Orange-OpenSource/BaahBox-Arduino/README.md

# Présentation
Cliquez sur l'image ci-dessous pour accéder à la présentation du projet Baah Box.

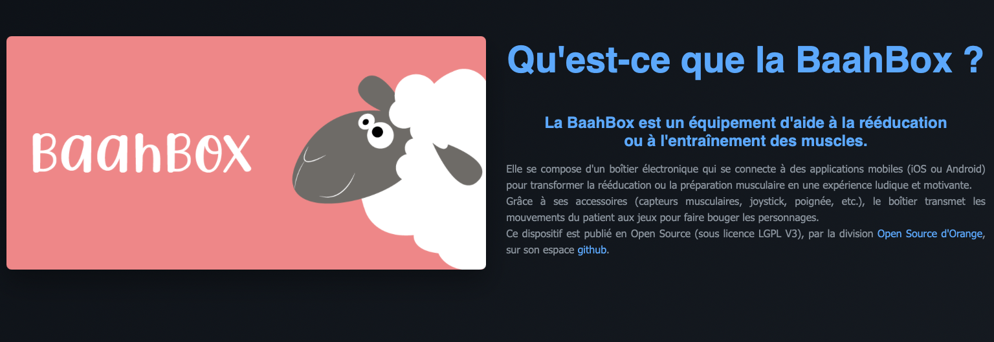
[picture p1: docs/assets/images/snapShopBBoxDoc.png]
BaahBoxPix (https://orange-opensource.github.io/BaahBox-Arduino/)
