Orange-OpenSource/BaahBox-Arduino/documentation/fr/BaahBoxBoM.md

# Liste du matériel / BOM 

Bom

* 1 feather M0 Bluefruit  (Adafruit Feather M0 Bluefruit LE)
 https://www.adafruit.com/product/2995 
   avec broches empilables courtes / with Header Kit for Feather
 https://www.adafruit.com/product/2886  

* 1 Feather Wing lecteur de carte SD / Adalogger FeatherWing - RTC + SD
https://www.adafruit.com/product/2922 
avec broches empilables longues / Stacking Headers for Feather
https://www.adafruit.com/product/2830 
 
* 1 Feather Wing écran OLED 128x32 (assemblée) / assembled Adafruit FeatherWing OLED 
 https://www.adafruit.com/product/3045 
  
* 1 carte mini SD (4 Go) / mini SD Card

* 1 batterie LiPo (max 1200 mA pour que cela rentre dans le boîtier)
   Lithium Ion Polymer Battery - 3.7v 1000 or 1200mAh 
   https://www.adafruit.com/product/258

* 1 interrupteur de type switch / Breadboard-friendly SPDT Slide Switch
 https://www.adafruit.com/product/805 
  
* 1  câble de connection JST-PH / 1 JST-PH Battery Extension Cable - 500mm 
 https://www.adafruit.com/product/1131
 
* 2 x 3.5mm connecteur jacks stéréo femelle / 2x 3.5 female Jack connectors
 
* 1 connecteur femelle  (Sub-D) DB9 / 1 Sub-D DB9 female connector
 
* 4 vis M2.5 x 25 ou 22 + écrous pour visser la feather sur le boîtier / 4 x M2.5 Machine Screws and Nuts

* 2 vis 3x8 + écrou pour visser le connecteur DB9 / 2 x M3x8 Screw ans Nuts

* fil de connection / connection cable

* manchons thermo-rétractables / heat-shrinkable tubes

* 1 boîtier à imprimer en 3D / 3D printed box (cf [stl](../3D/STLBaahBoxDB9.zip/))
