Orange-OpenSource/BaahBox-Arduino/documentation/fr/README.md

# Qu'est-ce que la Baah Box ?
La Baah Box est un équipement d’aide à la rééducation de muscles suite à un accident ou à un traumatisme, et qui comprend :

* Un boîtier (en jaune sur la photo ci-dessous)
* Divers capteurs musculaires (par ex. un joystick ou des détecteurs de contractions de muscles) 

Le boîtier est connecté via Bluetooth au téléphone mobile.
Des jeux sur le téléphone mobile permettent aux patients de faire bouger des personnages grâce aux contractions musculaires détectées par les capteurs.

BaahBoxPix

# A quoi sert la Baah Box ?

* Pour les accidentés:  **ré-apprendre** à utiliser des muscles en séance d’ergothérapie ou de kinésithérapie - mais aussi à la maison.
* Pour les personnes qui vont être équipées d'une prothèse myo-électrique:  **s’entraîner** au maniement de la prothèse.

# Pourquoi Baah ?

Parce que le mouton est un personnage récurrent de nos jeux … 
et que Baah, *c’est le cri du mouton !* (en anglais)

BaahBoxPix

## Quelques images de l'application iOS

<table>
	<tr>
		<td>
			The main menu of the iOS app
		</td>
		<td>
			The space game in the iOS app
		</td>
	</tr>
</table>

## Quelques images de l'application Android

<table>
	<tr>
		<td>
			The main menu of the Android app
		</td>
		<td>
			The balloon game in the Android app
		</td>
	</tr>
</table>

## Liens

* Les sources Arduino sont dans le répertoire *project* du repo [BaahBox-Arduino](https://github.com/Orange-OpenSource/BaahBox-Arduino)
* Les sources de l'application iOS: [BaahBox-iOS](https://github.com/Orange-OpenSource/BaahBox-iOS)
* Les sources de l'application Android: [BaahBox-Flutter-android](https://github.com/Orange-OpenSource/BaahBox-Flutter-android)
* Les ressources graphiques: [BaahBox-assets](https://github.com/Orange-OpenSource/BaahBox-assets)

# Vous avez une BaahBox et vous voulez jouer avec ?
Jetez un coup d'oeil sur le [Manuel d'utilisation](BaahBoxManual_fr.md)!

L'application BaahBox est sur les deux stores.
* BaahBox [android](https://play.google.com/store/apps/details?id=com.orange.labs.baahbox&pcampaignid=web_share)
* BaahBox [iOS](https://apps.apple.com/fr/app/baahbox/id1474621985)

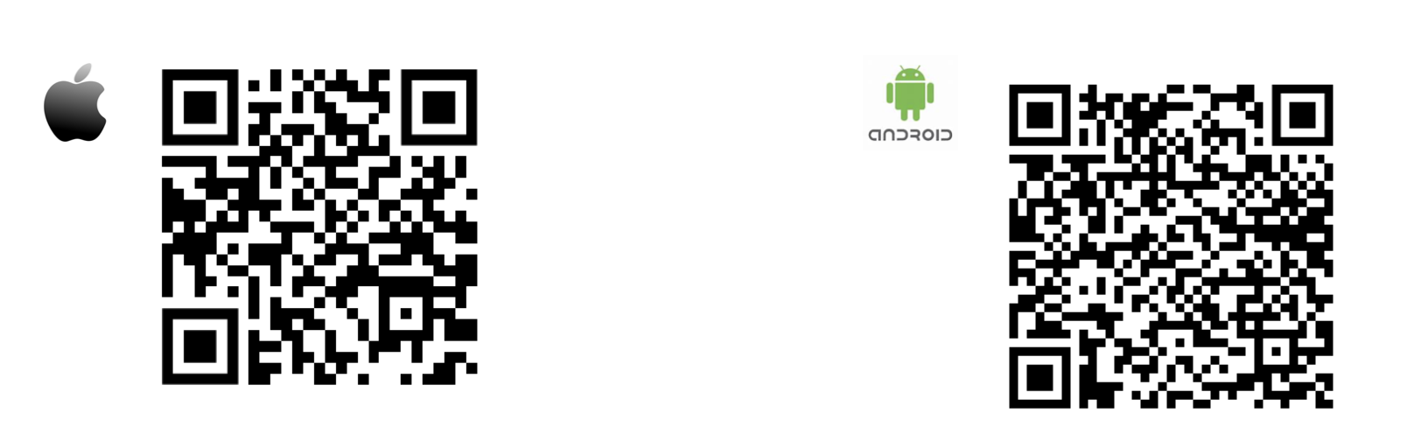
[picture p25: documentation/img/BBQRcodes.png]
BBQRcodes
 

Mais si vous voulez tester les version alpha:  
* Pour android c'est par [ici](https://github.com/Orange-OpenSource/BaahBox-Flutter-android/releases/), 

*  Pour iOS, contactez nous (frederique.pinson@orange.com) pour récupérer la version testflight de l'application iOS.

# Vous voulez une BaahBox ?

* **Option clef en main :** contactez le Fablab de Lannion (contact@fablab-lannion.org),
 qui pourra vous en fabriquer une à prix coûtant.

* **Option maker :**  fabriquez-la vous même !

## Fabriquez votre Baah Box

 Il vous faudra un peu de matériel éléctronique (notamment une carte arduino compatible Bluetooth 4.0 (BTLE), quelques connecteurs) et l'accès à une imprimante 3D pour fabriquer le boîtier. 
 [Suivez le guide !](BuildingBaahBox_fr.md)

## Téléchargez le code à mettre sur la Baah Box

Le coeur de la Baah Box est une petite carte Arduino...Il faut la programmer ! 

Vous trouverez le code arduino (et la documentation pour l'installer) dans le [répertoire projet du repo Arduino](../../project/)
 
## Fabriquez vos capteurs

Vous avez deux possibilités pour connecter des capteurs à la baah Box: 

* **Par les prises jack:**
 Tout capteur à une sortie analogique, compatible arduino et alimentable en 3.3V.
 Par exemple les capteurs myo-électriques présentés plus bas, ou des potentiomètres.
 
* **Via le connecteur DB9:**

 Ce connecteur permet de brancher sur la Baah Box des capteurs à sorties multiples comme un joystick de console de jeux (exemple présenté plus bas).
 Les sorties de celui que nous avons utilisé sont binaires, mais on peut avoir des sorties analogiques. Il faudra par contre modifier le code de la carte arduino pour prendre en compte un nouveau capteur.

### Exemples de capteurs 

Fabriquez un [joystick interactif ou des capteurs myo-électriques](./BaahBoxSensors_fr.md) pour votre Baah Box.
