Orange-OpenSource/BaahBox-Arduino/docs/assets/images/Baahbox_Hero_1024.webp

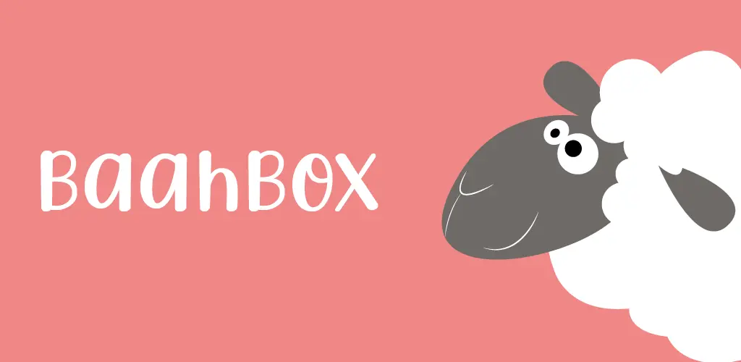
docs/assets/images/Baahbox_Hero_1024.webp
