Orange-OpenSource/BaahBox-Arduino/docs/assets/images/BaahBox_NMC25.webp

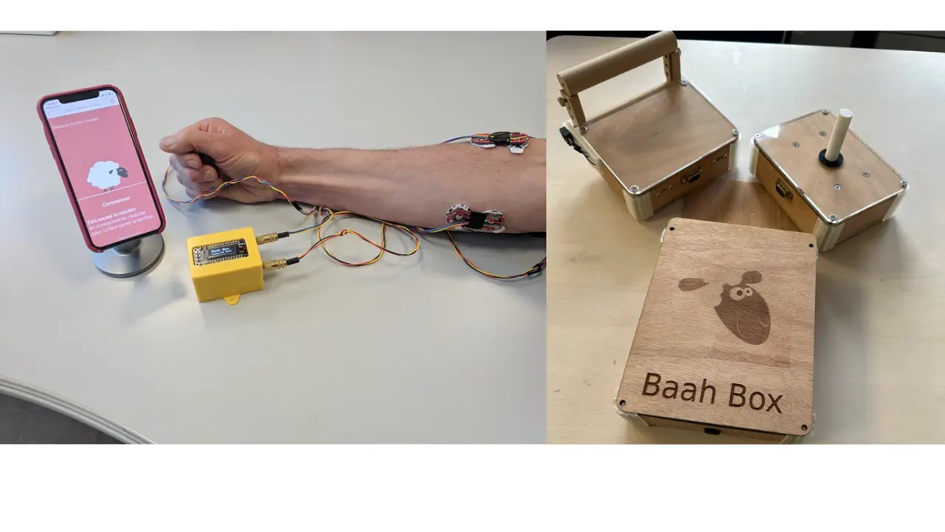
docs/assets/images/BaahBox_NMC25.webp
