Orange-OpenSource/BaahBox-Arduino/docs/assets/images/BaahStick.webp

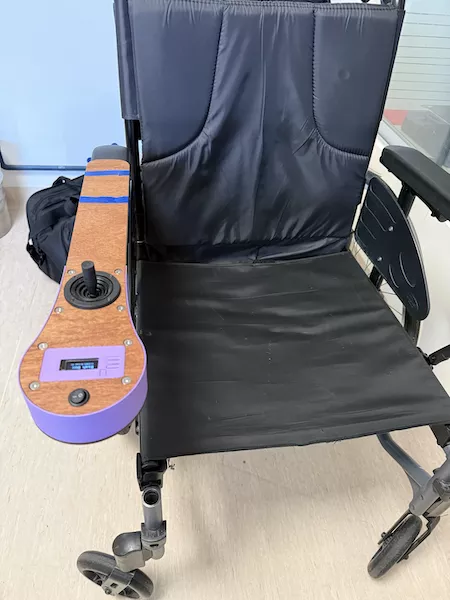
docs/assets/images/BaahStick.webp
