Orange-OpenSource/BaahBox-Arduino/docs/assets/images/BaahStickFromTop.webp

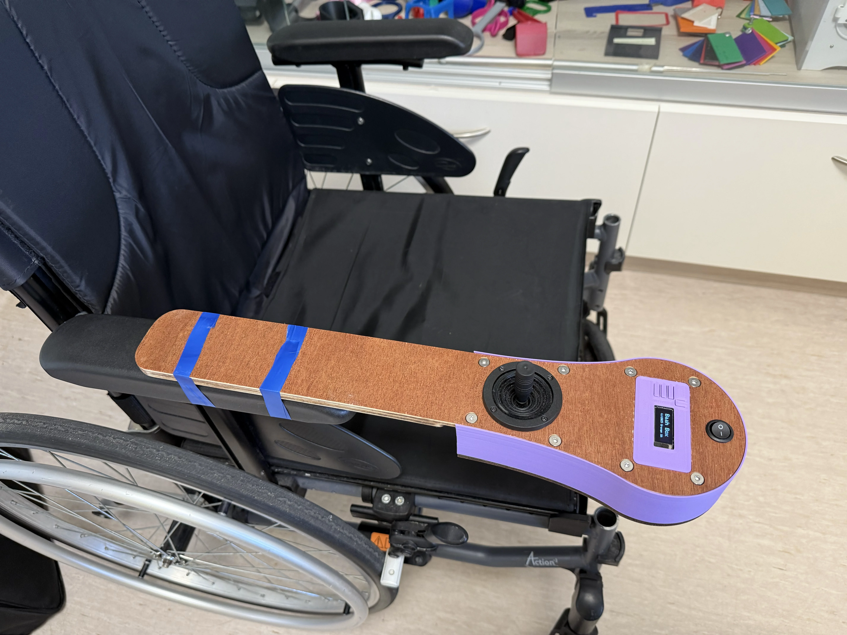
docs/assets/images/BaahStickFromTop.webp
