Orange-OpenSource/BaahBox-Arduino/docs/assets/images/BBoxJoystickLong.webp

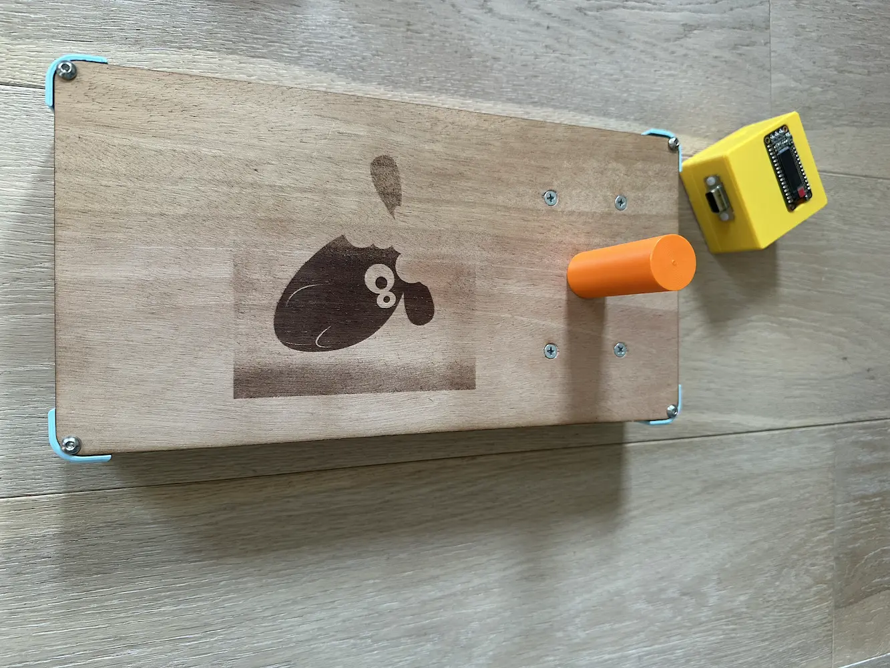
docs/assets/images/BBoxJoystickLong.webp
