Orange-OpenSource/BaahBox-Arduino/docs/assets/images/BBoxV4_Modules.webp

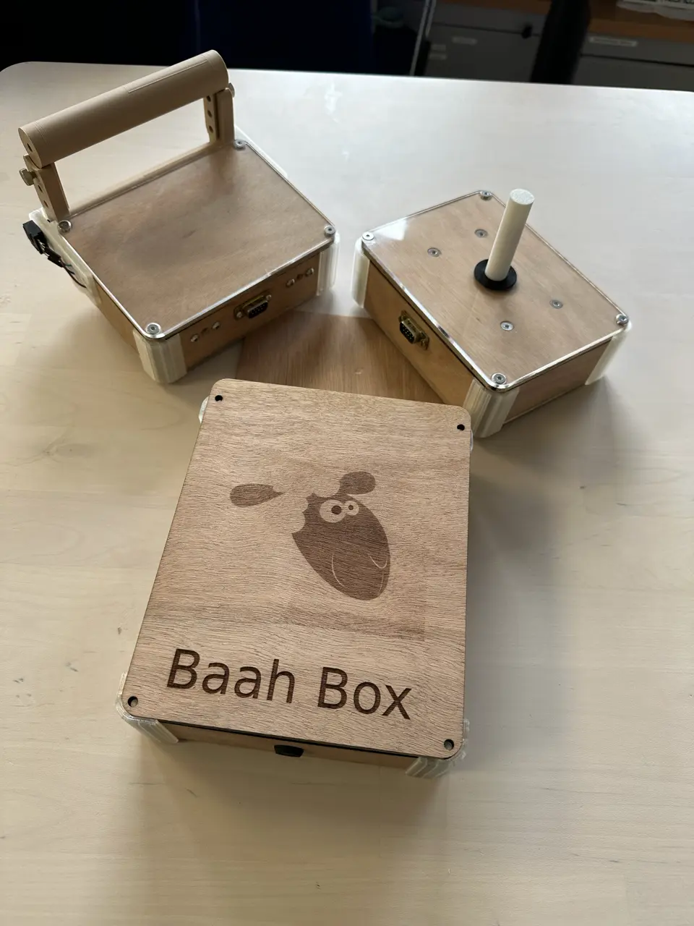
docs/assets/images/BBoxV4_Modules.webp
