Orange-OpenSource/BaahBox-Arduino/docs/assets/images/doc/Application/games/ballon.webp

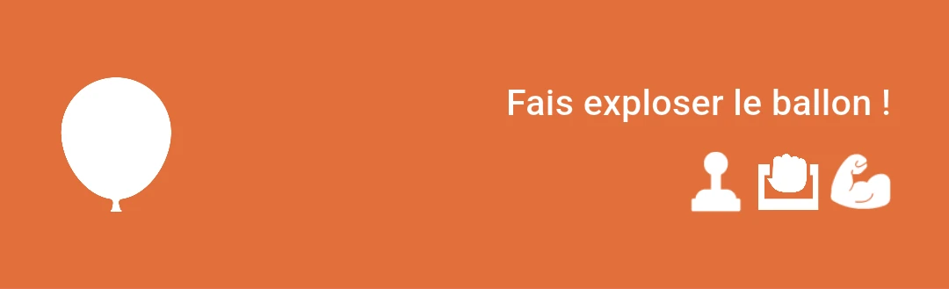
docs/assets/images/doc/Application/games/ballon.webp
