Orange-OpenSource/BaahBox-Arduino/docs/assets/images/doc/Application/games/ciel.webp

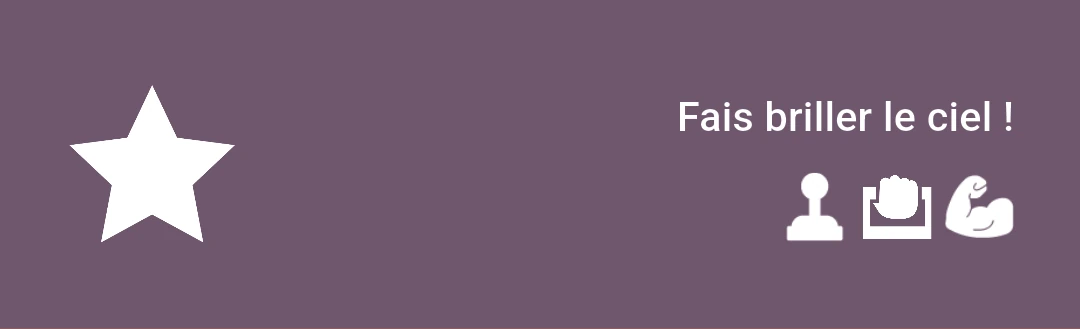
docs/assets/images/doc/Application/games/ciel.webp
