Orange-OpenSource/BaahBox-Arduino/docs/assets/images/doc/Application/games/explanation.webp

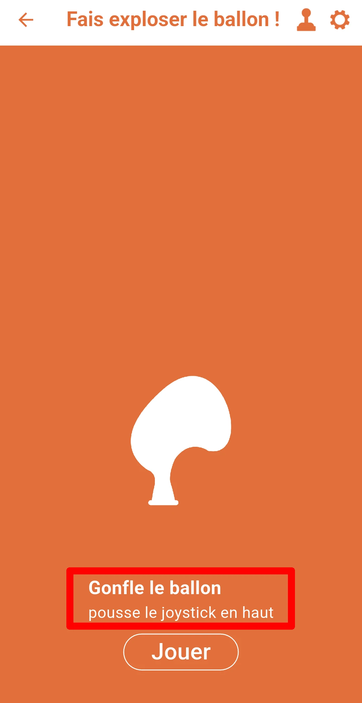
docs/assets/images/doc/Application/games/explanation.webp
