Orange-OpenSource/BaahBox-Arduino/docs/assets/images/doc/Application/games/labyrinthe3d.webp

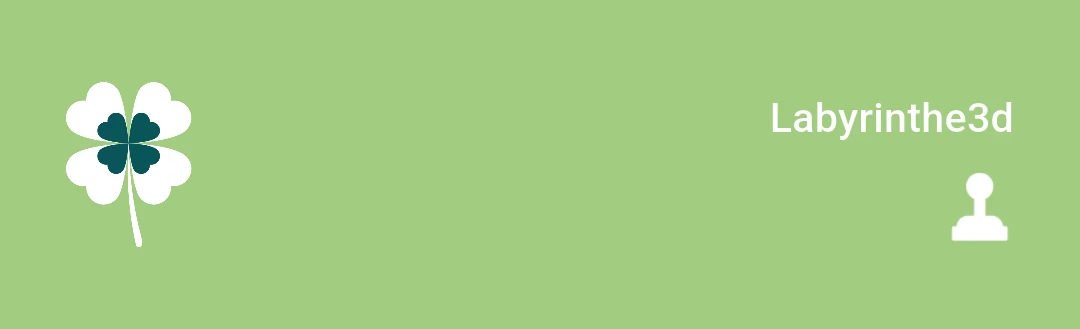
docs/assets/images/doc/Application/games/labyrinthe3d.webp
