Orange-OpenSource/BaahBox-Arduino/docs/assets/images/doc/Application/games/slurp.webp

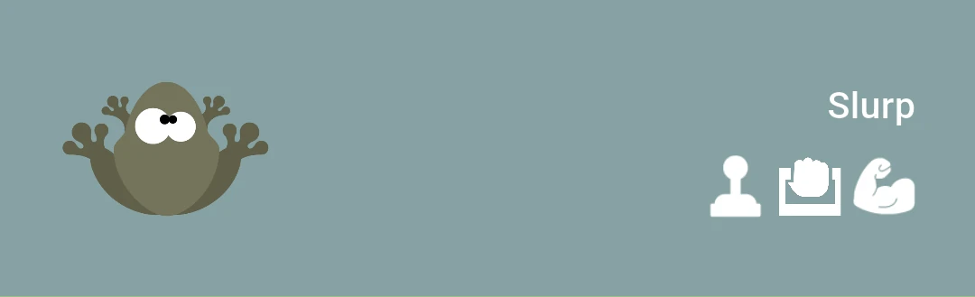
docs/assets/images/doc/Application/games/slurp.webp
