Orange-OpenSource/BaahBox-Arduino/docs/assets/images/doc/BaahBox/baah-box-start/baah-box.webp

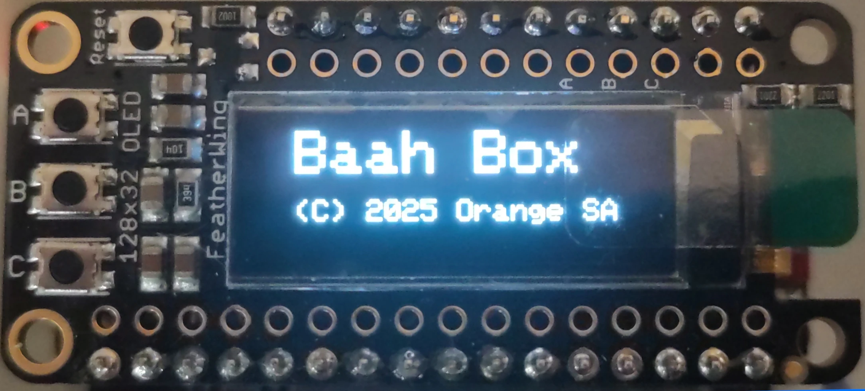
docs/assets/images/doc/BaahBox/baah-box-start/baah-box.webp
