Orange-OpenSource/BaahBox-Arduino/docs/assets/images/doc/BaahBox/Boitier.webp

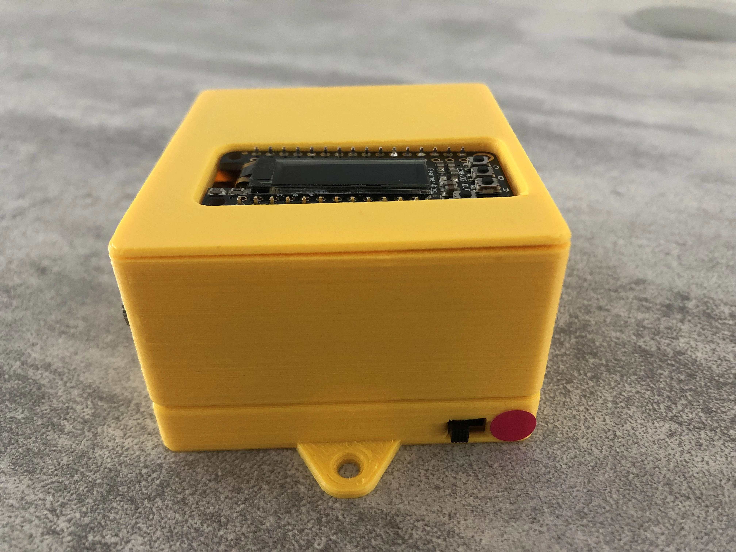
docs/assets/images/doc/BaahBox/Boitier.webp
