Orange-OpenSource/BaahBox-Arduino/docs/assets/images/doc/BaahStick/2capteurs.png

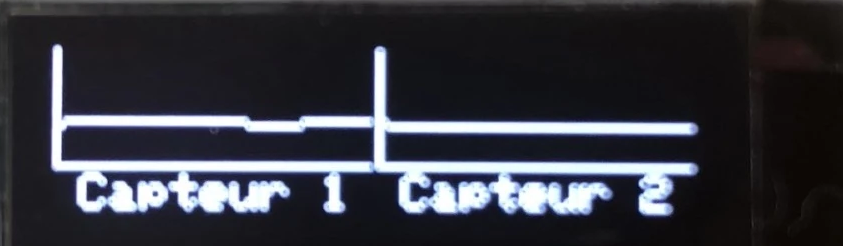
docs/assets/images/doc/BaahStick/2capteurs.png
