Orange-OpenSource/BaahBox-Arduino/docs/assets/images/doc/BaahStick/overview/joyBrasVueCoteOri.webp

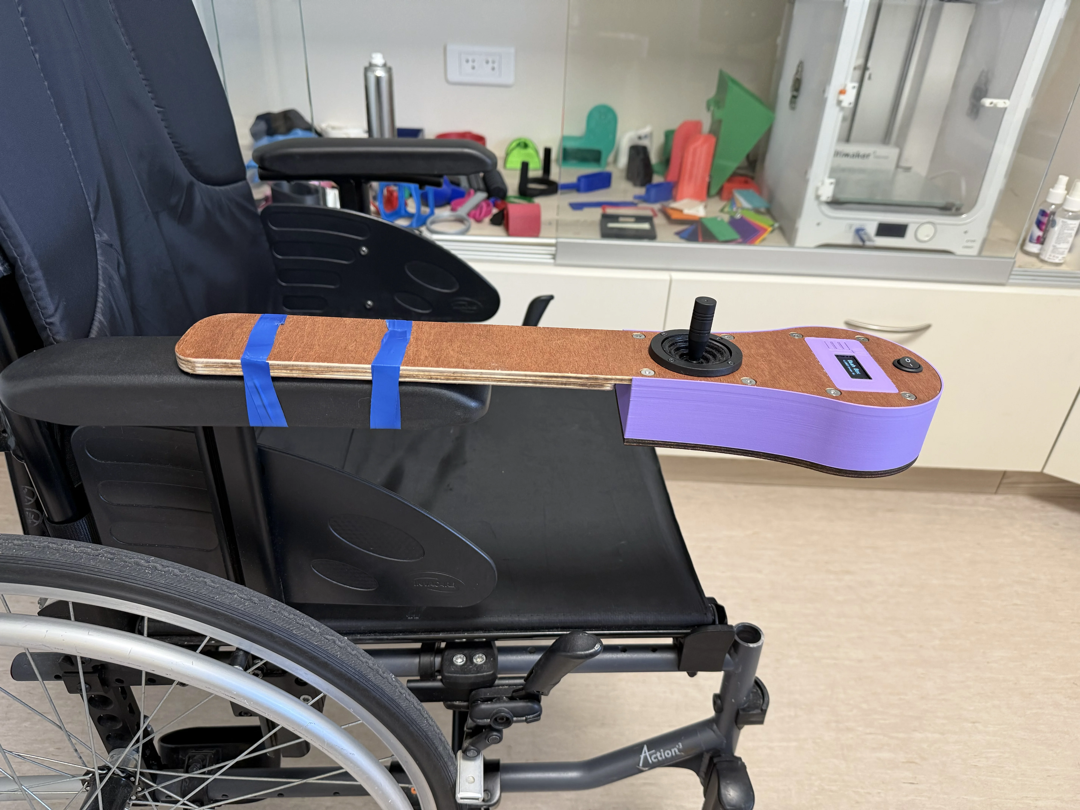
docs/assets/images/doc/BaahStick/overview/joyBrasVueCoteOri.webp
