Orange-OpenSource/BaahBox-Arduino/docs/assets/images/doc/BaahStick/overview/joyBrasVueDessus.webp

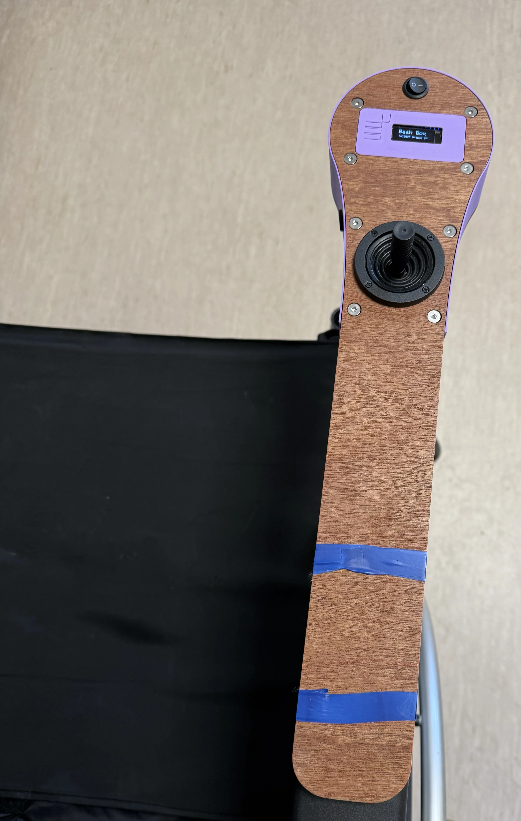
docs/assets/images/doc/BaahStick/overview/joyBrasVueDessus.webp
