Orange-OpenSource/BaahBox-Arduino/docs/assets/images/doc/BaahStick/overview/joyVueCoteCarre.webp

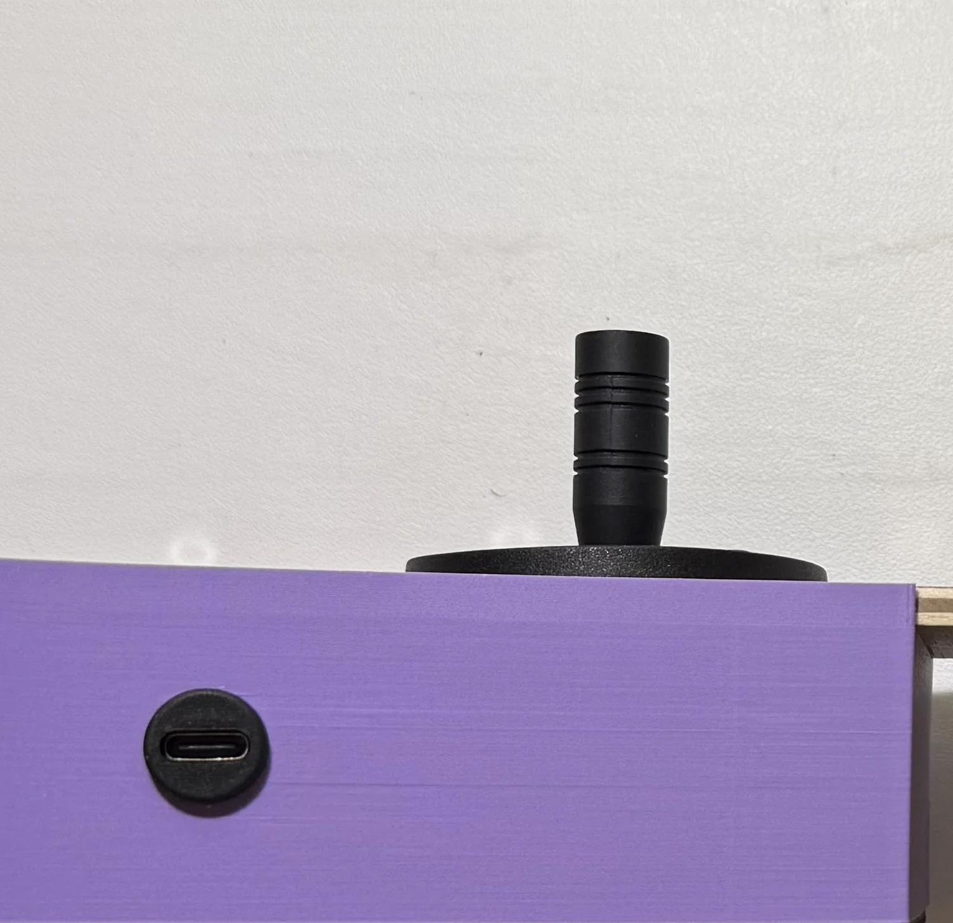
docs/assets/images/doc/BaahStick/overview/joyVueCoteCarre.webp
