Orange-OpenSource/BaahBox-Arduino/docs/assets/images/doc/games/menu_balloon.png

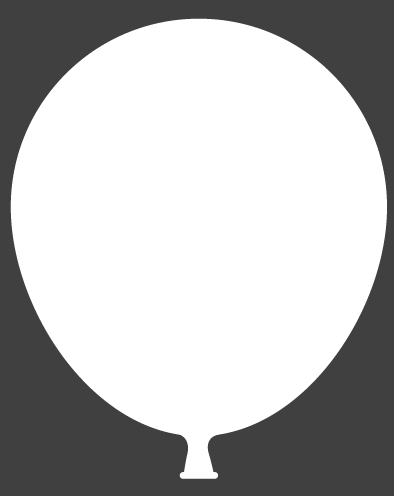
docs/assets/images/doc/games/menu_balloon.png
