Orange-OpenSource/BaahBox-Arduino/docs/assets/images/doc/games/menu_maze.png

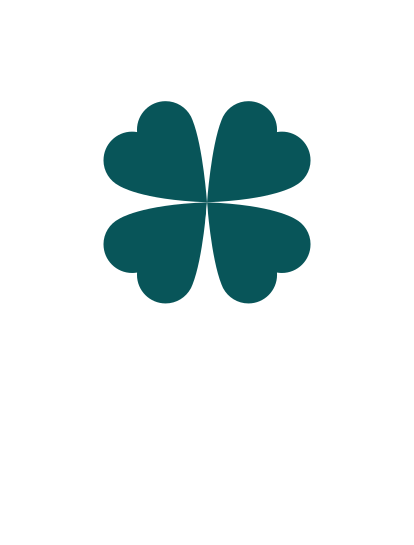
docs/assets/images/doc/games/menu_maze.png
