Orange-OpenSource/BaahBox-Arduino/docs/assets/images/doc/games/menu_sheep.png

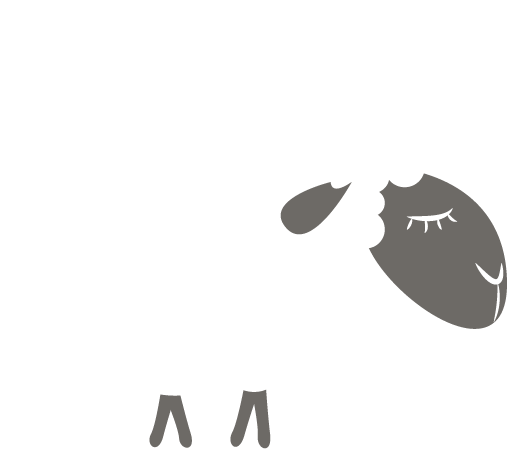
docs/assets/images/doc/games/menu_sheep.png
