Orange-OpenSource/BaahBox-Arduino/docs/assets/images/doc/games/menu_spaceShip.png

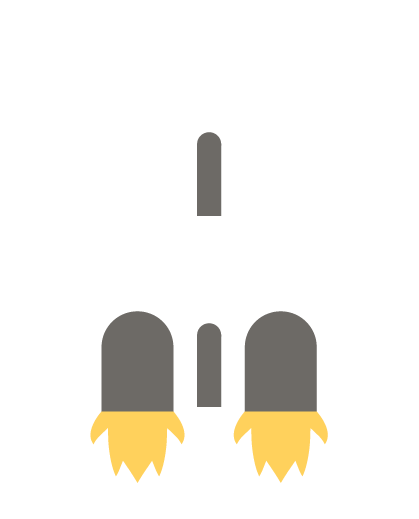
docs/assets/images/doc/games/menu_spaceShip.png
