Orange-OpenSource/BaahBox-Arduino/docs/assets/images/doc/games/menu_star.png

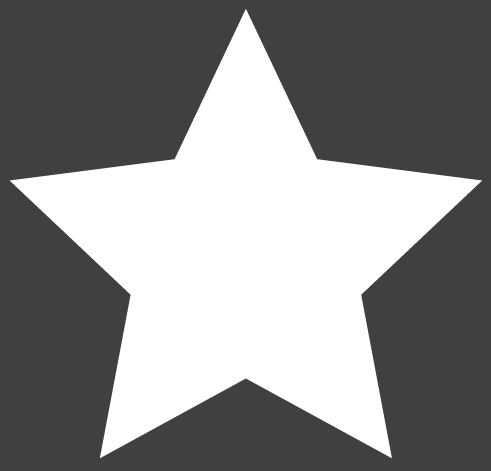
docs/assets/images/doc/games/menu_star.png
