Orange-OpenSource/BaahBox-Arduino/docs/assets/images/doc/games/menu_toad.png

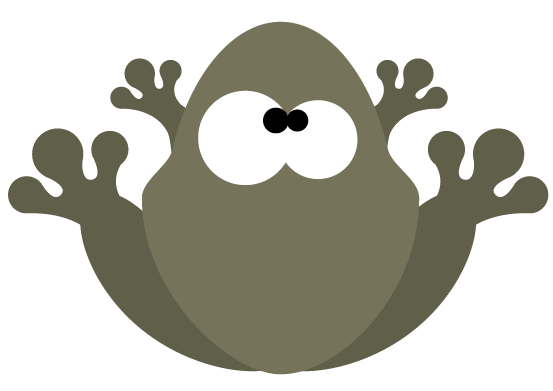
docs/assets/images/doc/games/menu_toad.png
