Orange-OpenSource/BaahBox-Arduino/docs/assets/images/doc/sensors/Joystick.webp

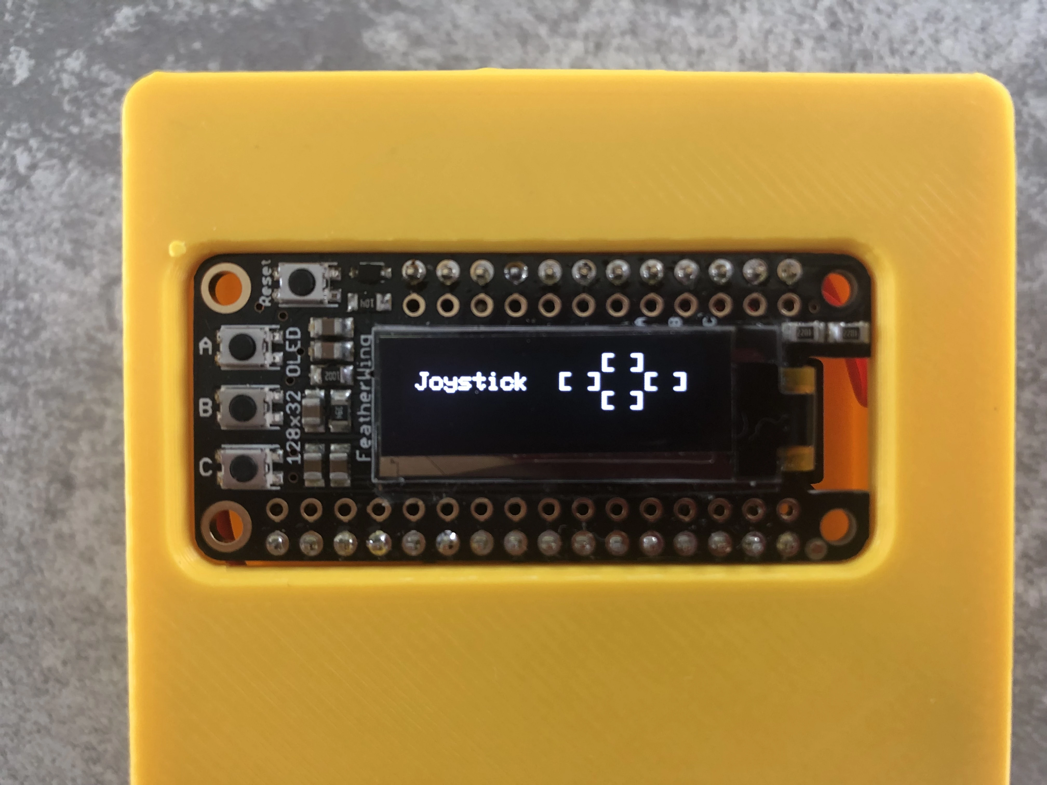
docs/assets/images/doc/sensors/Joystick.webp
