Orange-OpenSource/BaahBox-Arduino/docs/assets/images/JoystickYohann.png

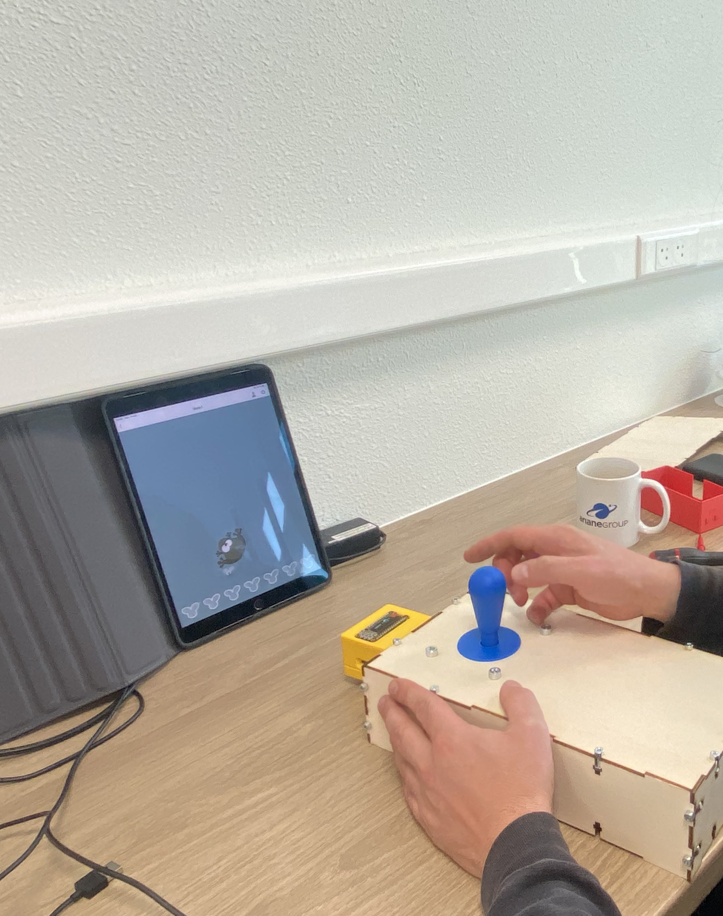
docs/assets/images/JoystickYohann.png
