Orange-OpenSource/BaahBox-Arduino/documentation/fr/DB9-outofBox.jpeg

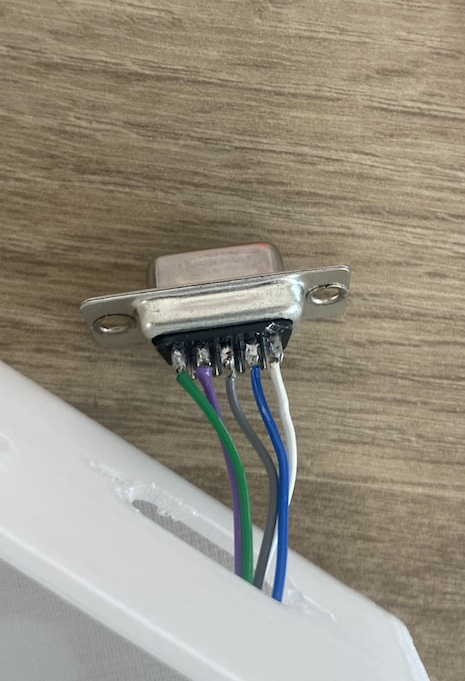
documentation/fr/DB9-outofBox.jpeg
