Orange-OpenSource/BaahBox-Arduino/documentation/img/BaahBox_joystick.jpg

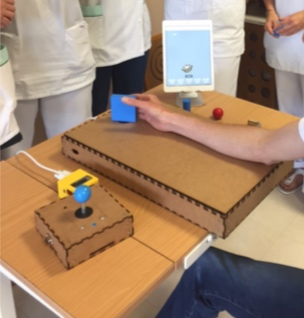
documentation/img/BaahBox_joystick.jpg
