Orange-OpenSource/BaahBox-Arduino/documentation/img/Battery.jpg

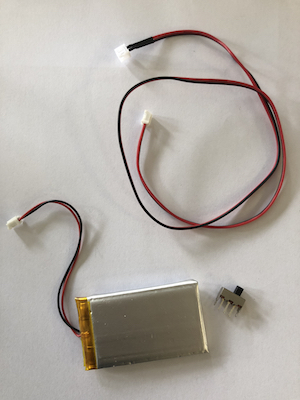
documentation/img/Battery.jpg
