Orange-OpenSource/BaahBox-Arduino/documentation/img/Feather_DB9_Jacks_Soudes.jpg

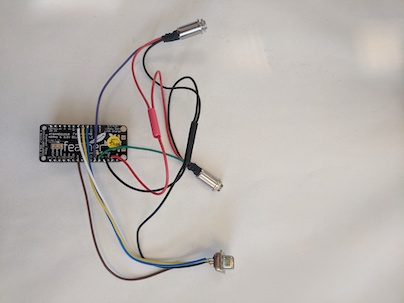
documentation/img/Feather_DB9_Jacks_Soudes.jpg
