Orange-OpenSource/BaahBox-Arduino/documentation/img/Full_stack.jpg

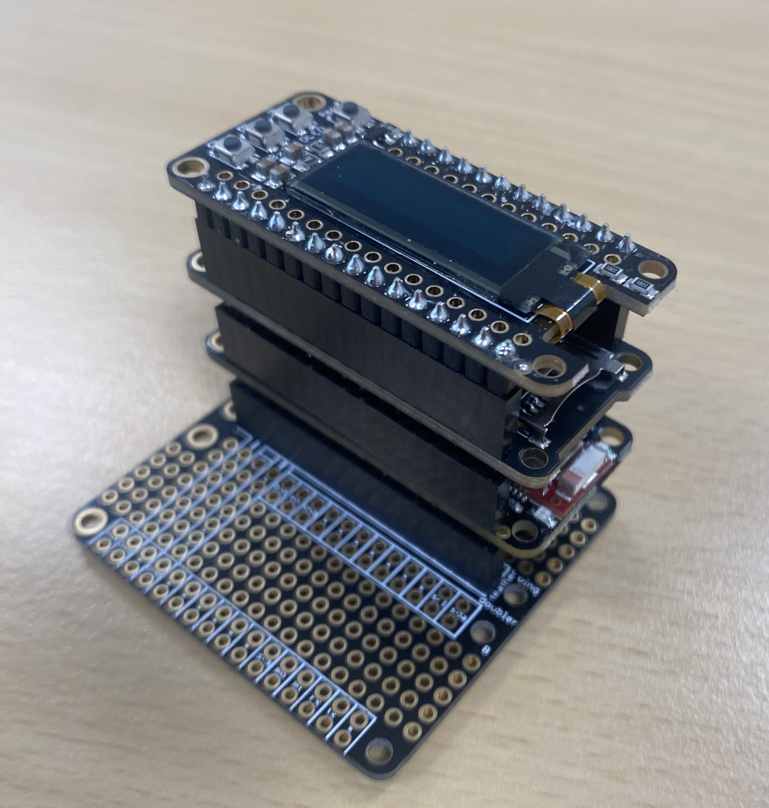
documentation/img/Full_stack.jpg
