Orange-OpenSource/BaahBox-Arduino/documentation/img/JoystickConnections.jpg

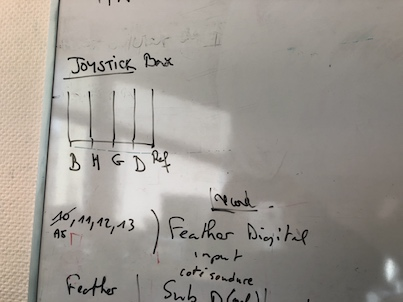
documentation/img/JoystickConnections.jpg
