Orange-OpenSource/BaahBox-Arduino/documentation/img/M0_stacked.jpg

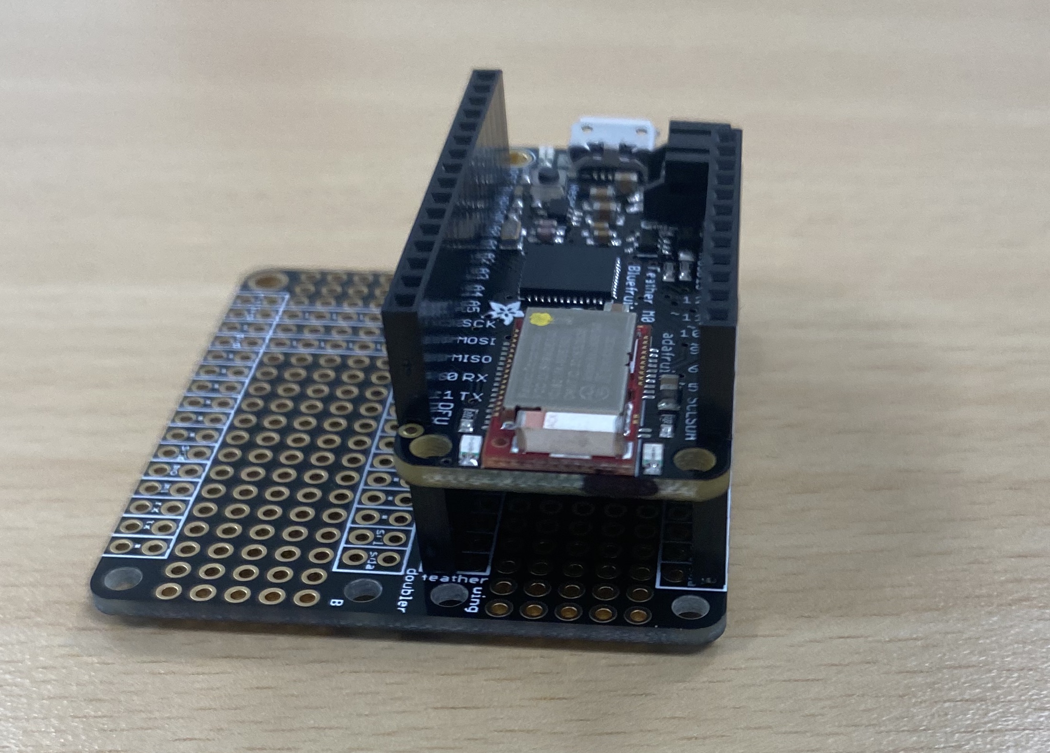
documentation/img/M0_stacked.jpg
