Orange-OpenSource/BaahBox-Arduino/documentation/img/muscle-Sensor-layout.jpg

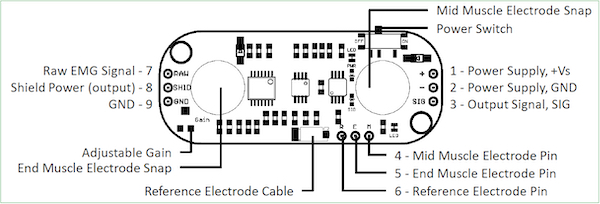
documentation/img/muscle-Sensor-layout.jpg
