Orange-OpenSource/BaahBox-Arduino/documentation/img/sensor-270x300.jpg

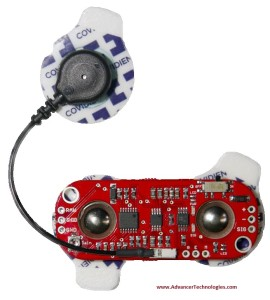
documentation/img/sensor-270x300.jpg
