Orange-OpenSource/BaahBox-Arduino/documentation/img/BOM/DB9F.jpg

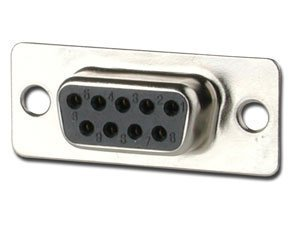
documentation/img/BOM/DB9F.jpg
