Orange-OpenSource/BaahBox-Arduino/documentation/Hardware/Joystick/angle.stl

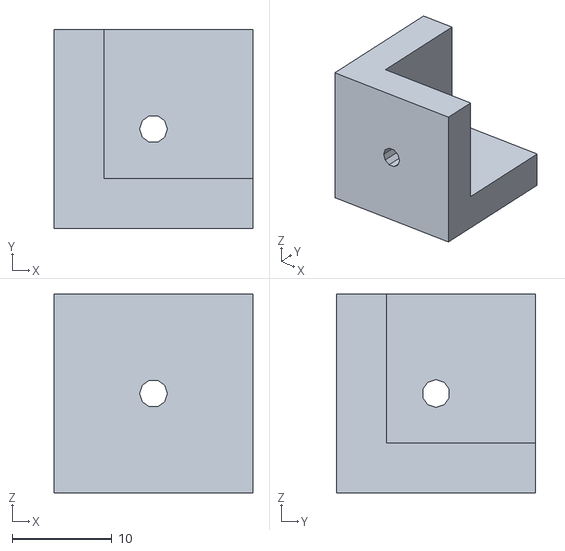
[picture p61: CAD file, 2024-01-23]
documentation/Hardware/Joystick/angle.stl
20.0 x 20.0 x 20.0
