Orange-OpenSource/BaahBox-Arduino/documentation/en/BuildingBaahBox_en.md

# Building a Baah Box

BOM

# Equipment
The Baah Box is basically stack of arduino + shield cards :
 * a BTLE compatible arduino card
 * a prototyping shield 
 * a SD reader shield - with a 4GB SD card
 * a TFT screen shield
 
  and connectors (2 jacks and / or a DB9 connector), all in a 3D printed case.

The jacks are used to connect sensors to a single analog output such as myoelectric sensors or potentiometers (sliders). The jacks can be used independently alone or together.

The DB9 connector is used to connect a sensor with several (digital) outputs. You can connect an arcade joystick, for example.

The current code allows you to use either the jacks or the DB9, but not both at the same time. Since they do not use the same entries on the card, it should be fairly easy to update the code in order to allow simultaneous use .

### The list of items in the Baah Box is [here](./BaahBoxBoM_en.md).

## Choice of hardware

* We have chosen to take hardware that is easy to find (in an electronics store or on the internet). We wanted any "maker" with a 3D printer and able to make simple welds to make a Baah Box. *

The *"form factor"* of the cards we have chosen (Feather from Adafruit) makes it possible to stack them, and therefore to avoid the use/build of a specific printed circuit. This means that the construction of the box requires very little soldering.

It is quite possible to use other cards, byou will just have to modify the 3D enclosure and adapt the code (mainly arduino libraries dedicated to the card you want to use).

## Printing the box
(download and print the [STL files](../Hardware/BaahBox/)).
The design of our box is an adaptation of this one, [proposed by Adafruit](https://learn.adafruit.com/3d-printed-case-for-adafruit-feather) for its Feather cards.
Adafruit offers [settings](https://learn.adafruit.com/3d-printed-case-for-adafruit-feather/3d-printing) for Cura and Simplify3D, which we recommend using.

## Arduino code

Please check the documentation [here](../../project/README.md) !

## Electronic

### Power
So that the box can be used anywhere, we added a battery, and a switch.
It is not mandatory to operate the card, which can just be connected to a usb power supply (5V).

We use the assembly proposed by Adafruit for [power](https://learn.adafruit.com/on-slash-off-switches)
You will find there all the information for the assembly to realize the cable below.

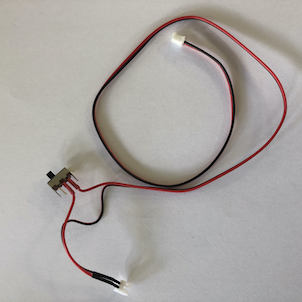
[picture p62: documentation/img/SwitchConnection.jpg]


### Connectivity
We plug two types of connectors on the card:
stereo jacks and a DB9 connector.

To power the connectors, you can start by soldering
* the red wire on the 3.3V pin
* the black wire on the Feather.

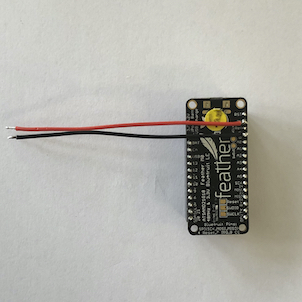
[picture p63: documentation/img/Feather_PowerCables.jpg]


#### Jacks
The jacks are used to connect analog sensors to an output.
You need to solder 3 wires: Vcc, GND and signal.

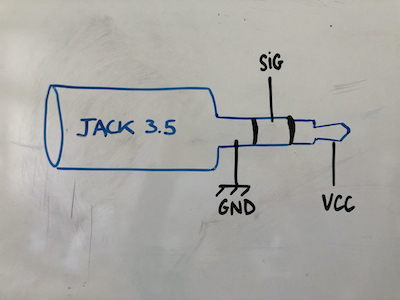
[picture p64: documentation/img/JACK_Herve_400x300.jpg]


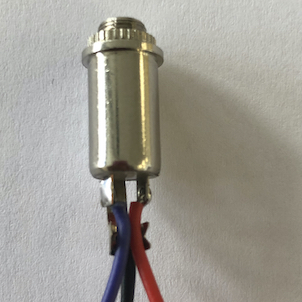
[picture p65: documentation/img/Jack.jpg]


We solder the "signal" cables (blue and green) of the jack on the analog pins A0 and A1 of the Feather.

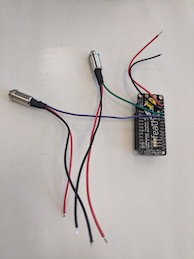
[picture p66: documentation/img/Feather_JackConnection.jpg]


We solder the red wires (Vcc) of the jacks and the feather together.
We see in the pict that we use a heat-shrinkable sheath after soldering to avoid short circuits.

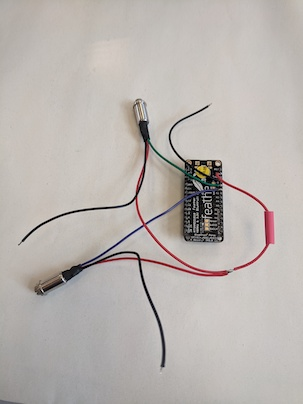
[picture p67: documentation/img/Feather_JackPowerConnection.jpg]


#### DB9
The DB9 is used to connect a sensor to several (digital) outputs. We connect a joystick to this DB9 connector, which does not need to be powered.
By cons we need to connect 5 cables:
* A wire (black) which will serve as a reference (soldered to ground (GND),
* 4 wires for the contactors of the different positions of the Joystick.

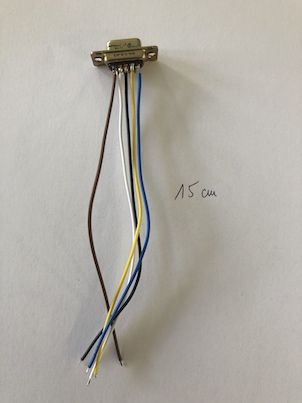
[picture p68: documentation/img/DB9.jpg]


We solder together the black wires (GND) of the jacks and dB9 with the Feather one
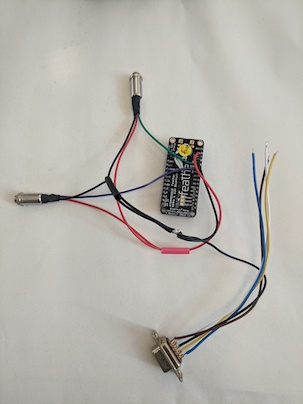
[picture p69: documentation/img/Feather_Jack_And_DB9_GroundConnection.jpg]


Then we solder the connector wires on the Feather, according to the table below:

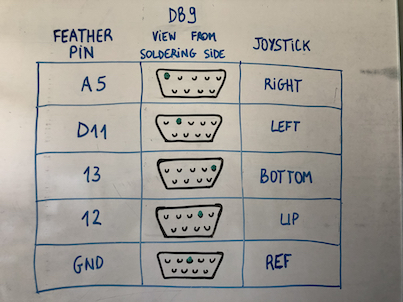
[picture p70: documentation/img/Tableau_DB9_Feather_Joystick_herve_400x300.jpg]


We see on this diagram the correspondence with the positions of the joystick which will be connected to it.
For example: when the Joystick is in the high position, the signal from pin 12 of the Feather will go from 0 to 1.

## Assembling

Once everything is soldered, you have to put everything in the box!

We use the user manual provided by Adafruit to assemble the feather box with a battery, adding our modifications (adding connectors).
We advise you to follow the steps as indicated in this [user manual](https://learn.adafruit.com/3d-printed-case-for-adafruit-feather/assembly), adding the screwing of the connectors on the box.

- We start by positioning the battery and the switch

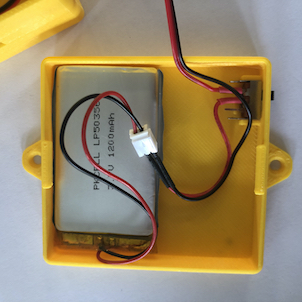
[picture p71: documentation/img/BatteryAndSwitchInBox.jpg]


- We pass the battery connector through the hole in the bottom of the case
- We put the feather in place in the case.

As the cards pile up, you have the choice to screw only the feather in the case then stack the shields of the SD card and the screen (on top).

With the screws between 19 and 25mm long, you can screw the feather and the SD card.
The screen shield is just clipped on.

- We screw the jacks in the two circular holes on the front side

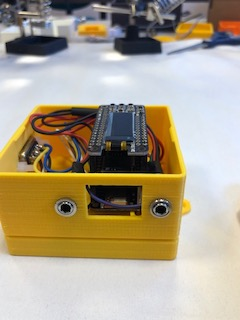
[picture p72: documentation/img/jacks_holes_small.jpg]


 and the DB9 in its insert on the side of the box.

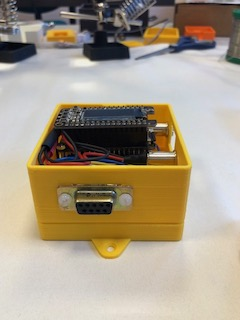
[picture p73: documentation/img/DB9_hole_small.jpg]
 

Everything is in the box, you have to close ...

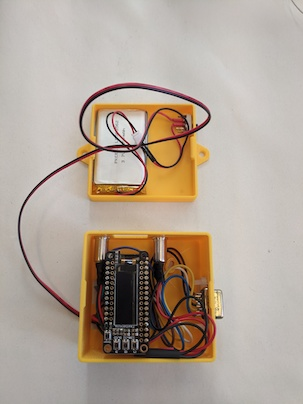
[picture p74: documentation/img/boite_montee_2part.jpg]


And here is the box mounted!

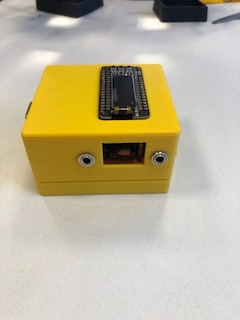
[picture p75: documentation/img/boitier_fini_small.jpg]
