Orange-OpenSource/BaahBox-Arduino/documentation/en/BaahBoxManual_en.md

# Baah Box User Guide

#### Version 0.1 28/05/2019

<div style="text-align:center" markdown="1">
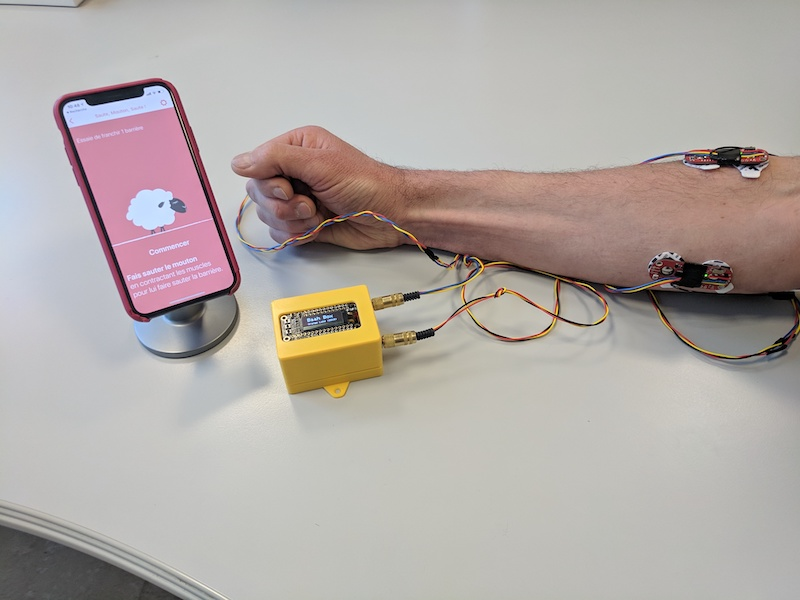
[picture p97: documentation/img/BaahBoxManual/photoBaaBox.jpg]

</div>

<p style="page-break-after: always;">&nbsp;</p>

## Initialisation
- Connect the sensors to the box (via the jack sockets, as in the photo above)

- Switch on with the small switch on the side of the box (switch to the red tape).

##### Warning: The start-up may take several seconds.

<div style="text-align:center" markdown="1">
<img src="../img/BaahBoxManual/Boitier.jpg"" width="200">
</div>
<BR/>

- Wait 2-3 s until the screen displays small white dots.
<div style="text-align:center" markdown="1">
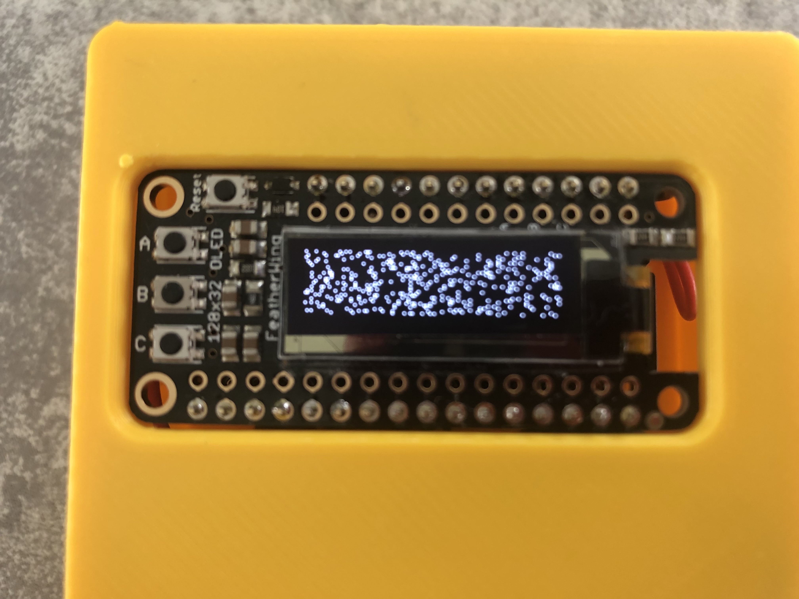
[picture p98: documentation/img/BaahBoxManual/Neige.jpg]

</div>

- Press the **Reset** button at the top left of the screen, and after 2s the screen displays "Baah Box":
<div style="text-align:center" markdown="1">
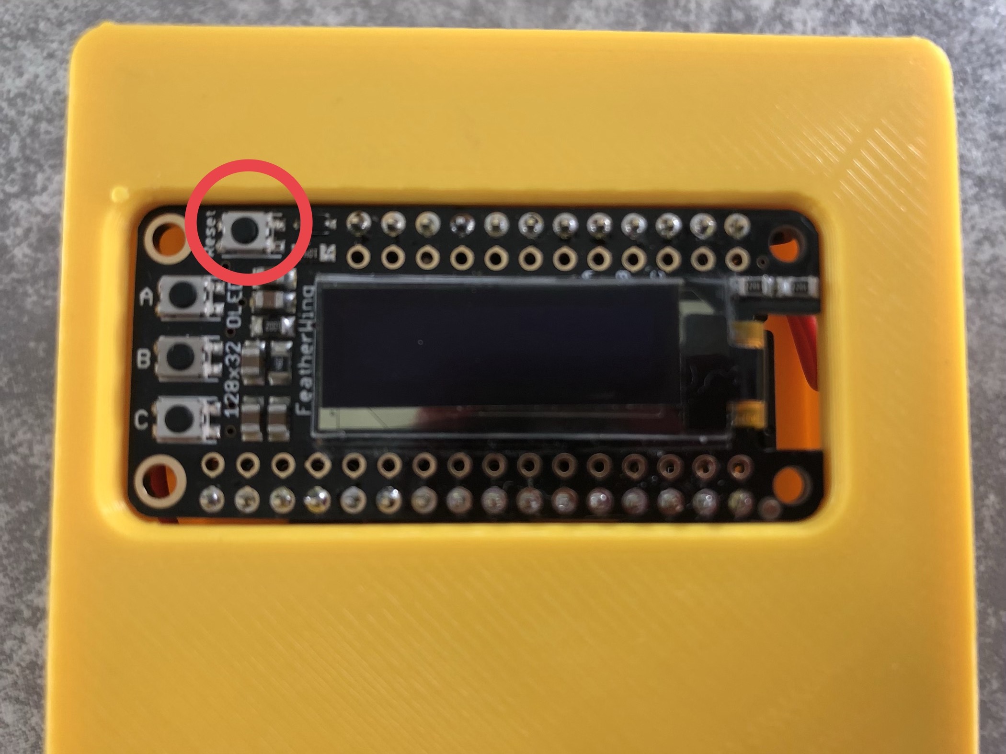
[picture p99: documentation/img/BaahBoxManual/Reset.jpg]

</div>
<BR/>

## Check the behavior of the sensors

- Put the sensors on the muscles to be trained.

- Press the **-B-** button to display the curves of the data sent by the sensors.

- A press displays the 2 sensors,
<div style="text-align:center" markdown="1">
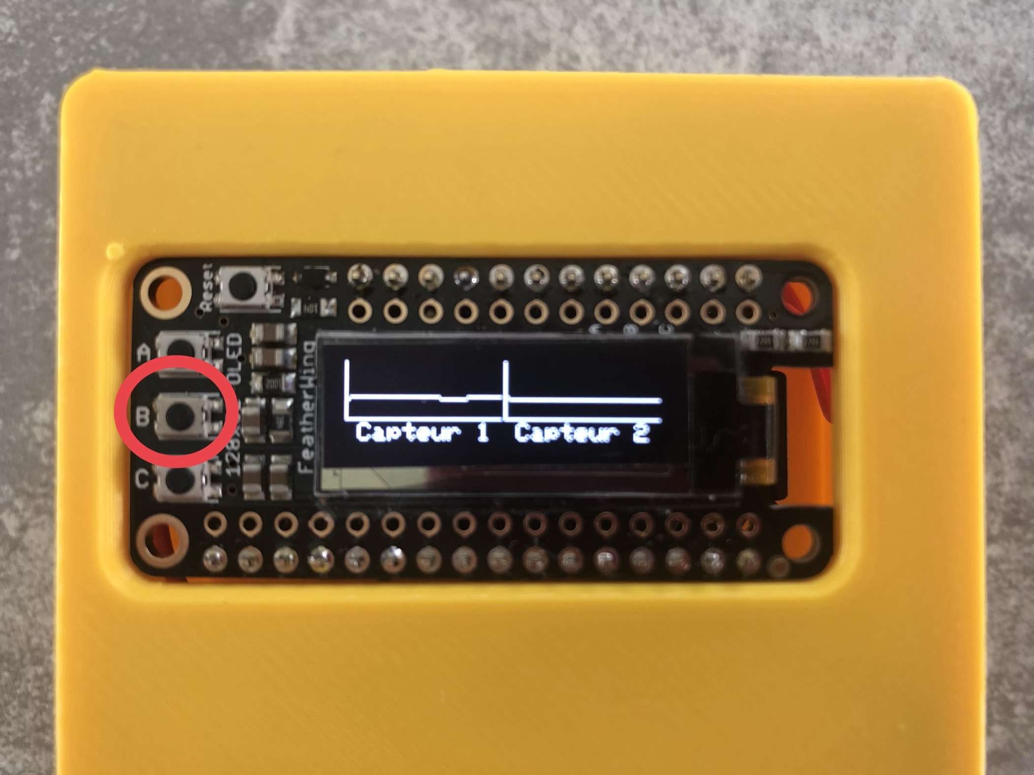
[picture p100: documentation/img/BaahBoxManual/2Capteurs.jpg]

</div>
- Second press display sensor 1 only,

<div style="text-align:center" markdown="1">
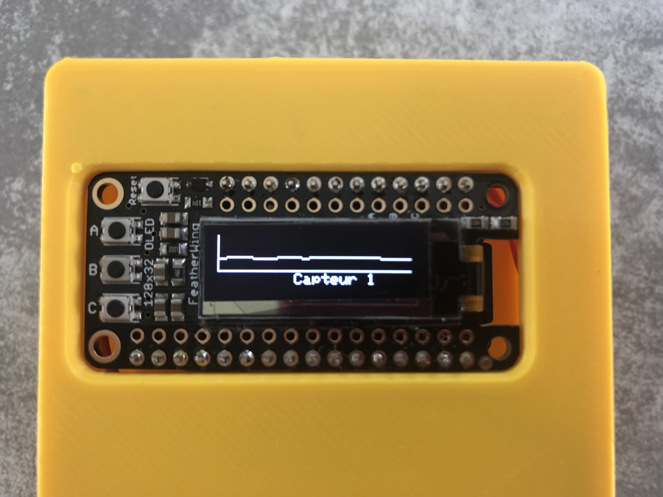
[picture p101: documentation/img/BaahBoxManual/Capteur1.jpg]

</div>

- 3rd press display sensor 2 only,
<div style="text-align:center" markdown="1">
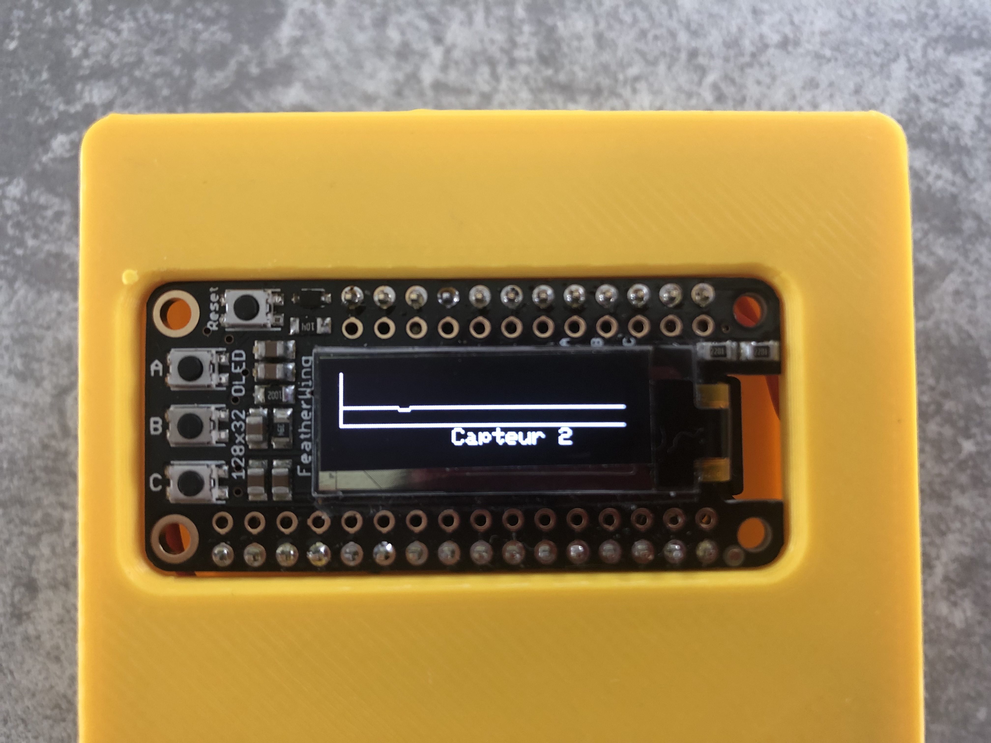
[picture p102: documentation/img/BaahBoxManual/Capteur2.jpg]

</div>

- 4th press display joystick status,
<div style="text-align:center" markdown="1">
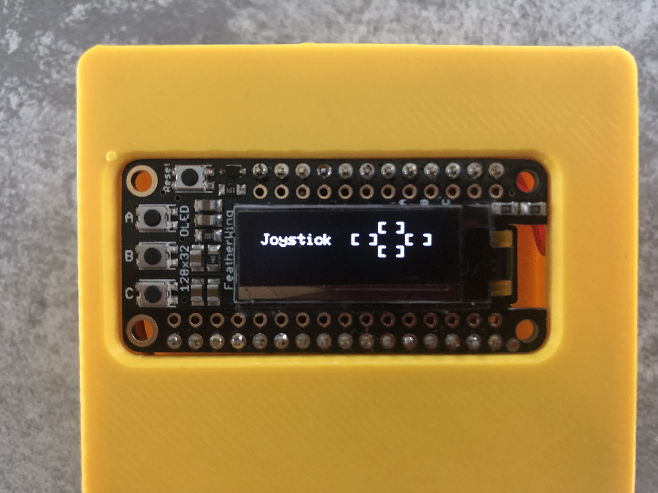
[picture p103: documentation/img/BaahBoxManual/Joystick.jpg]

</div>
- One more press go back to display with 2 sensors.

## General information about the box

- Press **-C** button to display box global settings.

<div style="text-align:center" markdown="1">
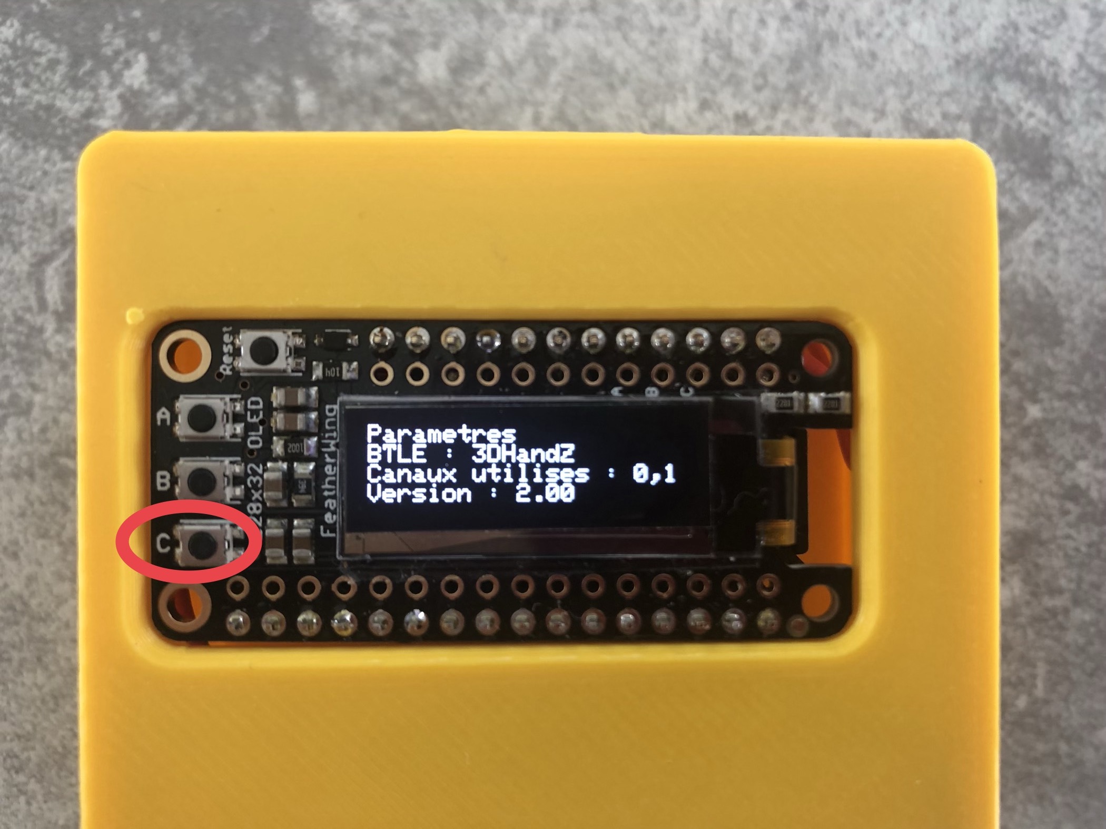
[picture p104: documentation/img/BaahBoxManual/Parameter1.jpg]

</div>

- A second press display battery level
<div style="text-align:center" markdown="1">
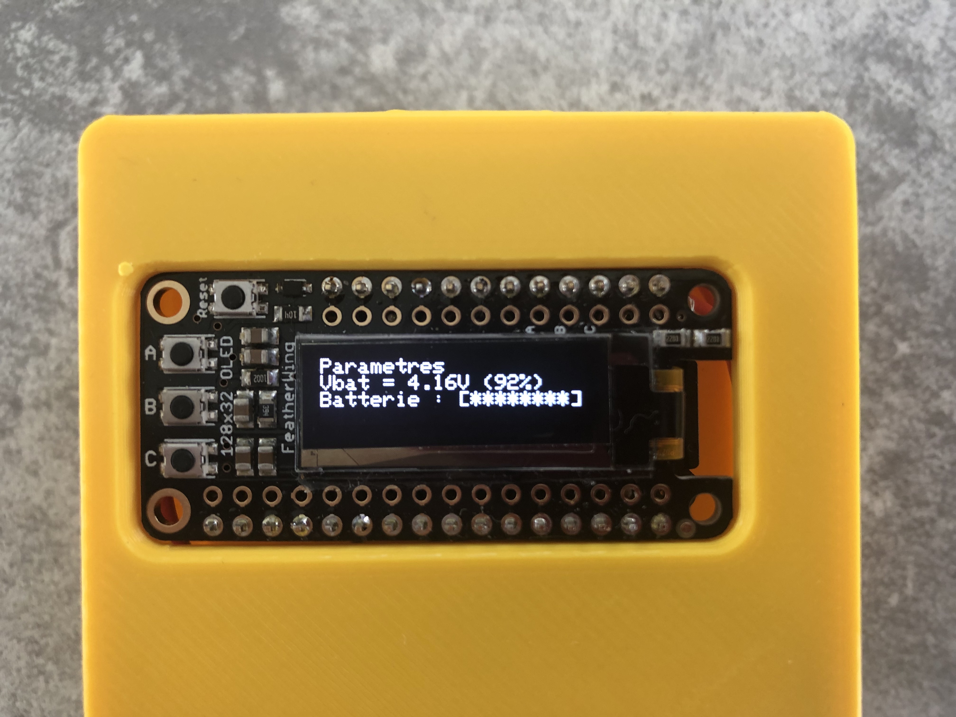
[picture p105: documentation/img/BaahBoxManual/Parameter2.jpg]

</div>

<p style="page-break-after: always;">&nbsp;</p>

## Connection to mobile application

- Check that bluetooth is activated on the mobile/tablet

- Run **Baah!** game on the mobile/tablet

- A message is displayed to ask to choose the Baah Box you want to connect to

<div style="text-align:center" markdown="1">
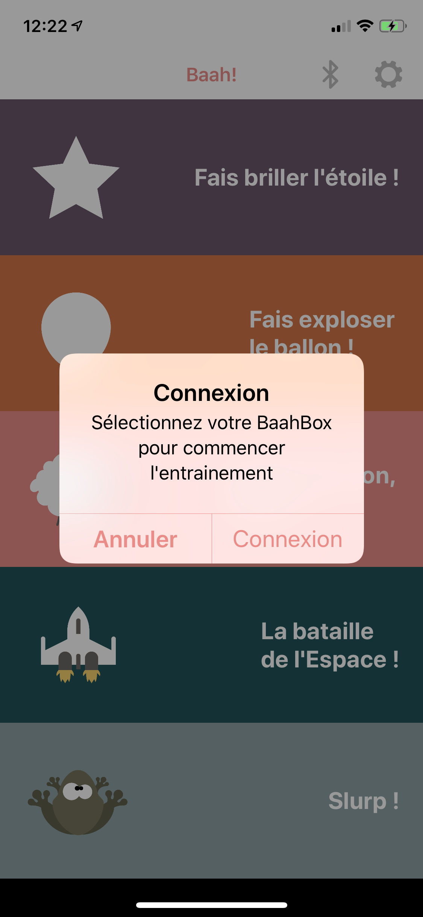
[picture p106: documentation/img/BaahBoxManual/Screen Shot 2019-01-24 at 12.22.40.png]

</div>

- tap on **"Connection"**

Connection screen is displayed

- choose the box in the list __-and-__ tap on OK upper right

<div style="text-align:center" markdown="1">
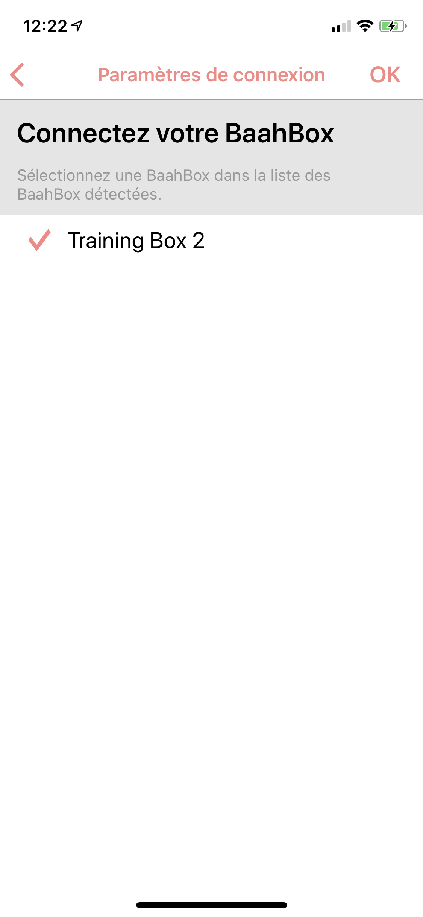
[picture p107: documentation/img/BaahBoxManual/Screen Shot 2019-01-24 at 12.22.58.png]

</div>

### Go back to the main menu by using the upper left arrow.

<div style="text-align:center" markdown="1">
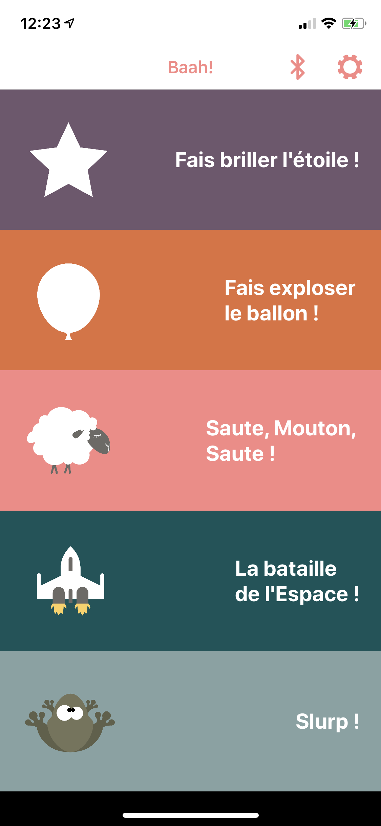
[picture p108: documentation/img/BaahBoxManual/Screen Shot 2019-01-24 at 12.23.08.png]

</div>

## Choose a game in the list

For each game, an animation show you how to play.  Press **"Start"** to play.

### Important information for games

#### Don't forget to close the application on the mobile/tablet after each use.

<p style="page-break-after: always;">&nbsp;</p>

## Settings

To access the different settings, press the small notched wheel located at the top right of the screen of the mobile / tablet.

##### Several categories of settings are available:

- Connection: to select another BaahBox
- General:
	- Activate demo mode
	- Select sensors to use
	- Adjust the sensitivity of the games and the detection threshold of the sensors
- Game management: to adjust the parameters specific to each game

<div style="text-align:center" markdown="1">
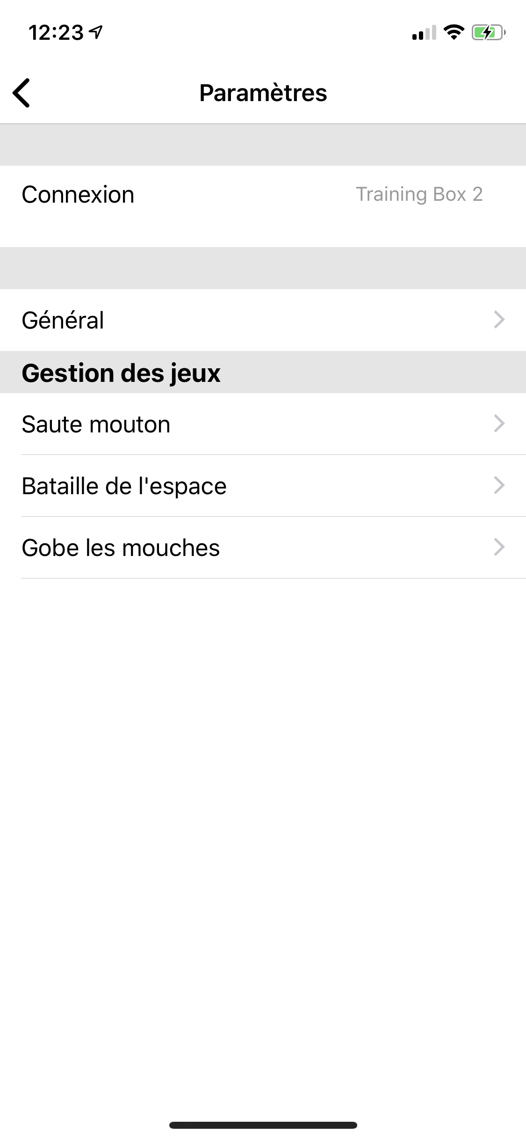
[picture p109: documentation/img/BaahBoxManual/Screen Shot 2019-01-24 at 12.23.18.png]

</div>

### Connection setting
This part manages the connection and disconnection of your BaahBox.

Select the BaahBox from the list. Then press OK at the top right of the screen.
When the connection is successful, the application go back to the previous screen.

If your mobile is already connected to a BaahBox, it will appear with a check mark on its left. Press the "Logout" button to logout from this BaahBox.

<div style="text-align:center" markdown="1">
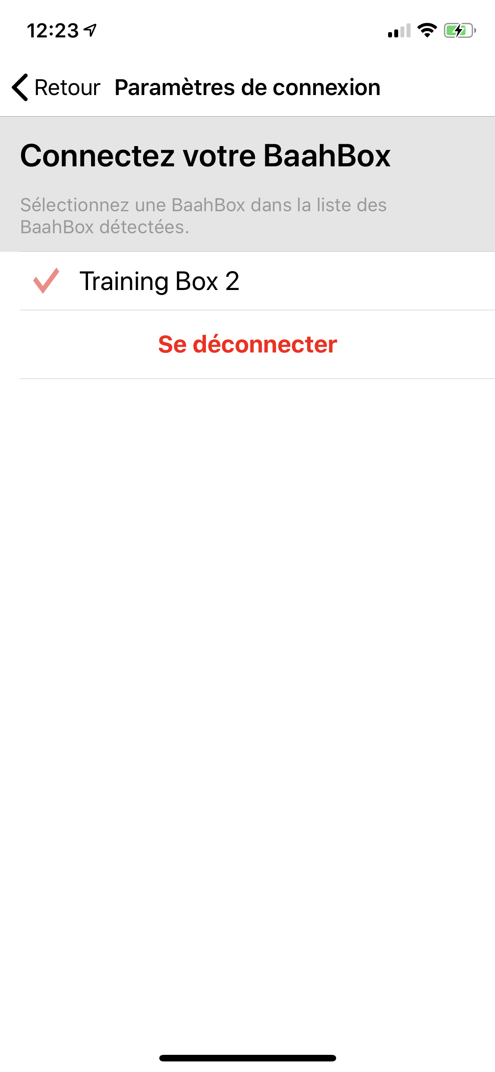
[picture p110: documentation/img/BaahBoxManual/Screen Shot 2019-01-24 at 12.23.49.png]

</div>

### General setting
This part allows you to configure global settings for the whole application. Once done, tap "Settings" in the top left to return to the previous screen.

<div style="text-align:center" markdown="1">
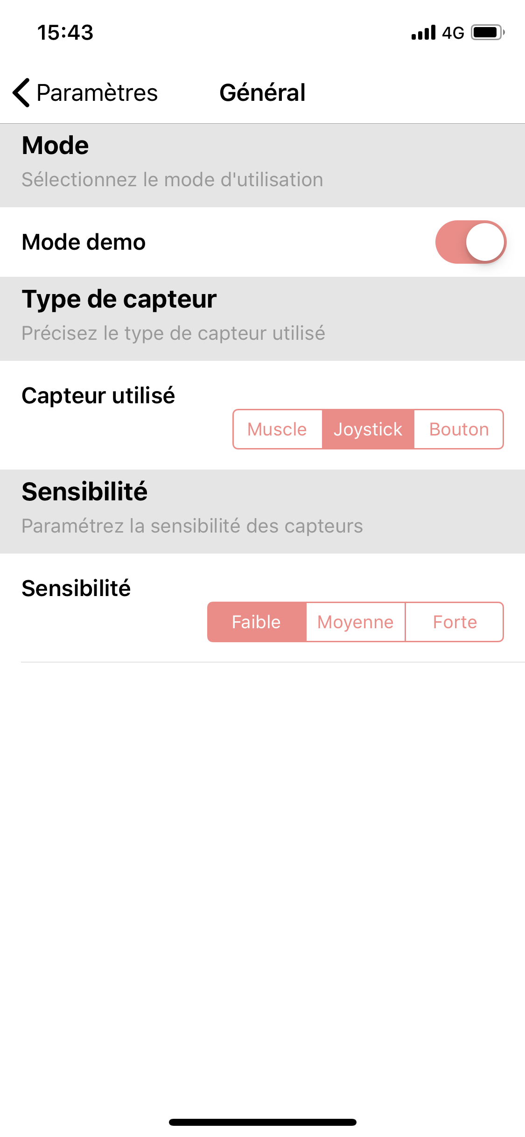
[picture p111: documentation/img/BaahBoxManual/Parameters.png]

</div>

<br/>

### Game settings

This part allows a specific setting for each game.
Once the settings have been selected, they are immediately taken into account by the game.

<p style="page-break-after: always;">&nbsp;</p>

# Appendix

## Using the buttons on the housing

There are 3 buttons on the left of the screen (**A**, **B**, **C**)

and a button above the screen: **Reset**

### The **Reset** button allows you to restart the box
### The **A** button displays the home page (the Baah Box banner)

### The **B** button is used to check the correct functioning of the sensors
(see the corresponding section at the beginning of the document)

### The **C** Button displaying configuration information and the battery level

- 1st press: display the following information:

	- BTLE: name of the Baah Box (defined on the SD card)
	- Channels used: association of sensor pins with sensors 1 or 2 (defined on the SD card)
	- Version: version of the "Baah Box" software

- 2nd press: display information on the battery
	- battery voltage
 	- battery charge level (in %)
 	- fast display graph for the state of charge

# To recharge the battery of the box

## Important

### To recharge the battery, connect the box to the USB charger,
### **but leave the box on** (switch to red tap)
