Orange-OpenSource/BaahBox-Arduino/docs/BaahStick/BaahStick_Build.html

### Sommaire

- 1. Introduction
- 2. Impression 3D et découpe
- 3. Connectique
- 4. Montage final

# Guide d'assemblage du joystick connecté

Ce guide vous explique comment assembler le joystick connecté à partir des composants électroniques, des pièces imprimées en 3D et des pièces en contreplaqué de 5mm qui sont listées dans la liste du matériel nécessaire (BOM).

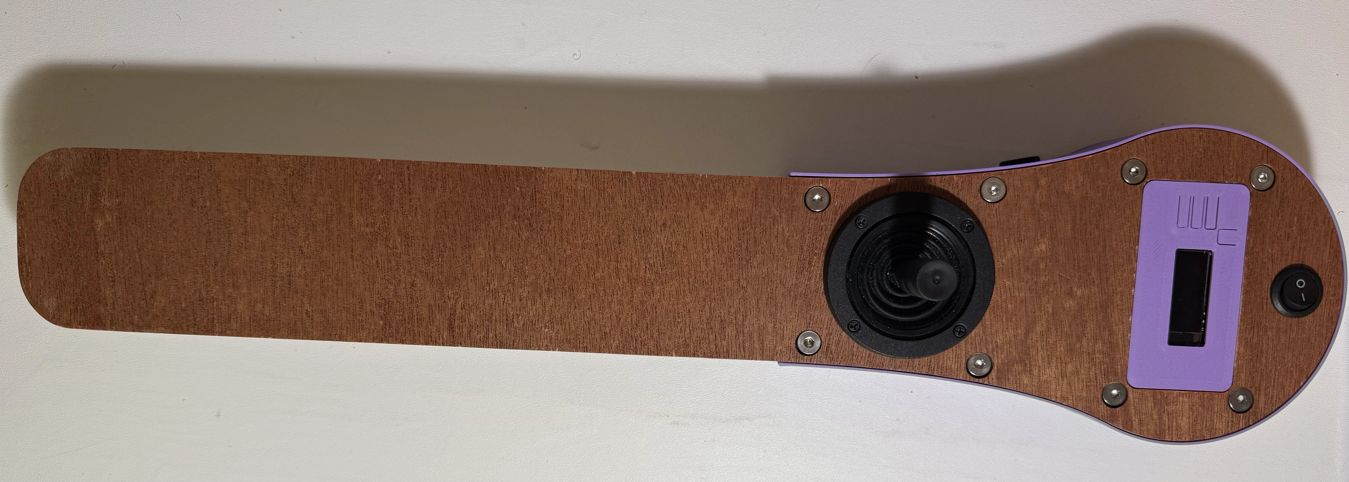
[picture p112: docs/assets/images/doc/BaahStick/build/joyVueDessus.webp]
Vue de dessus du joystick connecté


## Impression du boîtier et découpage des parties en bois

La partie bois va servir de support aux composants électroniques et à la coque en 3D.

Téléchargez les fichiers STL / DXF nécessaires pour obtenir les pièces suivantes:

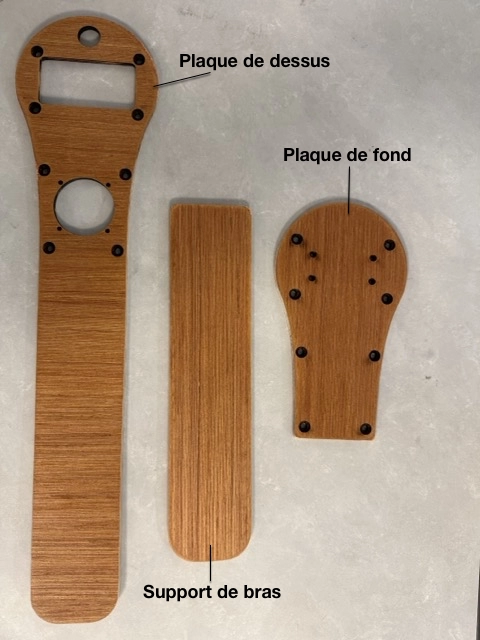
[picture p113: docs/assets/images/doc/BaahStick/build/decoupeJoystick.webp]
Découpes bois pour le joystick connecté
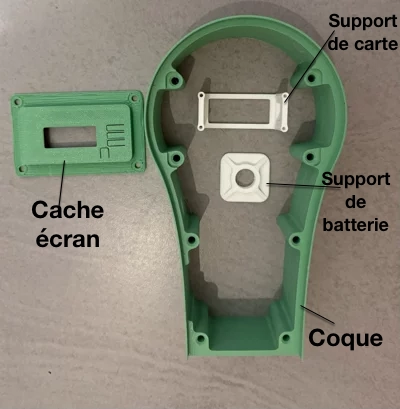
[picture p114: docs/assets/images/doc/BaahStick/build/joystick_3D.webp]
Vue d'ensemble de la BaahBox
 



Assurez-vous d'imprimer et de découper/poncer/vernir toutes les pièces nécessaires avant de commencer l'assemblage.

## Préparation des éléments électroniques et des connections

### Étape 1: Soudure des broches de la Feather

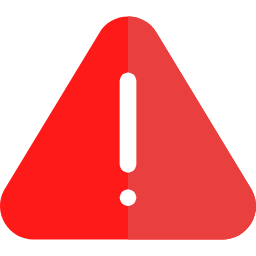
[picture p115: docs/assets/images/icons/warning.png]


Attention : Faites attention au sens de la carte. Il y a un côté avec moins de broches. Assurez-vous de bien les repérer.

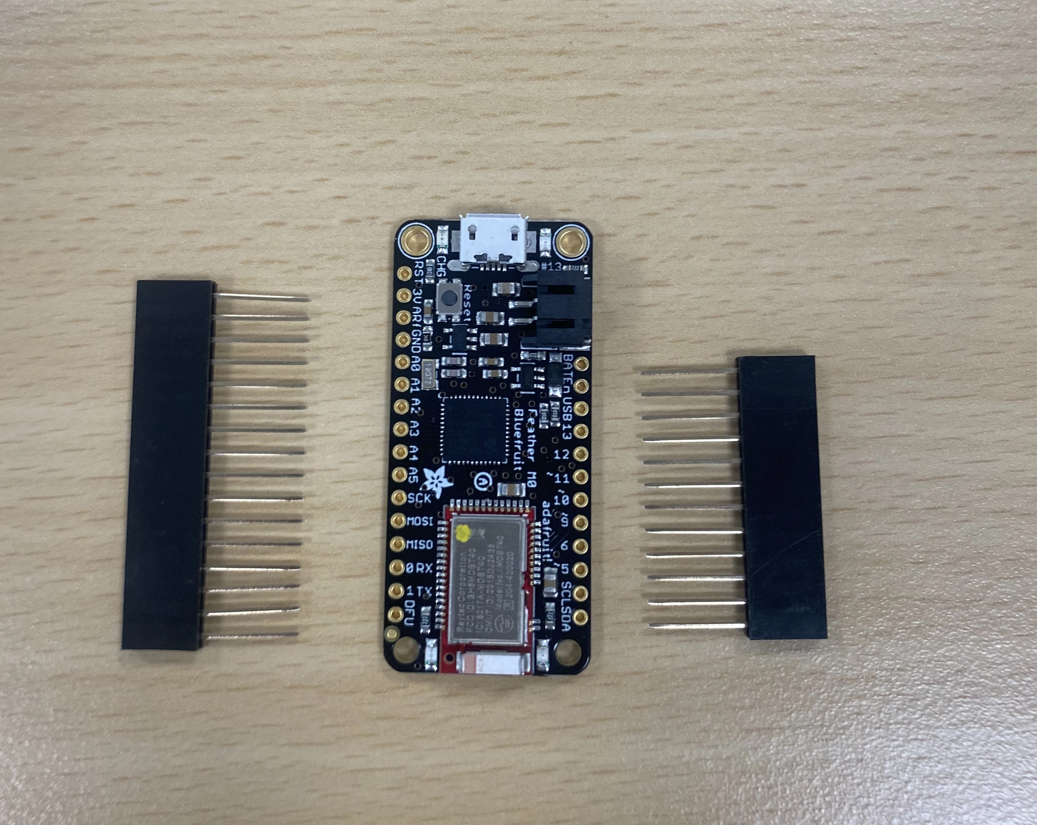
[picture p116: docs/assets/images/doc/BaahBox/build/M0_headers.webp]
Feather M0 avec broches


Feather M0 avec ses broches, avant soudure

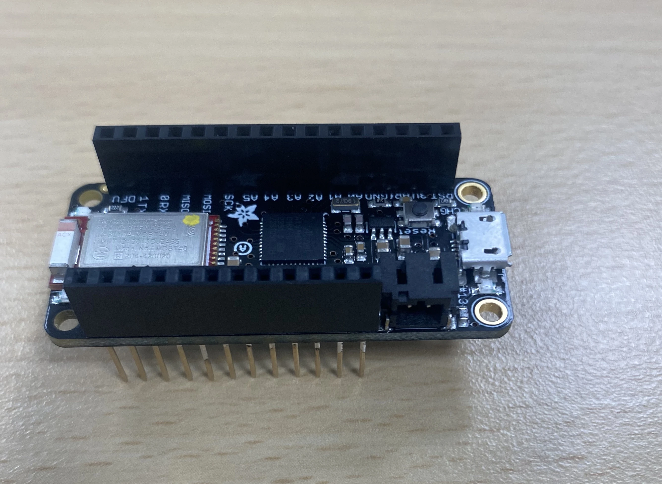
[picture p117: docs/assets/images/doc/BaahBox/build/M0_soldered.webp]
Écran TFT avec broches


Feather M0 avec les broches soudées



Astuce : Pour souder les broches bien parallèles, retournez la carte avec les broches en place, et utilisez de la patafix pour éviter qu'elles ne bougent pendant la soudure (la photo le montre sur un autre type de carte).

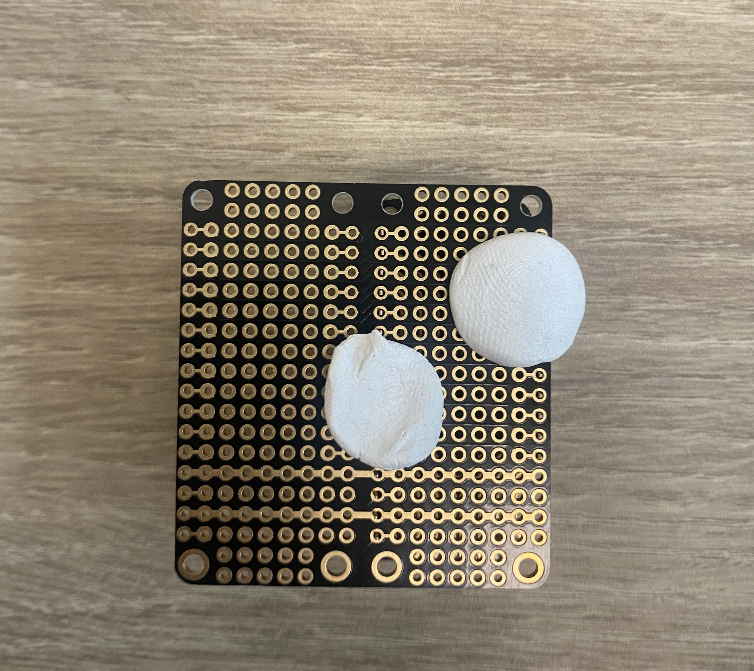
[picture p118: docs/assets/images/doc/BaahBox/build/patafix_trick.webp]
Astuce patafix


### Étape 2 : Préparation du joystick

Ce joystick, de type analogique, comprend deux potentiomètres situés à angle droit, avec chacun 3 bornes.
La borne de gauche est celle de l'alimentation (3.3V ou +),
celle de droite correspond à la masse (ou -), et celle du milieu, au signal.

Souder les broches + et - à des câbles rouge/noir. Puis relier (soudure) les bornes + ensemble. faire de même pour les -.
Enfin, souder les broches de signal (milieu) à des câbles de couleurs différentes.

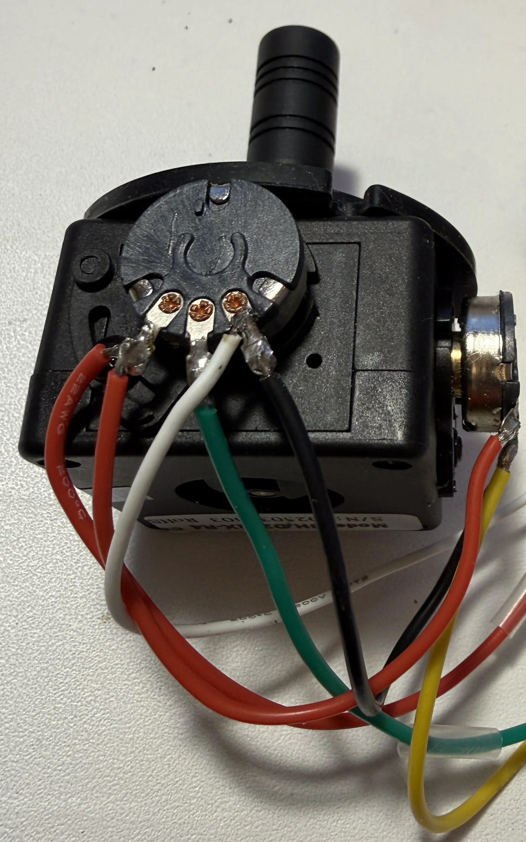
[picture p119: docs/assets/images/doc/BaahStick/build/Joystick_soude.webp]
Joystick soudé


### Étape 3: Soudure des câbles du joystick à la Feather

Positionner le joystick de façon à voir un potentiomètre de face et l'autre sur le coté droit.
Souder les broches + et - du joystick aux broches 3.3V et GND de la Feather.

Le signal de celui de face (vert) doit etre connecté (soudé) à la broche A0 de la carte Feather.
L'autre (jaune) devra être connecté à la broche A1 de la carte.



Notez sur les images ci-dessous, l'utilisation de câbles Dupont (femelles sans la protection plastique) pour faciliter la soudure des câbles sur les broches de la Feather. Les soudures sont ensuite isolées à l'aide de manchons thermo-rétractables.
Autre point, il peut être utile (pas visible sur cet exemple) de raccourcir de 2 mm les broches de la Feather.

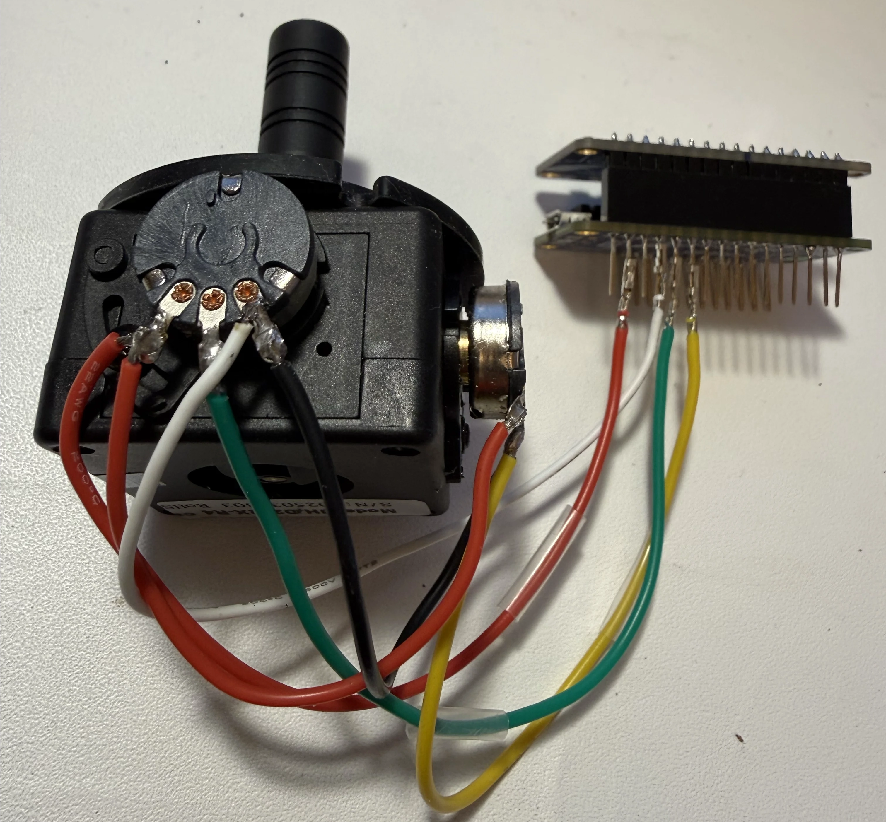
[picture p120: docs/assets/images/doc/BaahStick/build/IMG_0618bis.webp]
Feather et joystick reliés


Feather M0 et joystick soudés

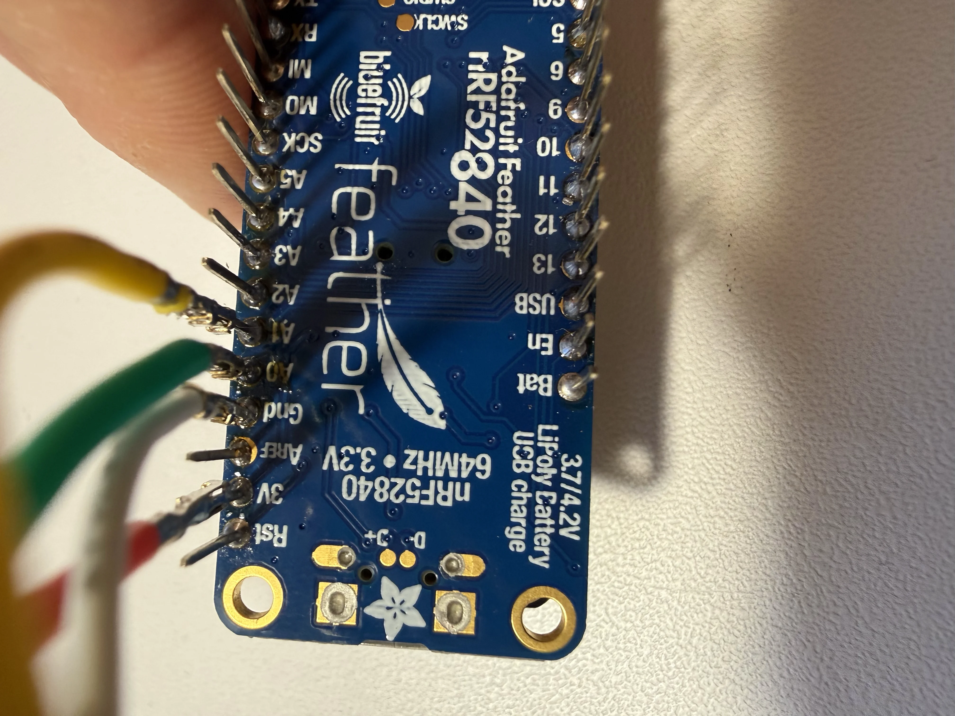
[picture p121: docs/assets/images/doc/BaahStick/build/IMG_0619.webp]
Vue de dessous de la Feather avec les câbles du joysticks soudés


Feather M0 vue de dessous

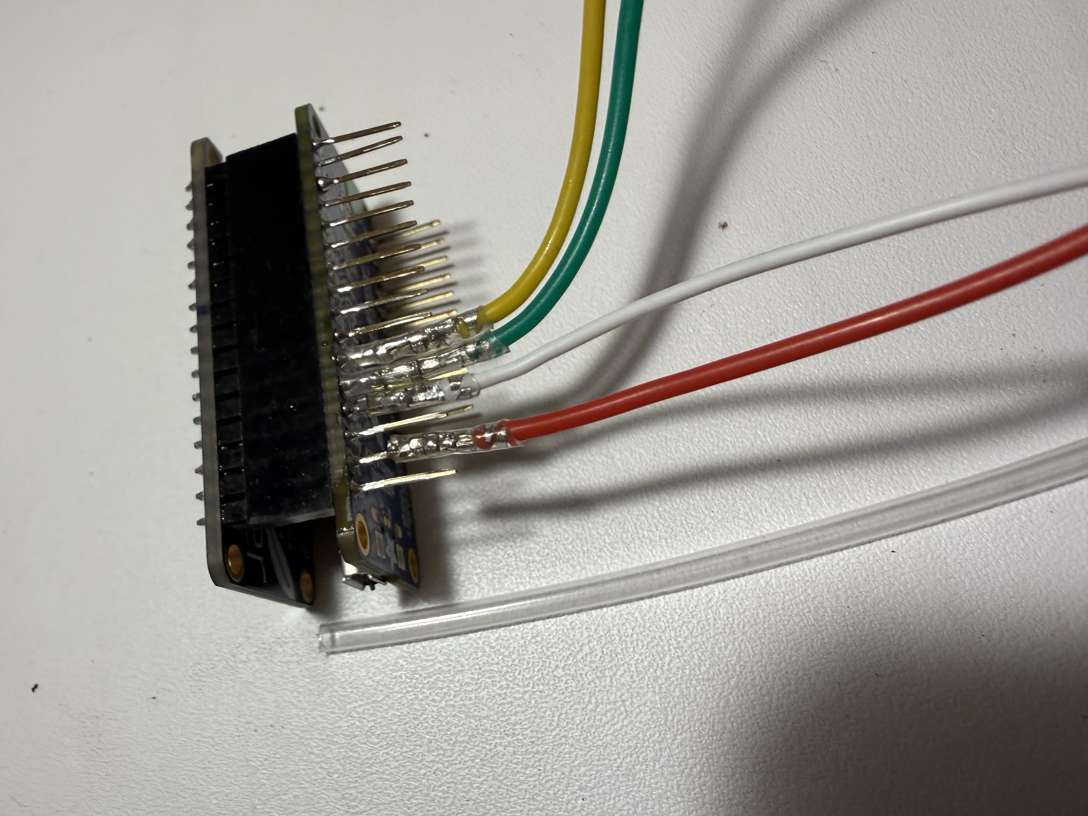
[picture p122: docs/assets/images/doc/BaahStick/build/IMG_0623.webp]
Broches de la Feather soudées avec manchons thermo-rétractables


Broches de la Feather soudées avec manchons thermo-retractables

### Étape 4: Préparation des connecteurs, prises et batterie

##### 1- Préparation de la prise USB-C

Soudez le câble rouge de la prise USB-C vissable au câble rouge de la prise usb-micro.
Faire de même avec les câbles noirs.

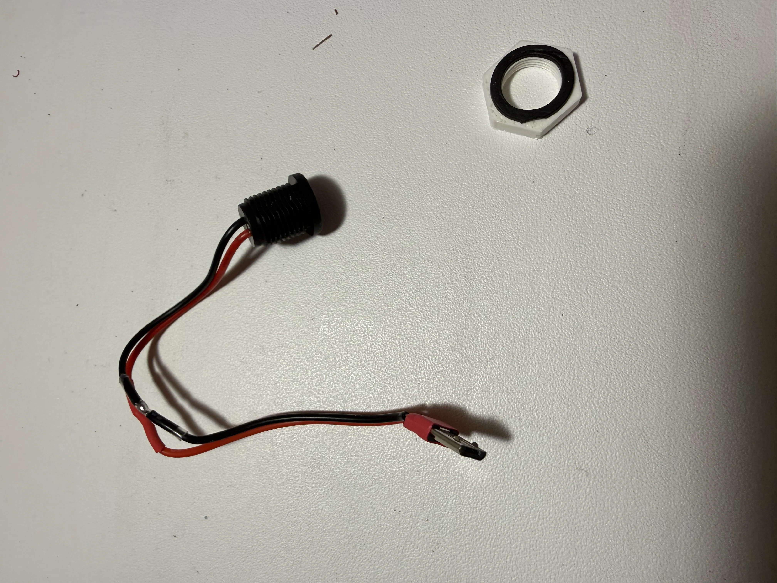
[picture p123: docs/assets/images/doc/BaahStick/build/IMG_0627.webp]
Feather M0 soudée


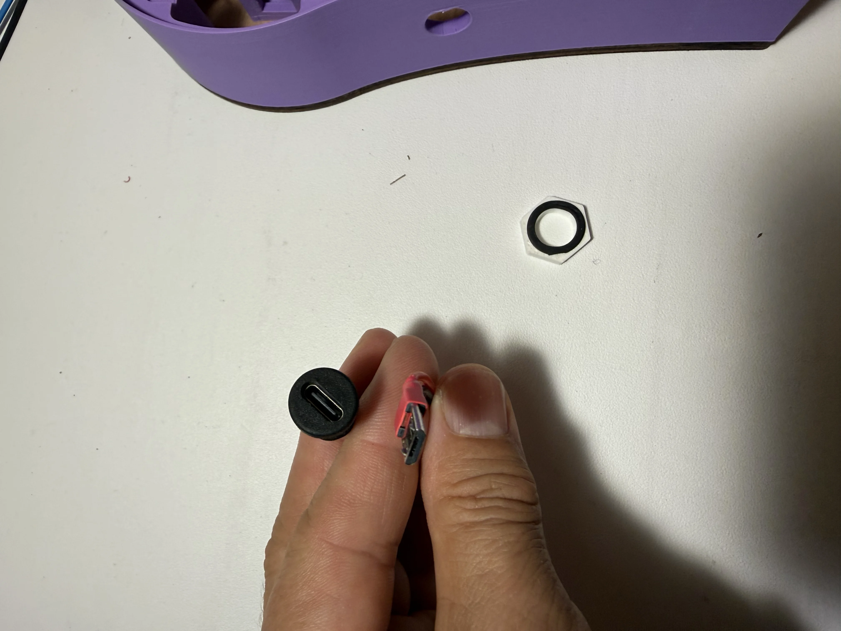
[picture p124: docs/assets/images/doc/BaahStick/build/IMG_0626.webp]
Vue de côté de l'empilage


On obtient un convertisseur USB-C vers USB micro.
(Ceci n'est nécessaire que pour les cartes FEATHER M0 et nrf52. Si vous utilisez une autre carte - y compris FEATHER BLE mais plus récente- , elle aura une prise USB-C native. il faudra donc souder une prise USB-C mâle sur le prise USB-C vissable pour faire une rallonge.)

##### 2- Dérivation du câble (JST-PH) de la batterie, pour y placer un interrupteur.



Les cartes Feather de chez Adafruit sont alimentables soit par une batterie LiPo avec un connecteur JST-PH, soit via usb (micro pour les M0 et nrf52), soit les deux.
Si la carte est connectée à une batterie -et- à via sa prise usb, l'alimentation usb recharge la batterie.
Pour pouvoir éteindre la carte et ne pas consommer de batterie, il faut placer un interrupteur en coupure.

- Souder un des câbles de la prise jst-ph mâle (sur la photo, le câble rouge) sur une des broches de l'interrupteur.
- Puis souder sur l'autre broche de l'interrupteur, le câble de même couleur, de la prise jst-ph femelle.
- Souder ensuite les câbles noirs des deux prises ensemble.

Ensuite, il suffit de connecter la batterie sur ce montage pour avoir une alimentation de Feather, avec un interrupteur. Ce montage permet aussi de facilement monter le tout dans le boitier, et de changer la batterie si besoin.

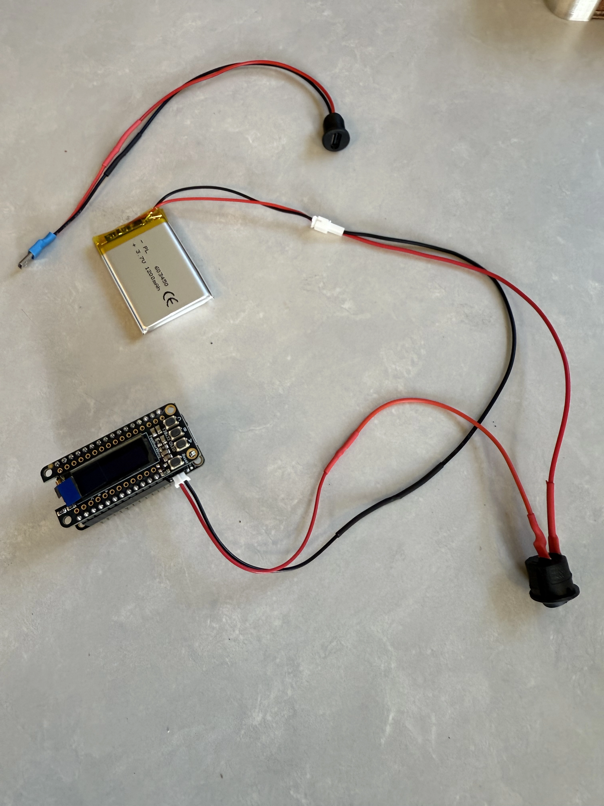
[picture p125: docs/assets/images/doc/BaahStick/build/bbox-batt-usb.webp]
Dérivation sur Batterie-interrupteur


## Montage final

1. Vissez le support de feather (1) sur la plaque de bois du fond, avec 4 vis M2.5.
2. Collez (super glu) le support de batterie (2) sur la plaque du fond (en blanc sur la photo).
3. Vissez la plaque du fond sur la coque avec les vis M4 à tête plates.
4. Installez la prise USB-C vissable dans la coque.

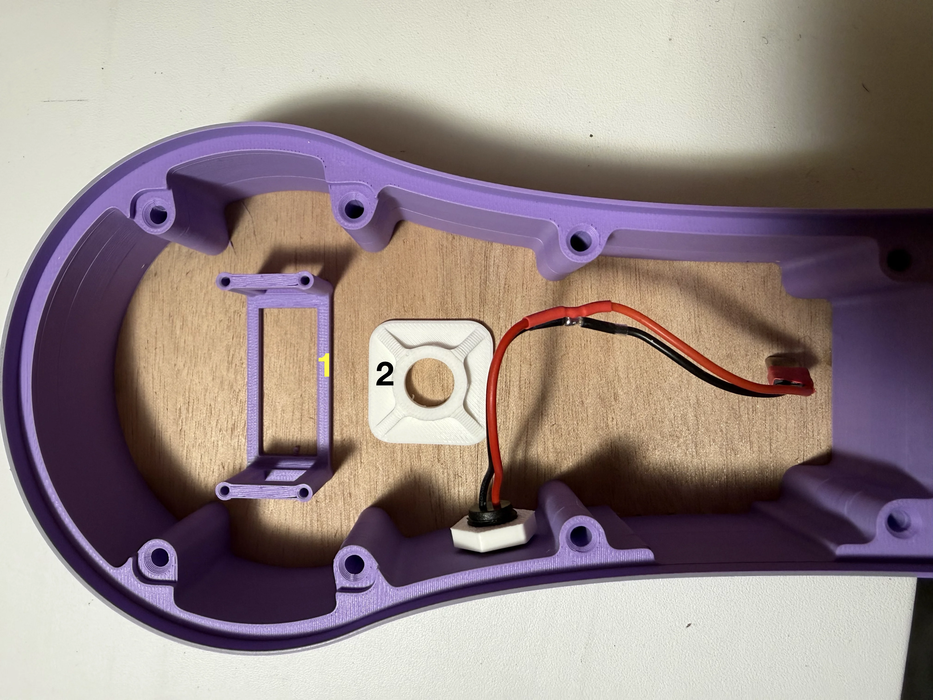
[picture p126: docs/assets/images/doc/BaahStick/build/IMG_0628.webp]
Vue du boîtier en cours de montage


Insérez deux colliers de serrage dans les fentes du support de batterie.

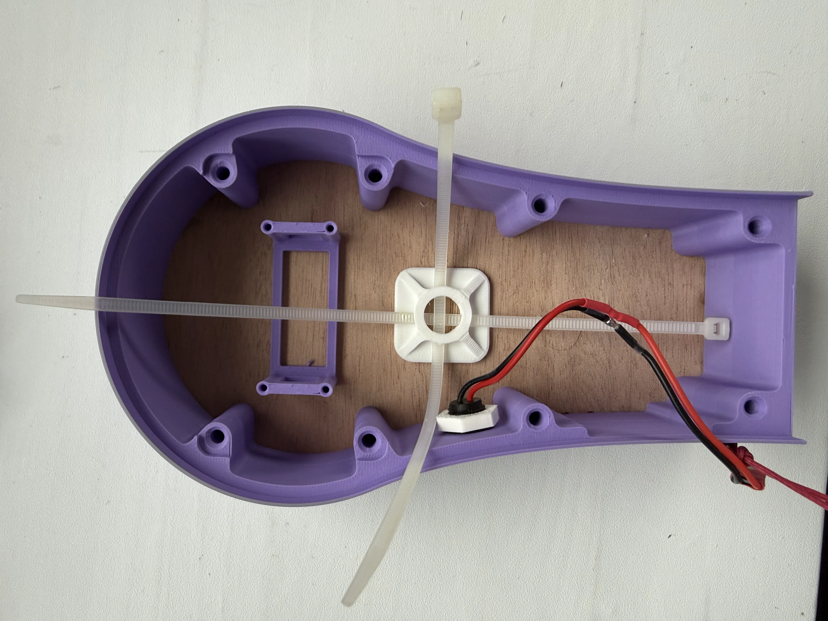
[picture p127: docs/assets/images/doc/BaahStick/build/IMG_0651.webp]
Boîtier fermé


Déconnectez la batterie de l'interrupteur (via la prise jst-ph).
Installez la batterie et serrez les colliers (en faisant attention à ne pas serrer sur les connections).

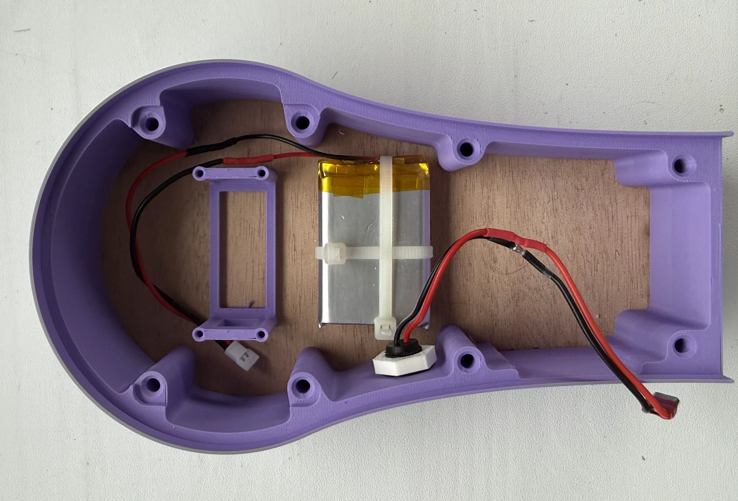
[picture p128: docs/assets/images/doc/BaahStick/build/IMG_0652.webp]
Batterie installée


Mettez en place le joystick relié à la carte
en positionnant un potentiomètre à droite et l'autre en bas (comme sur la photo).
Branchez la prise usb-micro (venant de la prise usb-c vissable) sur la carte (en rouge et en bas de la carte sur la photo).

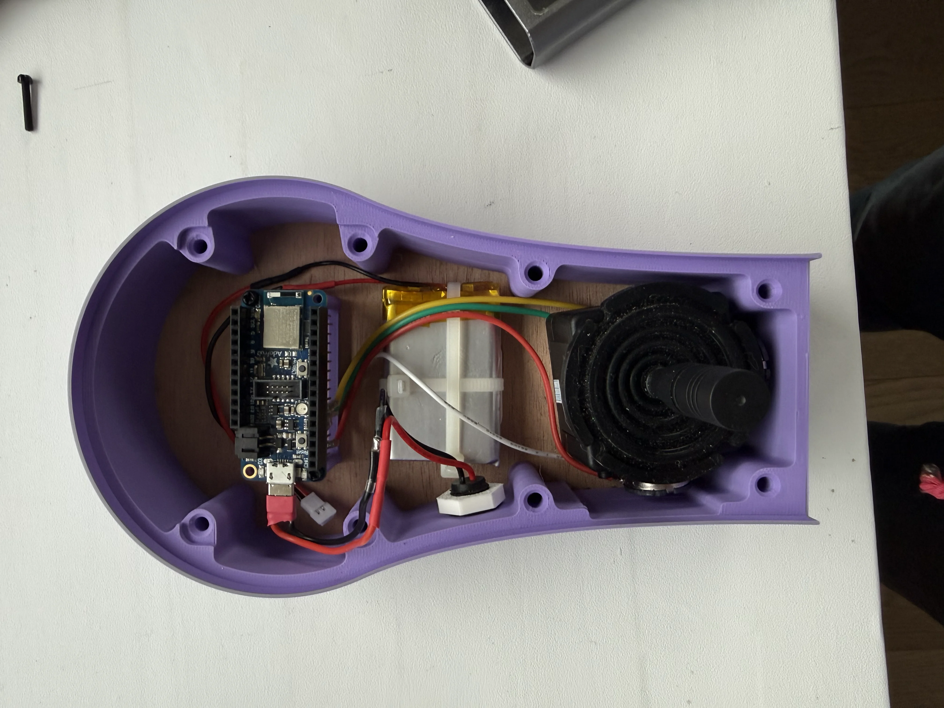
[picture p129: docs/assets/images/doc/BaahStick/build/IMG_0653.webp]
Positionnement du joystick et de la carte dans le boîtier


Vissez la carte avec des vis 2.5 sur son support 3D (2 vis de 6-10 mm de long suffisent).
Attention à ne pas visser trop fort dans le support 3D.
Il faut juste que cela tienne sans bouger.

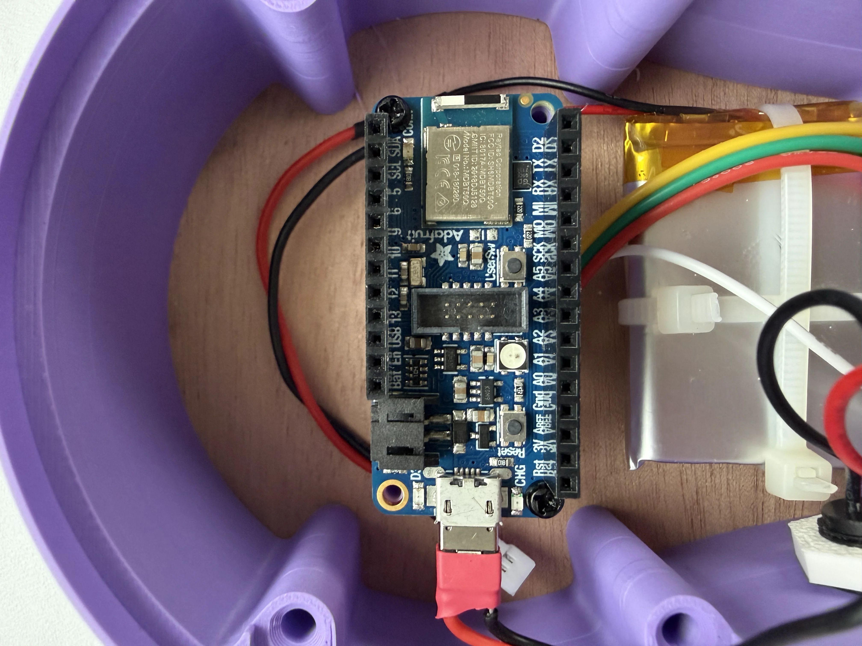
[picture p130: docs/assets/images/doc/BaahStick/build/IMG_0654.webp]
Carte vissée sur son support


Insérez l'interrupteur sur la plaque du haut du joystick.

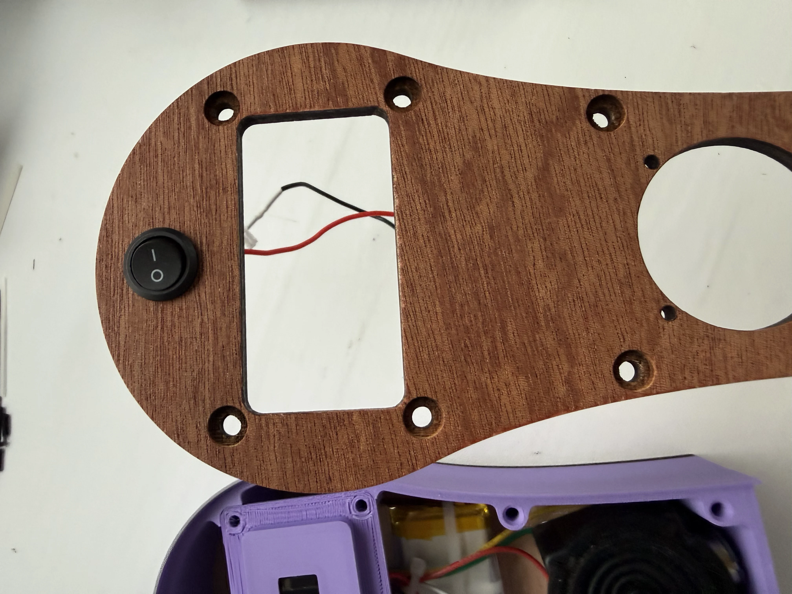
[picture p131: docs/assets/images/doc/BaahStick/build/IMG_0656.webp]
Placement de l'interrupteur sur la plaque du dessus


et connectez-le à la batterie via les prise jst-ph.

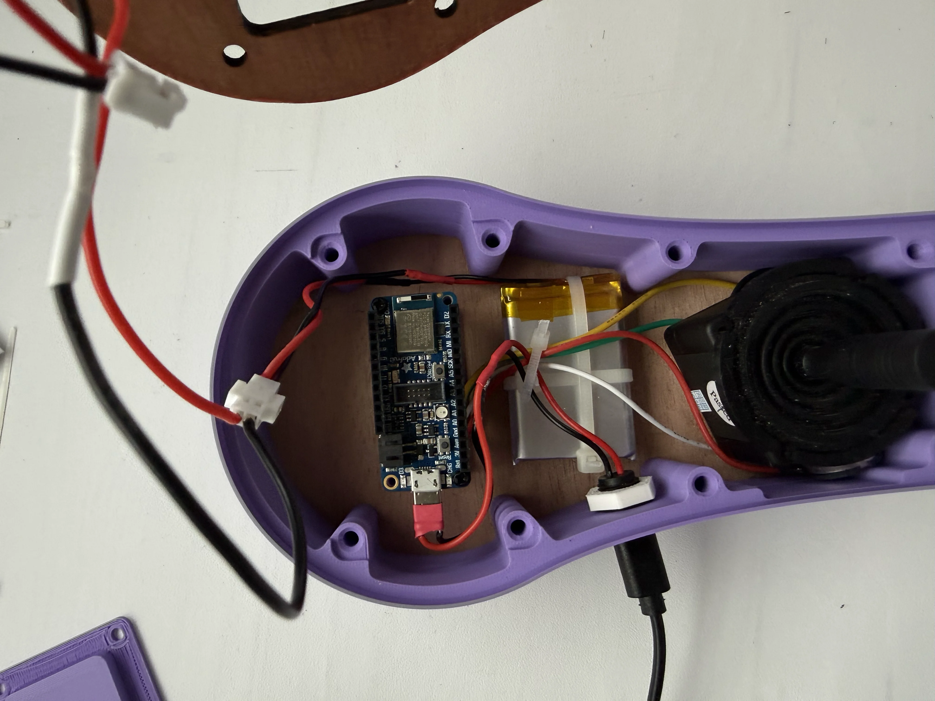
[picture p132: docs/assets/images/doc/BaahStick/build/IMG_0661.webp]
Connection de la batterie à l'interrupteur


Connectez la prise jst-ph restante sur la carte (sur son coté gauche sur la photo).

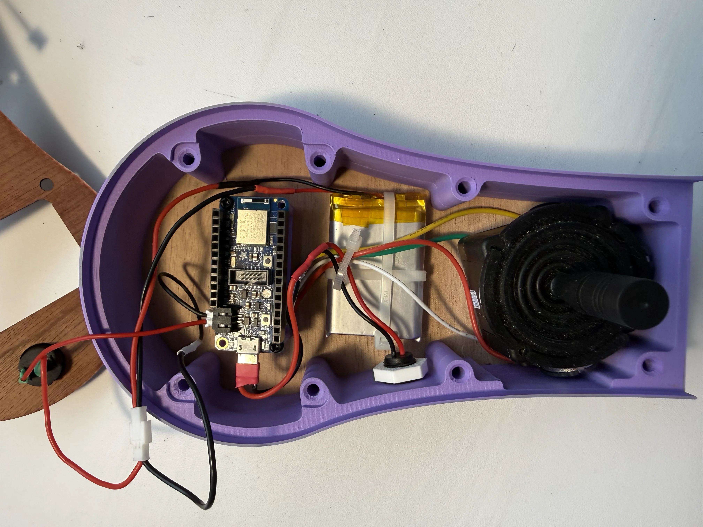
[picture p133: docs/assets/images/doc/BaahStick/build/IMG_0663.webp]
prise jst sur la carte


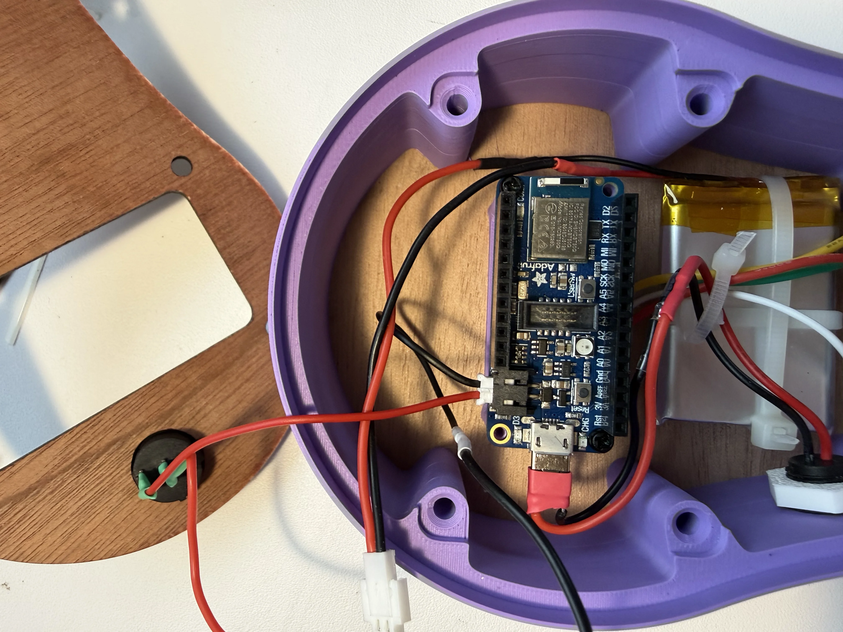
[picture p134: docs/assets/images/doc/BaahStick/build/IMG_0664.webp]


Enfichez ensuite l'écran sur la carte

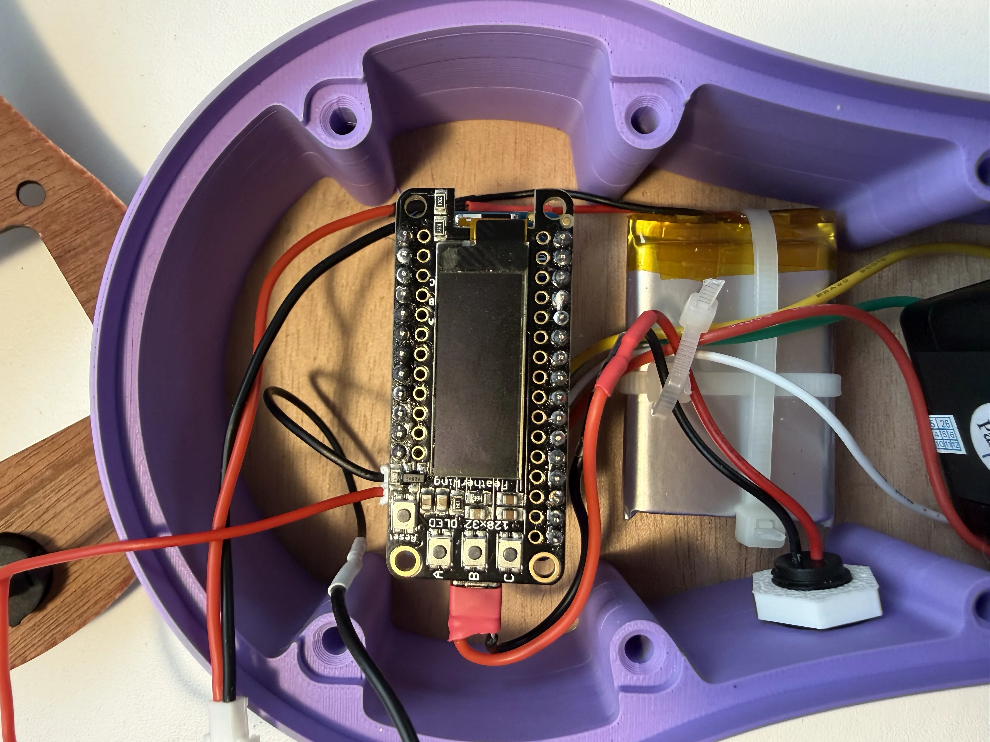
[picture p135: docs/assets/images/doc/BaahStick/build/IMG_0665.webp]
Montage de l'écran sur la carte


Placez le cache écran sur l'écran.

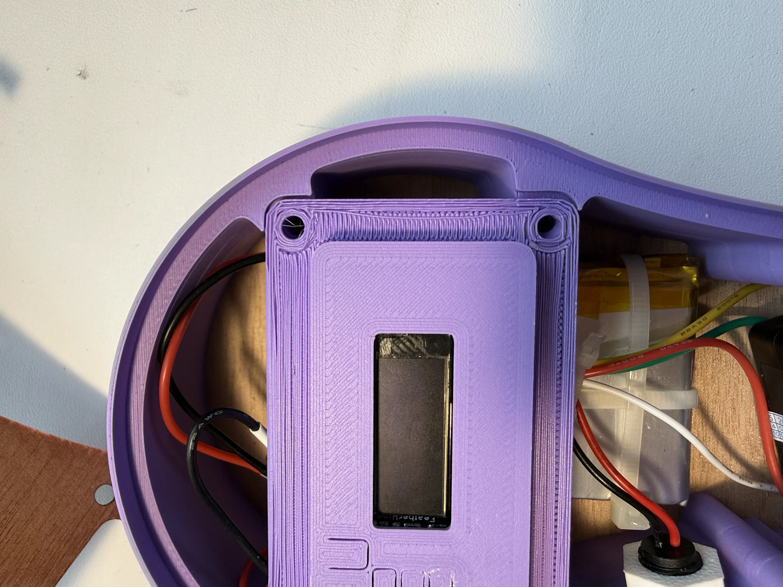
[picture p136: docs/assets/images/doc/BaahStick/build/IMG_0666.webp]
Placez le cache écran sur l'écran


Avant de refermer la boîte, il est temps de vérifier que les branchements sont corrects !
Allumez le joystick et vérifiez que l'écran s'allume.

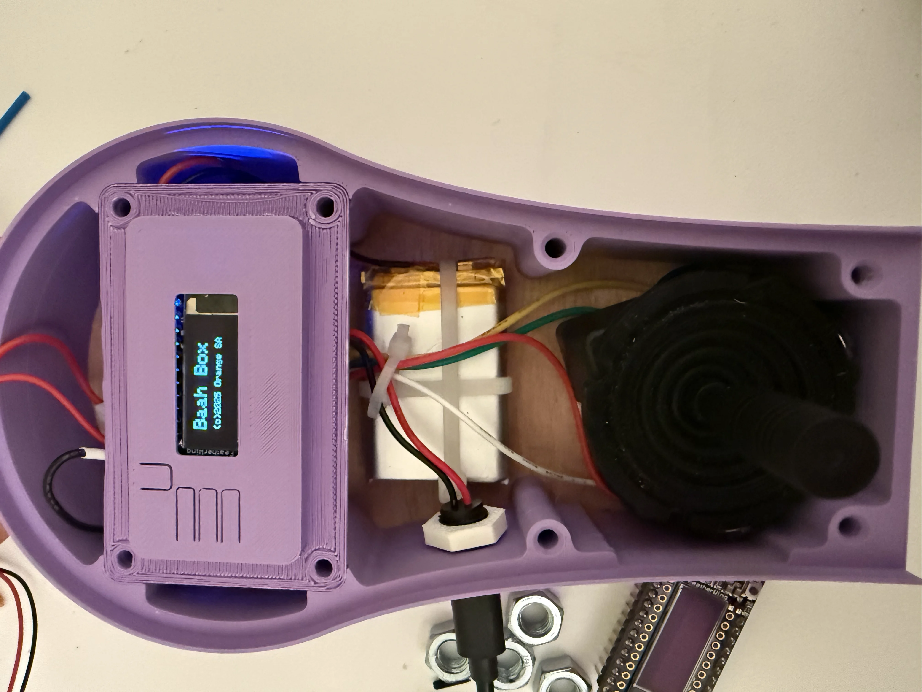
[picture p137: docs/assets/images/doc/BaahStick/build/IMG_0668.webp]
Vérification des connections (joystick allumé)


Tout fonctionne ?

Alors positionnez la plaque de dessus sur le boitier,
faites passer la jupe du joystick au travers du trou, pour la placer au dessus de la plaque,
vissez par dessus la protection de jupe fournie avec....

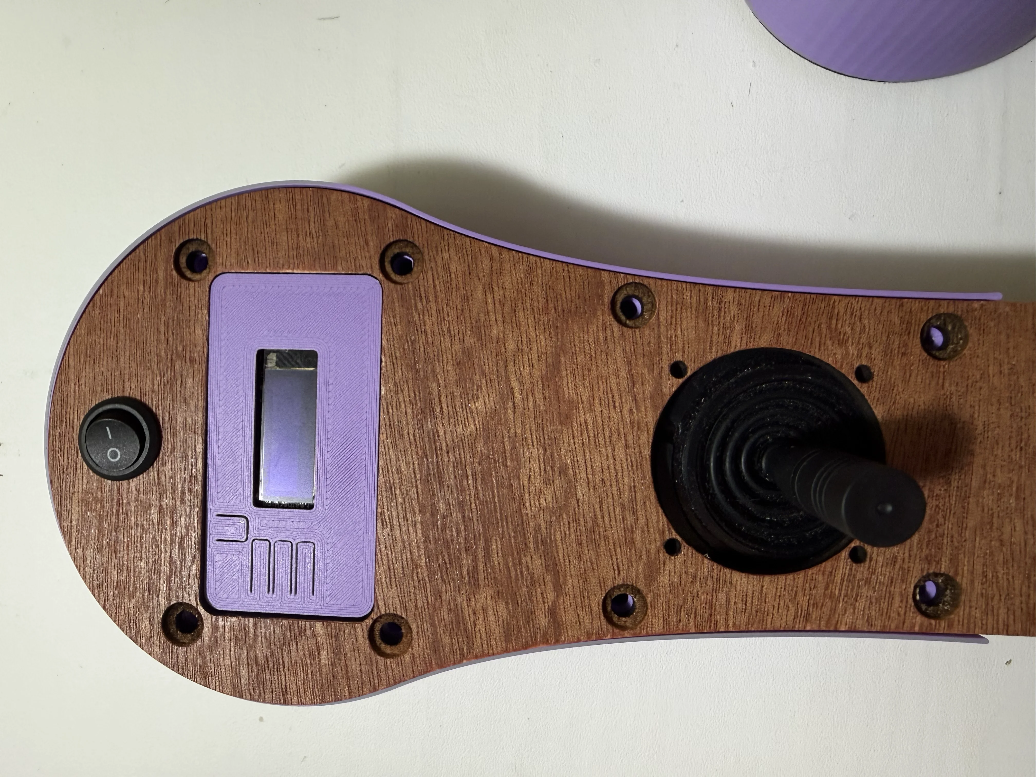
[picture p138: docs/assets/images/doc/BaahStick/build/IMG_0670.webp]


Et voilà !
vous avez monté votre joystick connecté!

Vue de dessus du joystick

Il ne vous reste plus qu'à coller le support de bras sous la plaque du haut pour rigidifier le bras du joystick.

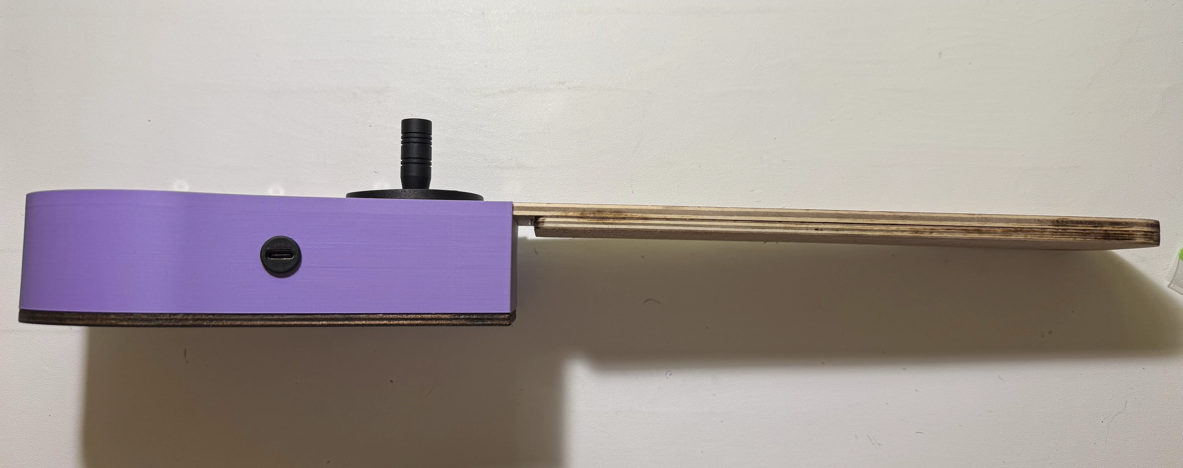
[picture p139: docs/assets/images/doc/BaahStick/build/joyVueCote.webp]
Vue de coté du joystick


Votre Joystick connecté est maintenant assemblé. Vous pouvez passer à l'installation de l'application et à la configuration de l'application.

Pour installer l'application et configurer votre joystick, consultez le manuel d'utilisation de la BaahBox, les écrans sont exactement les mêmes que ceux du joystick.

© 2026 Orange SA. Distribué sous licence GPL v3.
