Orange-OpenSource/BaahBox-Arduino/docs/BaahStick/BaahStick_manual.html

### Sommaire

- 1. Présentation
- 2. Utilisation du joystick
- 3. Configuration de l'application
- 4. Jeux
- 5. Télécharger l'application
- 6. Ressources

# Manuel d'utilisation du joystick connecté

Vue de dessus du joystick connecté Vue de dessus du joystick connecté

## Vous aurez besoin

- Du joystick connecté qui est composé :
  - d'un boîtier électronique avec un écran et des boutons de contrôle
  - et d'un mini joystick.

Le tout est vissé sur une latte de bois, qui permet la fixation sur un accoudoir.

- De l'application mobile BaahBox (voir la section de téléchargement )

## Fonctionnement

Le boîtier électronique utilise le Bluetooth pour communiquer à un smartphone (ou une tablette), les mouvements du mini joystick.
Ce joystick permettent de contrôler les personnages des jeux.

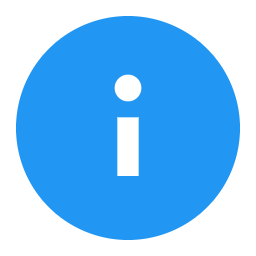
[picture p140: docs/assets/images/icons/info.png]


Le boitier est alimenté par une batterie interne, que l'on peut recharger via la prise USB-C sur le coté de la coque.
Pour que la recharge de la batterie fonctionne, il faut que le joystick soit allumé.

## Utilisation

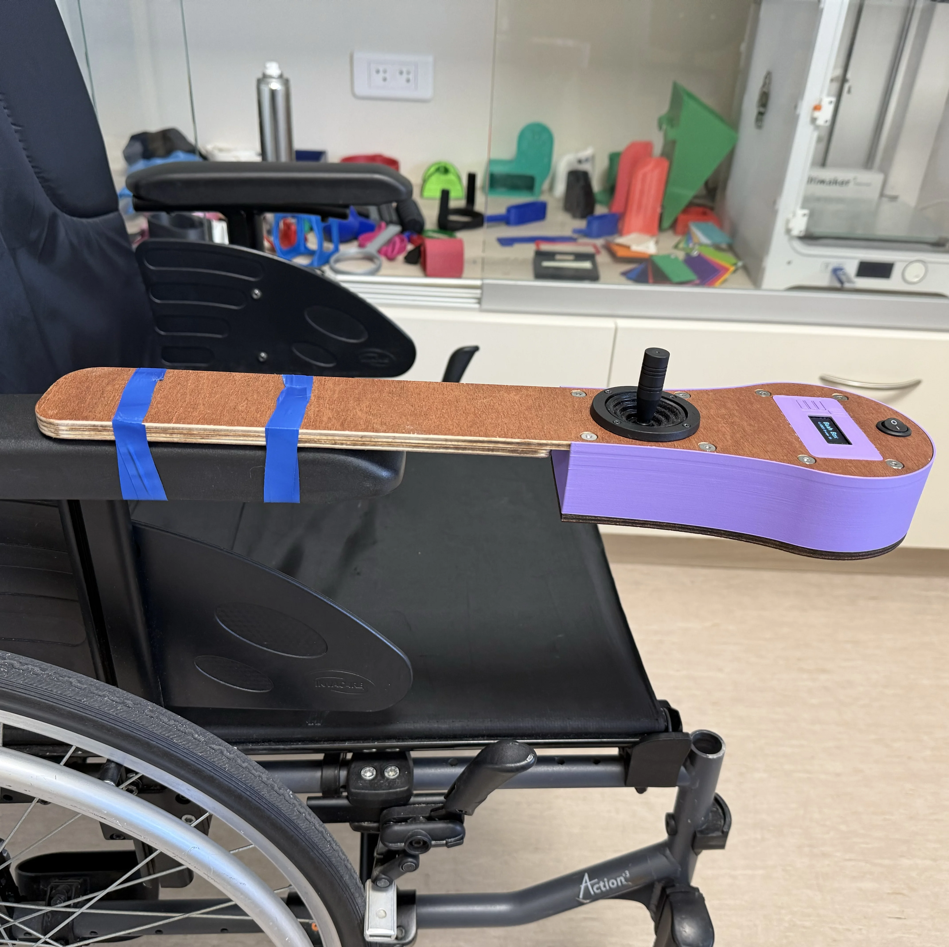
[picture p141: docs/assets/images/doc/BaahStick/overview/joyBrasVueCote.webp]
1. Fixez le joystick sur l'accoudoir d'un fauteuil (avec par exemple du scotch d'électricien). et... installez vous dans le fauteuil ! 
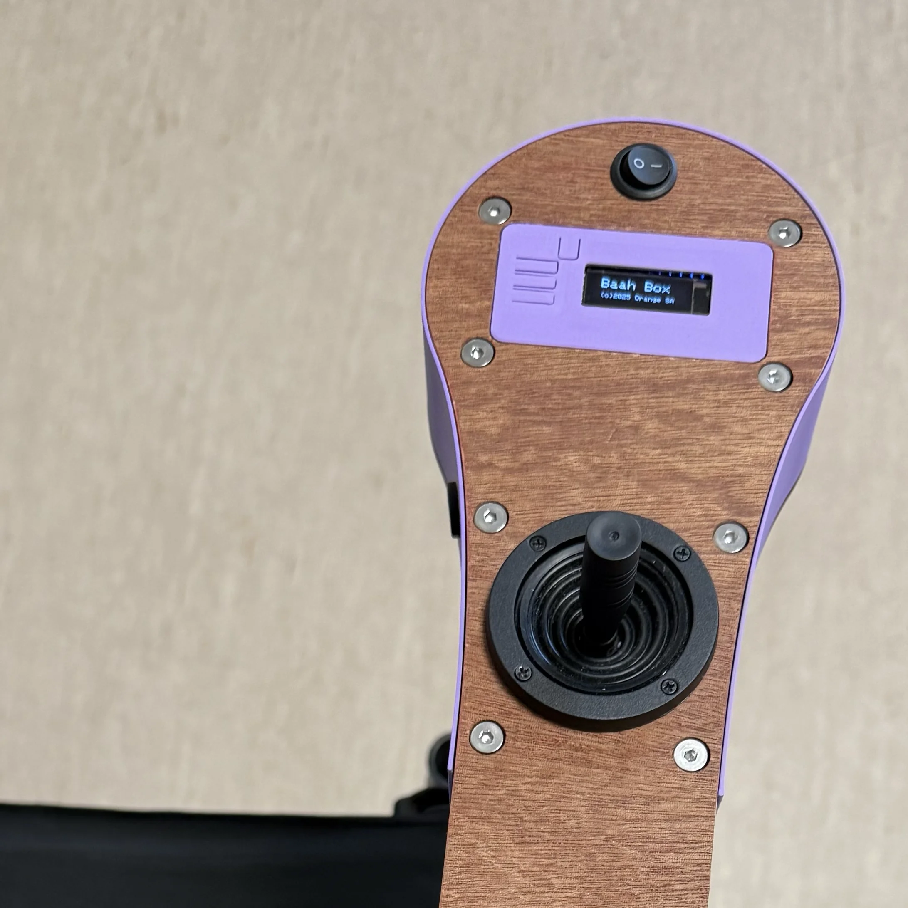
[picture p142: docs/assets/images/doc/BaahStick/overview/joyBrasVueDessusCarre.webp]
2. Allumez le joystick avec l'interrupteur situé au dessus de l'écran 
3. Si la batterie à plat, branchez le à un cable USB-C.



La mise en route peut prendre 1-2 secondes. L'écran peut afficher quelques points blancs avant de présenter la page d'accueil.

### Navigation dans les menus

L'écran du joystick est équipé de plusieurs boutons pour naviguer dans les menus :

- Bouton A : Sélection/validation
- Bouton B : Affichage des courbes des capteurs
- Bouton C : Retour/annulation et affichage des informations du boîtier
- Bouton Reset : Redémarre la BaahBox

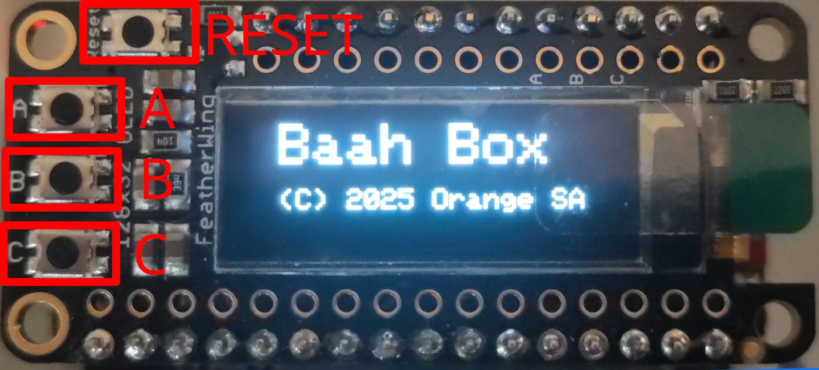
[picture p143: docs/assets/images/doc/BaahBox/baah-box-start/baah-box-buttons.webp]
Boutons de la BaahBox


### Vérification du bon fonctionnement du joystick

1. Appuyez sur le bouton -B- pour afficher les courbes des données envoyées par le joystick: La courbe de gauche montrer les mouvements avant-arrière du joystick, la courbe de droite montre les mouvements droite-gauche.
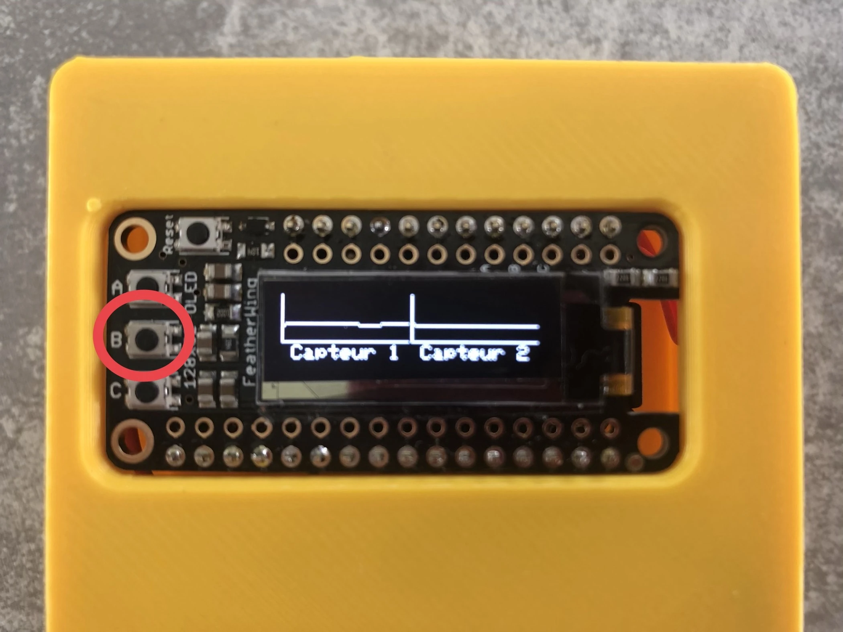
[picture p144: docs/assets/images/doc/BaahBox/manual/2Capteurs.webp]
Affichage des 2 capteurs
    

## Configuration

### Connexion à l'application mobile

1. Téléchargez l'application mobile BaahBox sur votre appareil (voir section Télécharger l'application)
2. Activez le Bluetooth sur votre téléphone (ou tablette) et lancez l'application
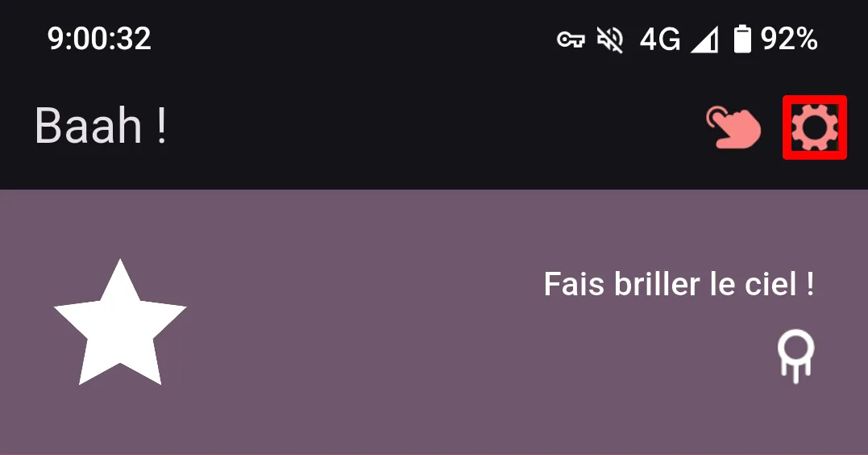
[picture p145: docs/assets/images/doc/Application/link-new-baah-box/settings.webp]
Icône des paramètres
3. Appuyez sur l'icône des paramètres en haut à droite de l'écran d'accueil 
4. Allez dans Connexion
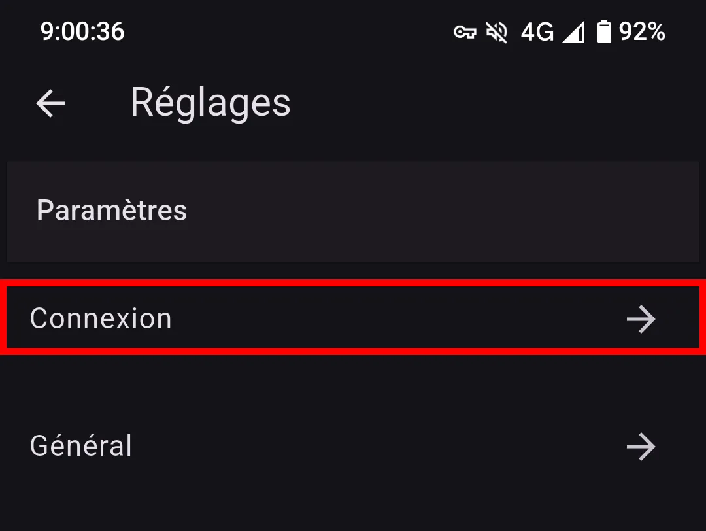
[picture p146: docs/assets/images/doc/Application/link-new-baah-box/connection.webp]
Vérification de la connexion
  
5. Appuyez sur "Démarrer" pour démarrer la recherche de votre joystick connecté (appelé Baahxx)
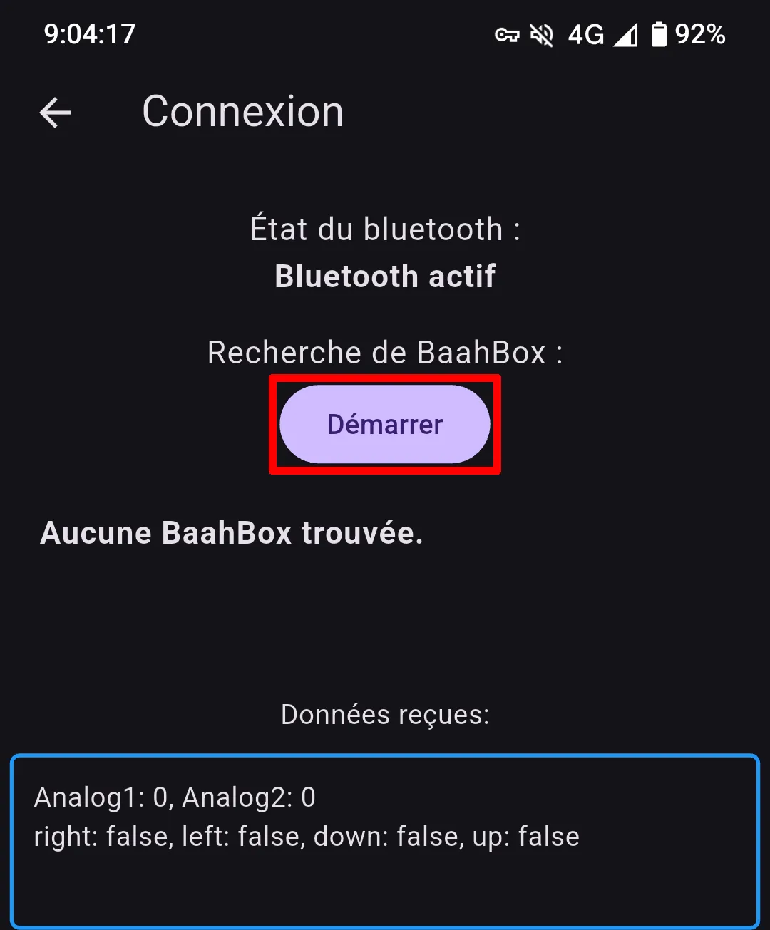
[picture p147: docs/assets/images/doc/Application/link-new-baah-box/start-search.webp]
Bouton Démarrer la recherche
  
6. Puis sélectionnez votre BaahBox/joystick dans la liste.
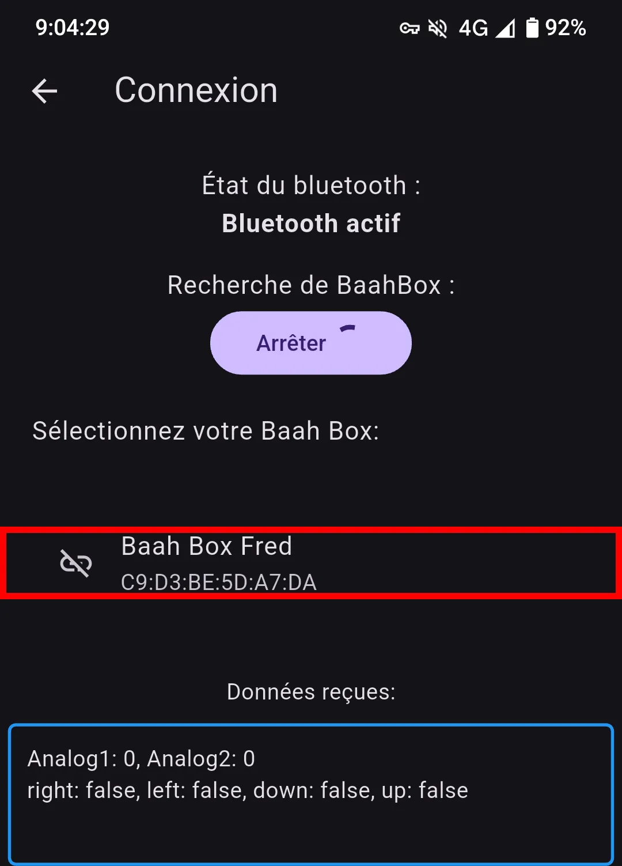
[picture p148: docs/assets/images/doc/Application/link-new-baah-box/select-baah-box.webp]
  
7. Lorsque la connexion sera établie, le mot "connectée" apparaîtra à coté, et l'encart "Données reçues" indiquera des valeurs supérieures à 0 pour les capteurs 1 et 2.
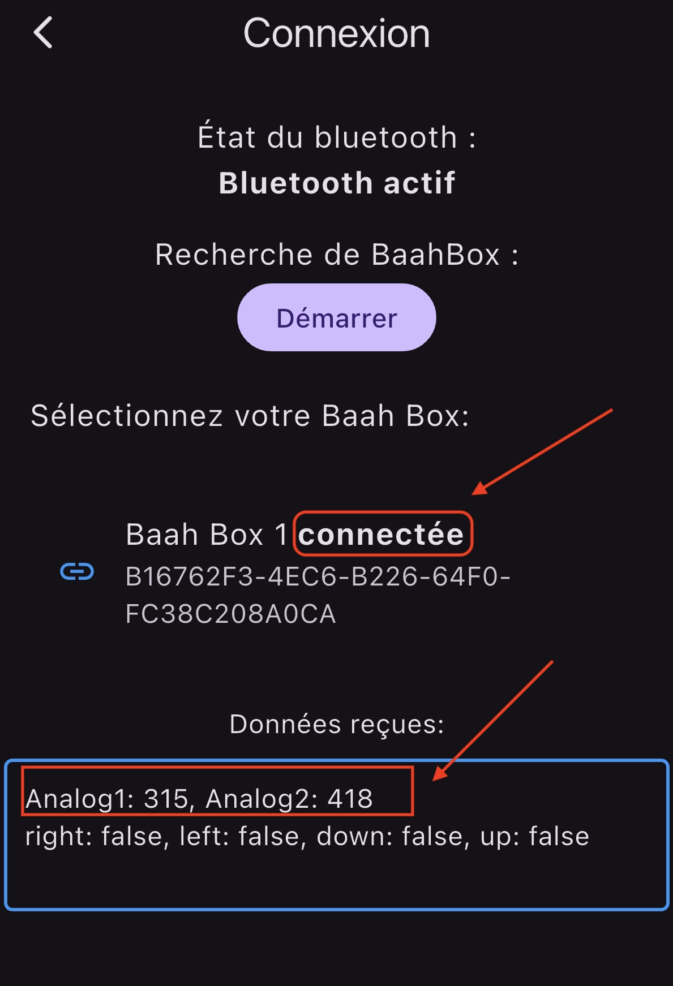
[picture p149: docs/assets/images/doc/Application/link-new-baah-box/baah-box-connected.webp]
  

### Configuration du capteur

Pour que l'application prenne correctement en compte le comportement du mini joystick :

1. Allez dans les paramètres de l'application
2. Sélectionnez "General"
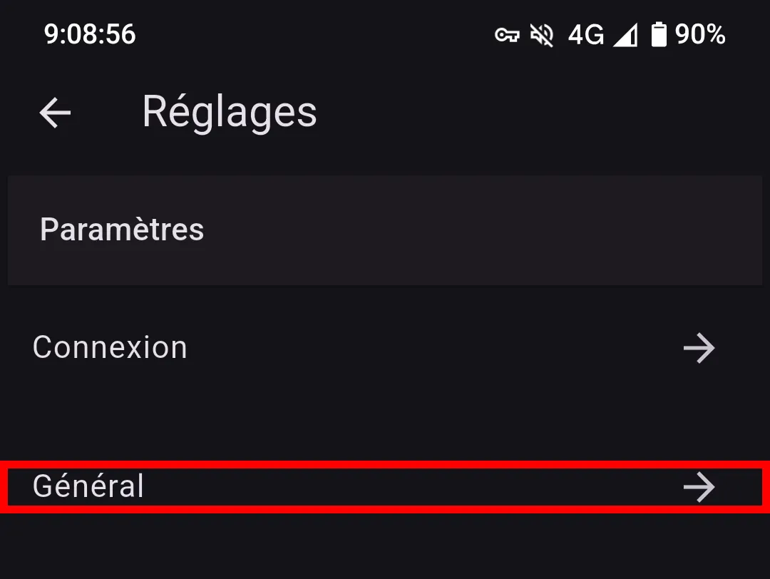
[picture p150: docs/assets/images/doc/sensors/general.webp]
Menu General
  
3. Choisissez le type de capteur dans la liste ("joystick analogique")
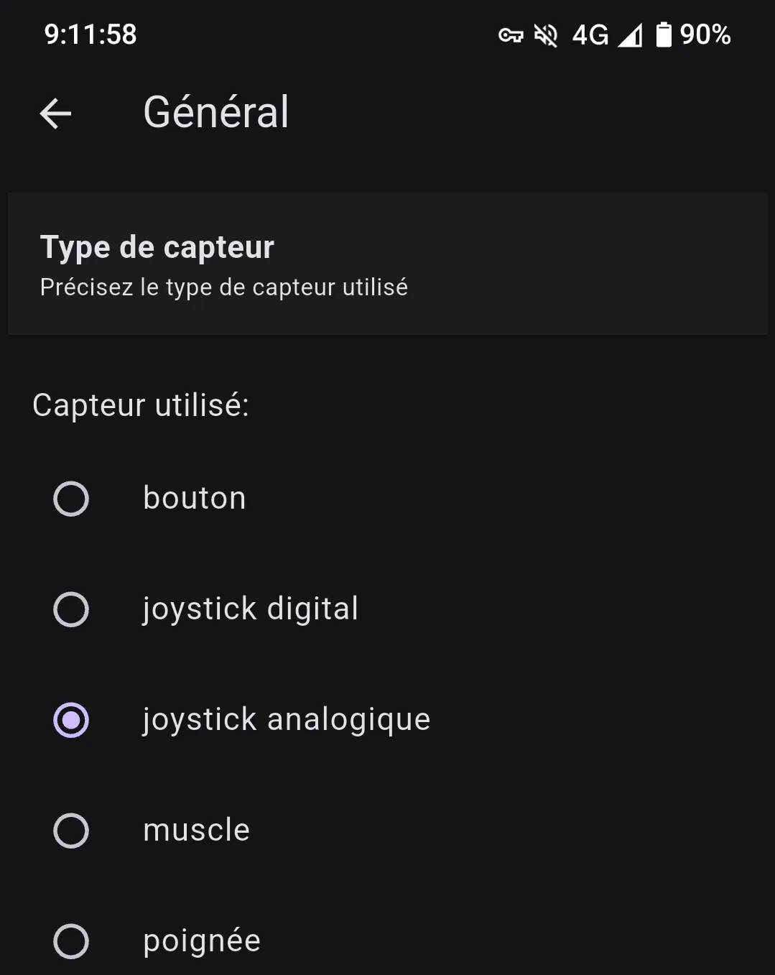
[picture p151: docs/assets/images/doc/sensors/select-capt-type.webp]
Sélection du type de capteur
  

### Choisir un jeu

Pour commencer à jouer :

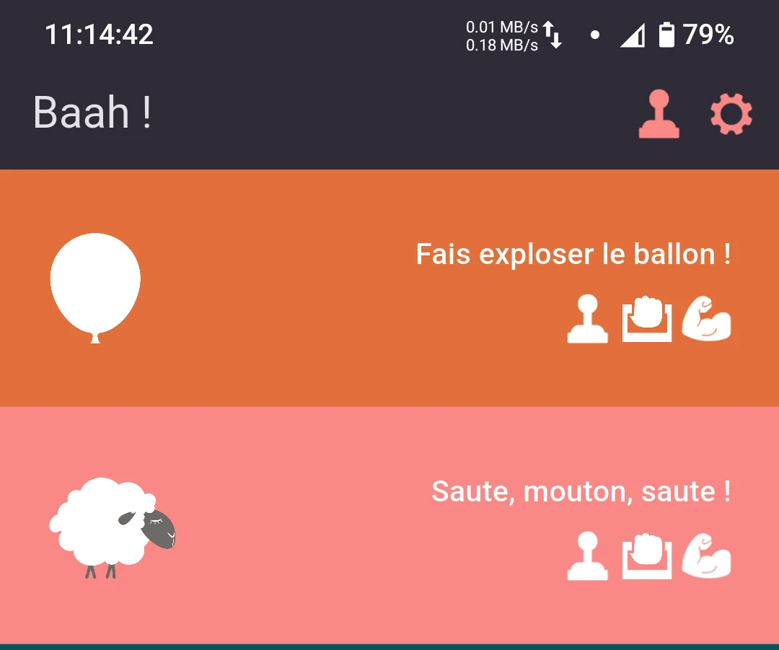
[picture p152: docs/assets/images/doc/Application/games/game-list.webp]
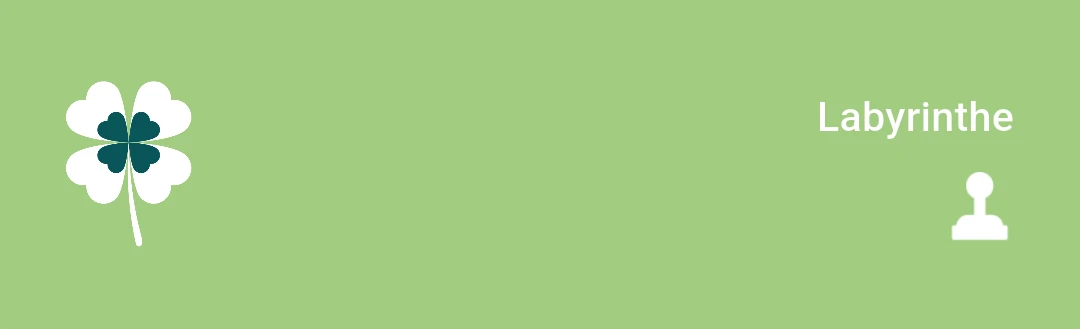
[picture p153: docs/assets/images/doc/Application/games/labyrinthe.webp]
1. Cliquez sur le bandeau correspondant au jeu de votre choix.  Les jeux de labyrinthes en bas du menu sont les plus appropriés pour ce joystick, mais on peut quand même jouer aux autres jeux avec.   
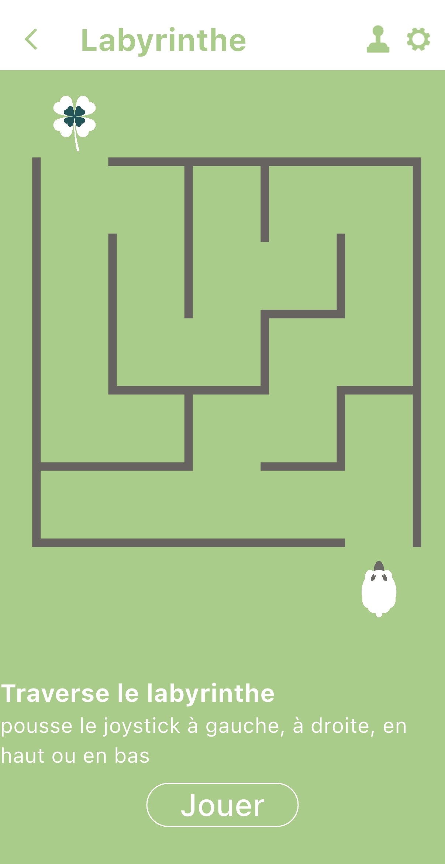
[picture p154: docs/assets/images/doc/Application/games/labyrinthe2D.webp]
Explication du jeu
2. Un court texte vous explique comment jouer 
3. Cliquez sur "Jouer" pour démarrer la partie



Astuce : Pour économiser la batterie de votre smartphone, pensez à couper le bluetooth après utilisation.

## Télécharger l'application

L'application BaahBox est disponible sur les deux plateformes :

### Pour Android

 (https://play.google.com/store/apps/details?id=com.orange.labs.baahbox&pcampaignid=web_share)

Version alpha (https://github.com/Orange-OpenSource/BaahBox-Flutter-android/releases/)

### Pour iOS

 (https://apps.apple.com/fr/app/baahbox/id1474621985)

Version TestFlight

### Scanner pour télécharger

Utilisez l'appareil photo de votre téléphone pour scanner le code correspondant à votre appareil :

Android

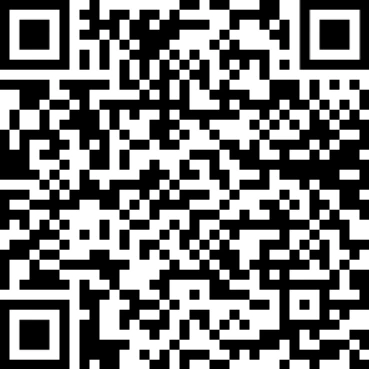
[picture p155: docs/assets/images/qrcode-android.webp]
QR code pour télécharger l'application Android


iOS

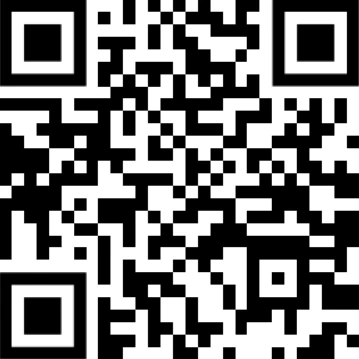
[picture p156: docs/assets/images/qrcode-apple.webp]
QR code pour télécharger l'application iOS


## Ressources techniques

- Les sources Arduino sont dans le répertoire project du repo : BaahBox-Arduino (https://github.com/Orange-OpenSource/BaahBox-Arduino)
- Les sources de l'application iOS : BaahBox-iOS (https://github.com/Orange-OpenSource/BaahBox-iOS)
- Les sources de l'application Android : BaahBox-Flutter-android (https://github.com/Orange-OpenSource/BaahBox-Flutter-android)
- Les ressources graphiques : BaahBox-assets (https://github.com/Orange-OpenSource/BaahBox-assets)

© 2026 Orange SA. Distribué sous licence GPL v3.

×
