Orange-OpenSource/BaahBox-Arduino/docs/assets/images/doc/BaahBox/manual/capteurs.webp

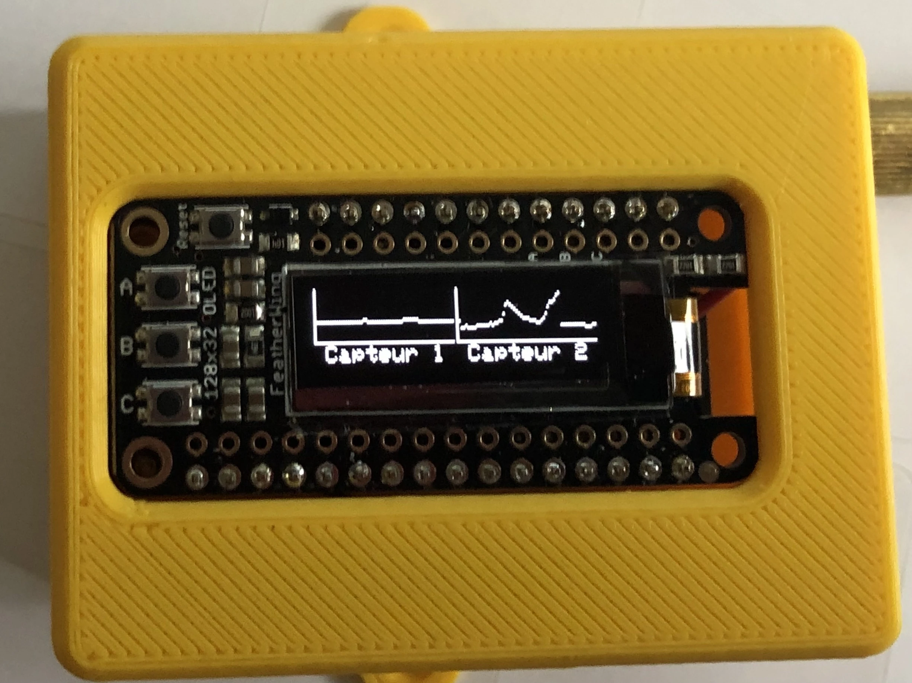
docs/assets/images/doc/BaahBox/manual/capteurs.webp
