Orange-OpenSource/BaahBox-Arduino/docs/assets/images/doc/BaahStick/build/BatterieLipo.webp

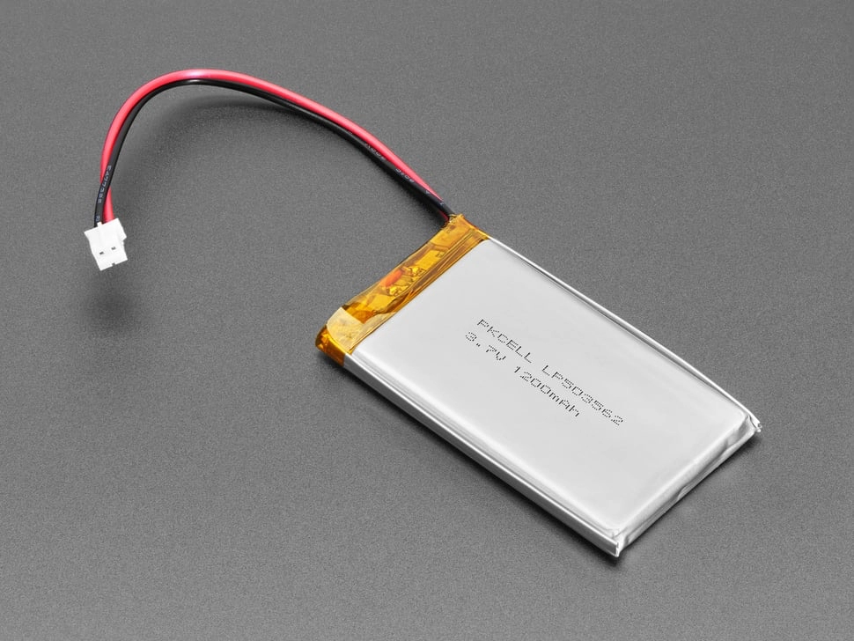
docs/assets/images/doc/BaahStick/build/BatterieLipo.webp
