Orange-OpenSource/BaahBox-Arduino/docs/assets/images/doc/BaahStick/build/connectionADAFruit_jst-PH.webp

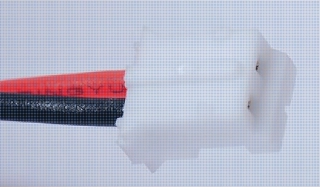
docs/assets/images/doc/BaahStick/build/connectionADAFruit_jst-PH.webp
