Orange-OpenSource/BaahBox-Arduino/docs/assets/images/doc/BaahStick/build/DerivationBatterieInter.webp

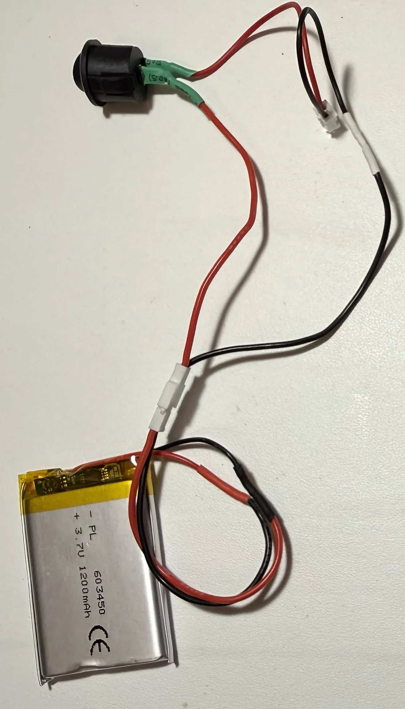
docs/assets/images/doc/BaahStick/build/DerivationBatterieInter.webp
