Orange-OpenSource/BaahBox-Arduino/docs/assets/images/doc/BaahStick/build/FeatherM0Bluefruit.png

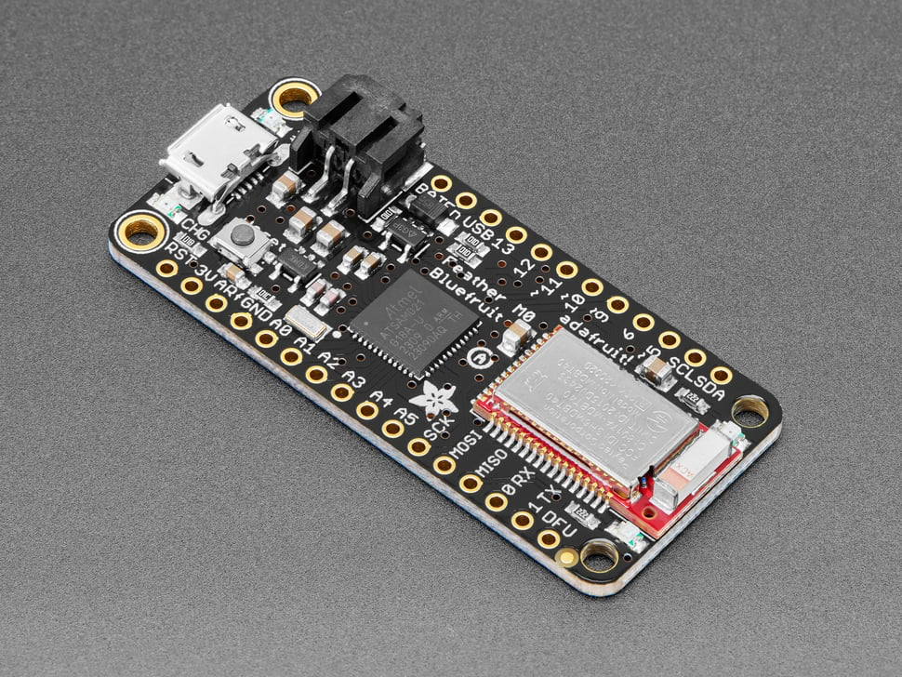
docs/assets/images/doc/BaahStick/build/FeatherM0Bluefruit.png
