Orange-OpenSource/BaahBox-Arduino/docs/assets/images/doc/BaahStick/build/FeatherM0BlueFruit.webp

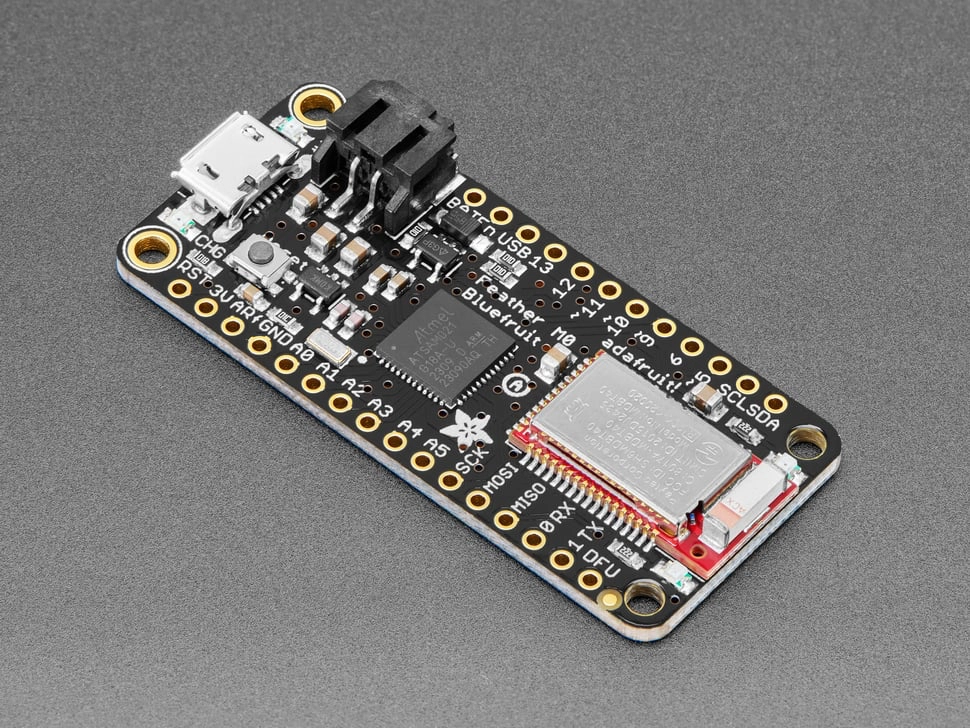
docs/assets/images/doc/BaahStick/build/FeatherM0BlueFruit.webp
