Orange-OpenSource/BaahBox-Arduino/docs/assets/images/doc/BaahStick/build/FeathernRF52840.webp

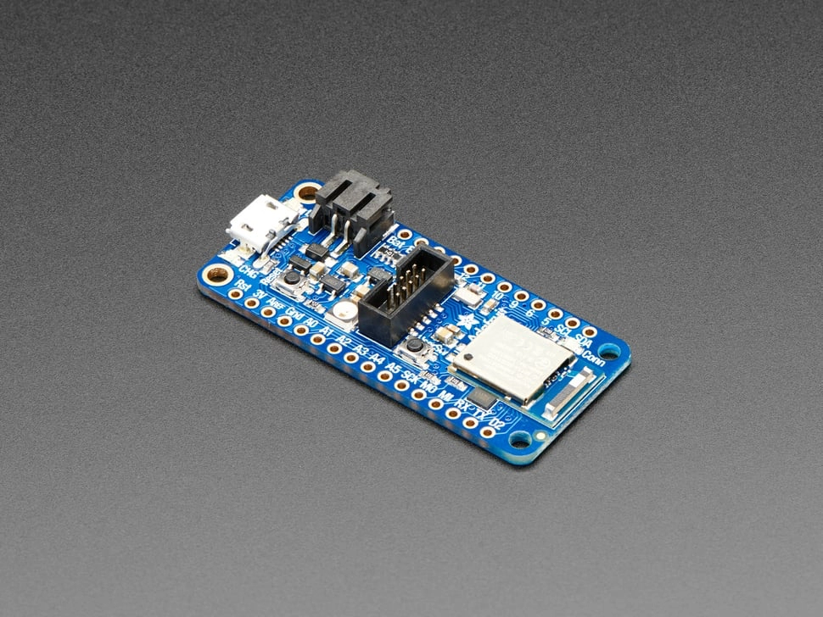
docs/assets/images/doc/BaahStick/build/FeathernRF52840.webp
