Orange-OpenSource/BaahBox-Arduino/docs/assets/images/doc/BaahStick/build/FeatherSatckerHeaders.webp

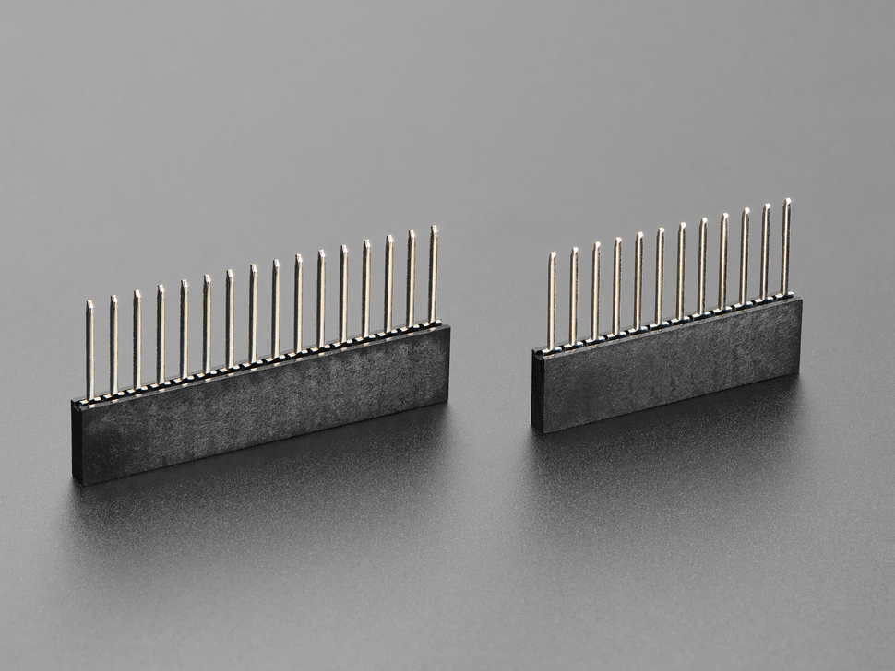
docs/assets/images/doc/BaahStick/build/FeatherSatckerHeaders.webp
