Orange-OpenSource/BaahBox-Arduino/docs/assets/images/doc/BaahStick/build/FeatherWingOled.webp

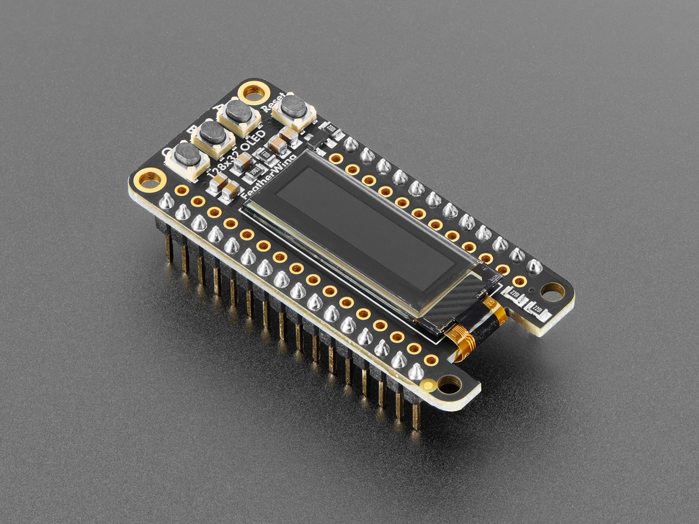
docs/assets/images/doc/BaahStick/build/FeatherWingOled.webp
