Orange-OpenSource/BaahBox-Arduino/docs/assets/images/doc/BaahStick/build/IMG_0618.webp

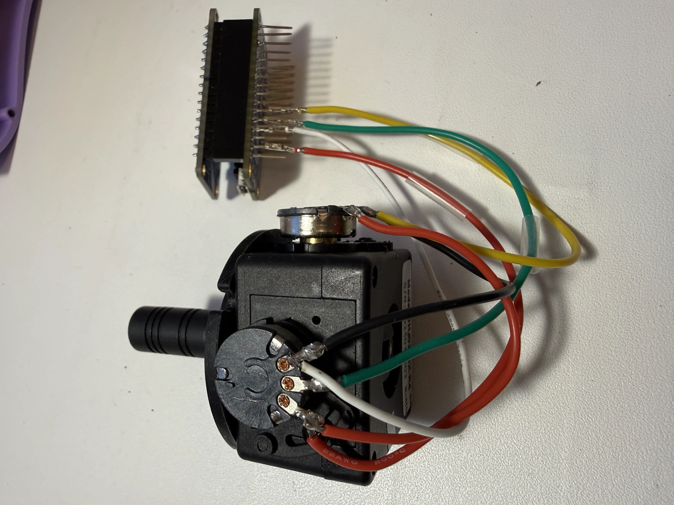
docs/assets/images/doc/BaahStick/build/IMG_0618.webp
