Orange-OpenSource/BaahBox-Arduino/docs/assets/images/doc/BaahStick/build/IMG_0625.webp

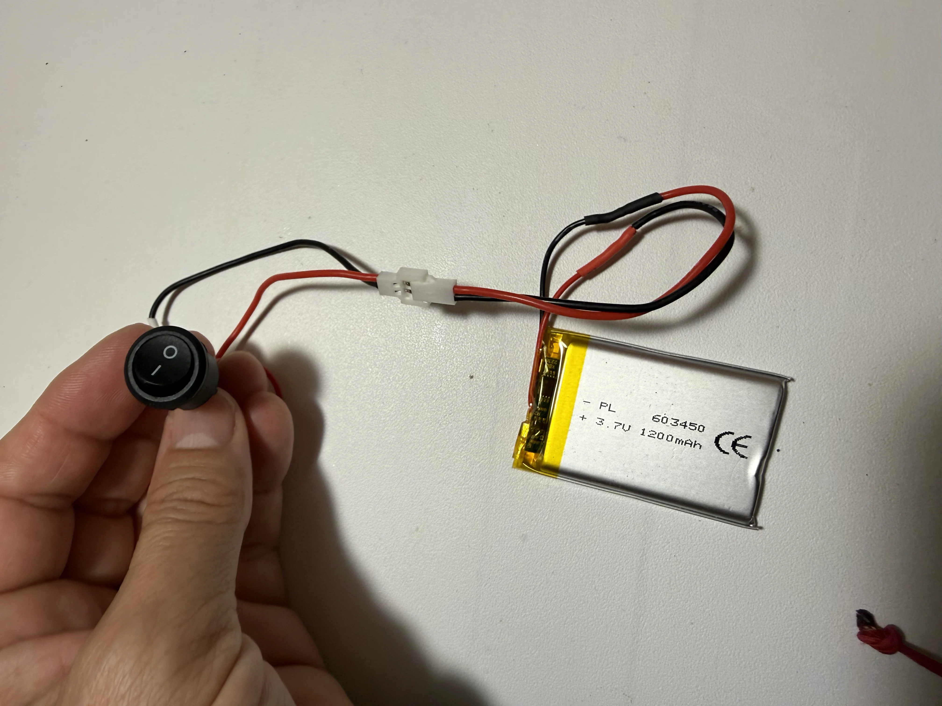
docs/assets/images/doc/BaahStick/build/IMG_0625.webp
