Orange-OpenSource/BaahBox-Arduino/docs/assets/images/doc/BaahStick/build/IMG_0629.webp

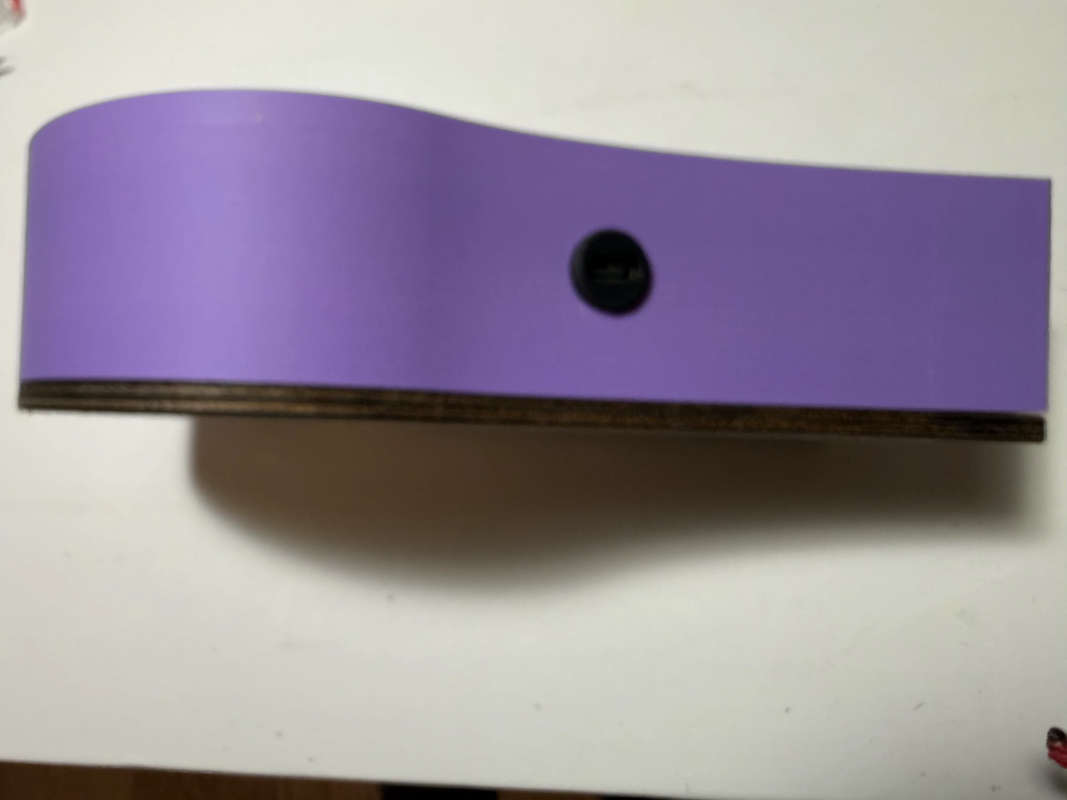
docs/assets/images/doc/BaahStick/build/IMG_0629.webp
