Orange-OpenSource/BaahBox-Arduino/docs/assets/images/doc/BaahStick/build/IMG_0655.webp

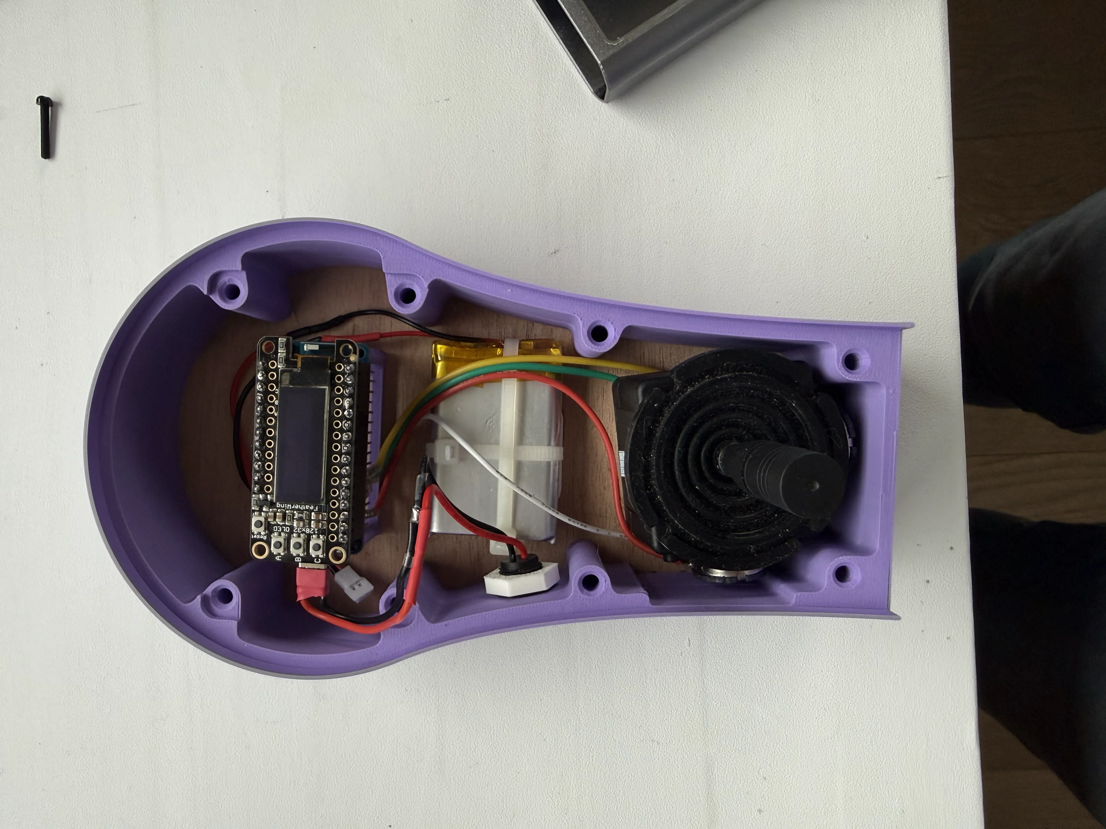
docs/assets/images/doc/BaahStick/build/IMG_0655.webp
