Orange-OpenSource/BaahBox-Arduino/docs/assets/images/doc/BaahStick/build/IMG_0657.webp

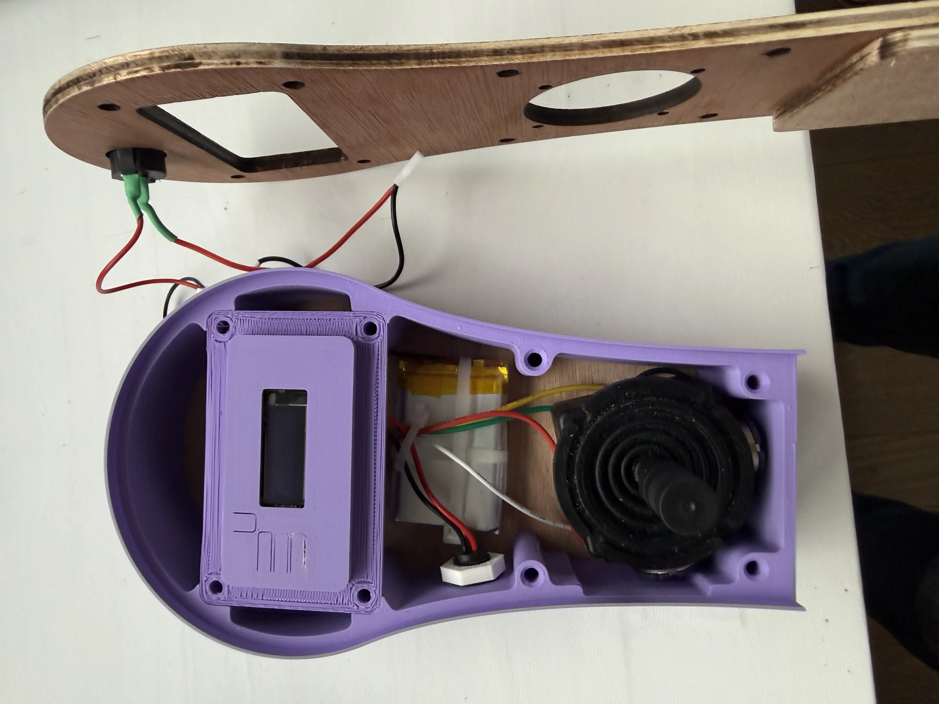
docs/assets/images/doc/BaahStick/build/IMG_0657.webp
