Orange-OpenSource/BaahBox-Arduino/docs/assets/images/doc/BaahStick/build/IMG_0658.webp

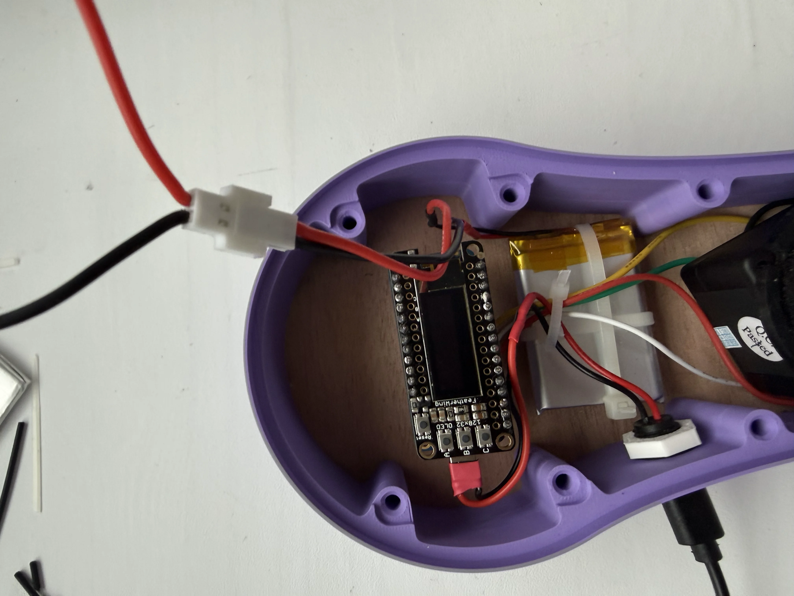
docs/assets/images/doc/BaahStick/build/IMG_0658.webp
