Orange-OpenSource/BaahBox-Arduino/docs/assets/images/doc/BaahStick/build/IMG_0660.webp

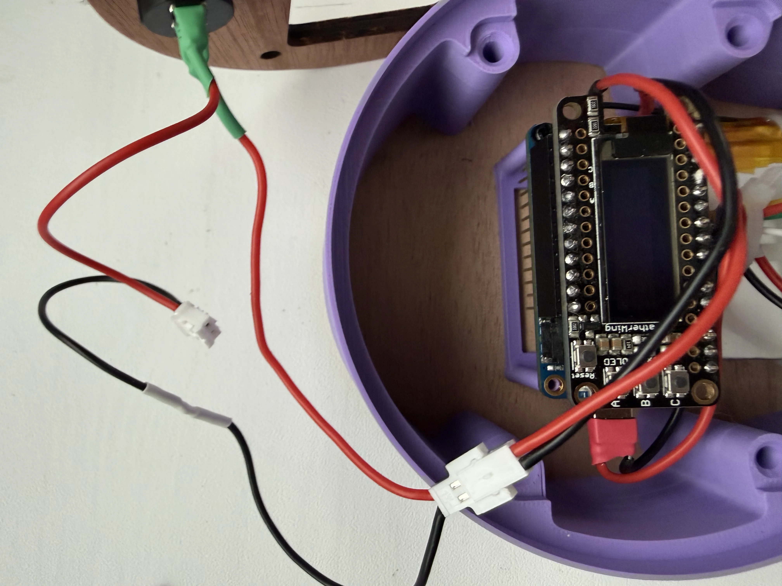
docs/assets/images/doc/BaahStick/build/IMG_0660.webp
