Orange-OpenSource/BaahBox-Arduino/docs/assets/images/doc/BaahStick/build/IMG_0669.webp

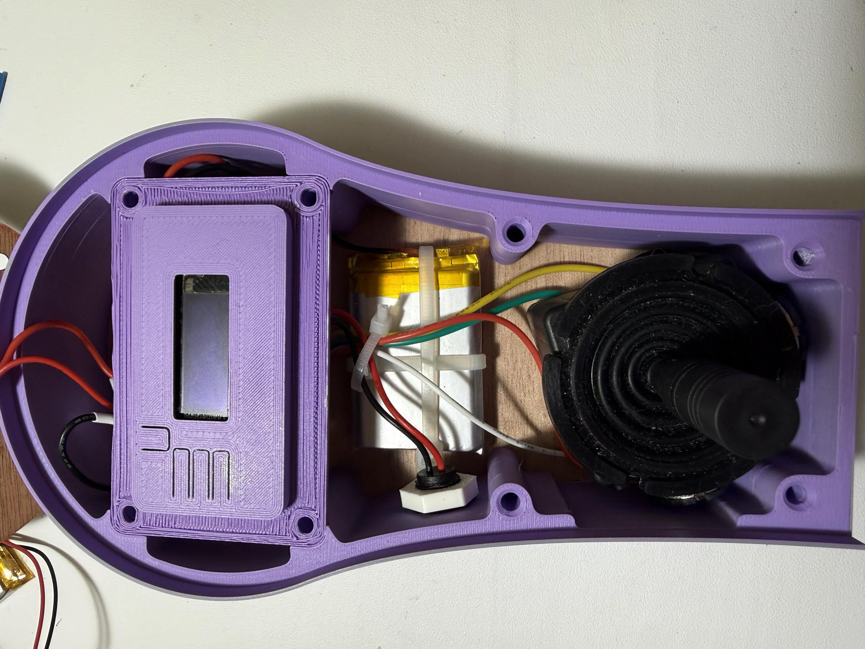
docs/assets/images/doc/BaahStick/build/IMG_0669.webp
