Orange-OpenSource/BaahBox-Arduino/docs/assets/images/doc/BaahStick/build/JoystickR4.webp

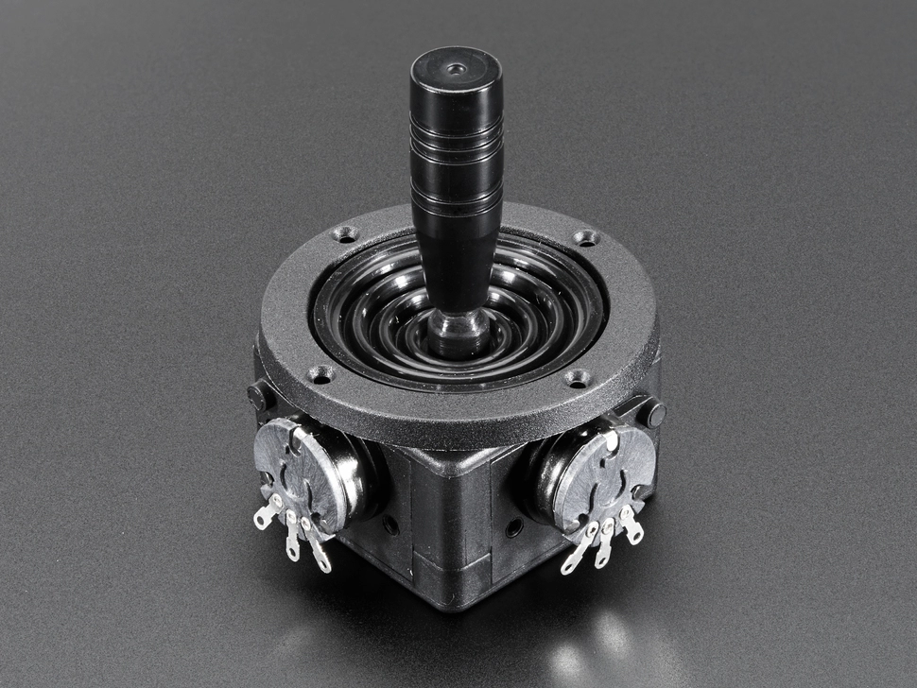
docs/assets/images/doc/BaahStick/build/JoystickR4.webp
