Orange-OpenSource/BaahBox-Arduino/docs/assets/images/doc/BaahStick/build/jst-ph-cable.webp

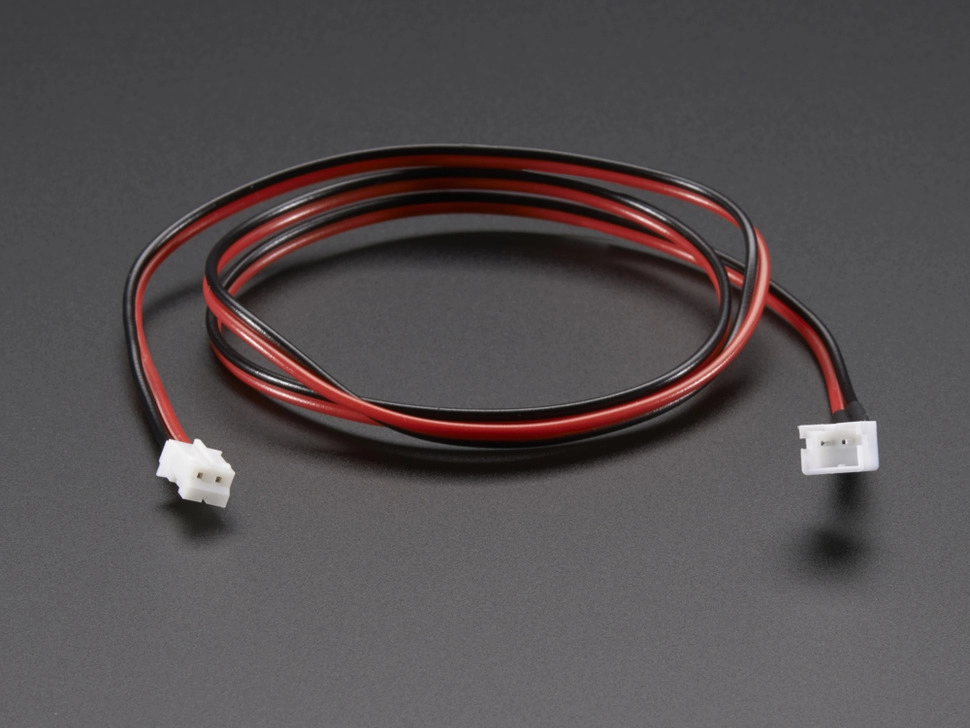
docs/assets/images/doc/BaahStick/build/jst-ph-cable.webp
