Orange-OpenSource/BaahBox-Arduino/docs/assets/images/doc/BaahStick/build/jst-ph-femelle.webp

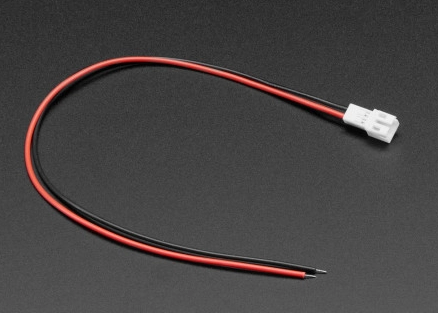
docs/assets/images/doc/BaahStick/build/jst-ph-femelle.webp
