Orange-OpenSource/BaahBox-Arduino/docs/assets/images/doc/BaahStick/build/jst-ph-male.webp

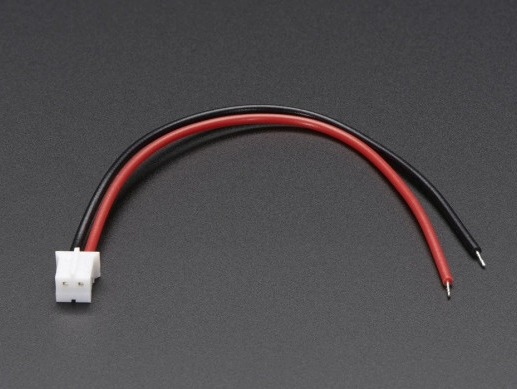
docs/assets/images/doc/BaahStick/build/jst-ph-male.webp
