Orange-OpenSource/BaahBox-Arduino/docs/assets/images/doc/BaahStick/build/M4_tetePlate.webp

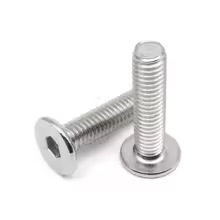
docs/assets/images/doc/BaahStick/build/M4_tetePlate.webp
