Orange-OpenSource/BaahBox-Arduino/docs/assets/images/doc/BaahStick/build/MicroUSB_male_plug.webp

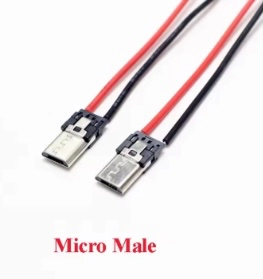
docs/assets/images/doc/BaahStick/build/MicroUSB_male_plug.webp
