Orange-OpenSource/BaahBox-Arduino/docs/assets/images/doc/BaahStick/build/miniInterBascule.webp

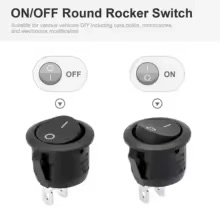
docs/assets/images/doc/BaahStick/build/miniInterBascule.webp
