Orange-OpenSource/BaahBox-Arduino/docs/assets/images/doc/BaahStick/build/priseUSB-C_femelle.webp

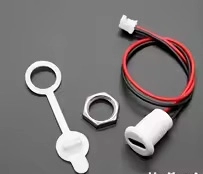
docs/assets/images/doc/BaahStick/build/priseUSB-C_femelle.webp
