Orange-OpenSource/BaahBox-Arduino/docs/assets/images/doc/BaahStick/build/visPlastiqueM2_5.webp

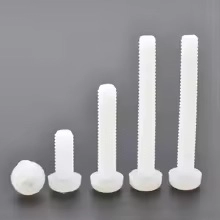
docs/assets/images/doc/BaahStick/build/visPlastiqueM2_5.webp
