Orange-OpenSource/BaahBox-Arduino/docs/assets/images/doc/BaahStick/manual/JoyCache.png

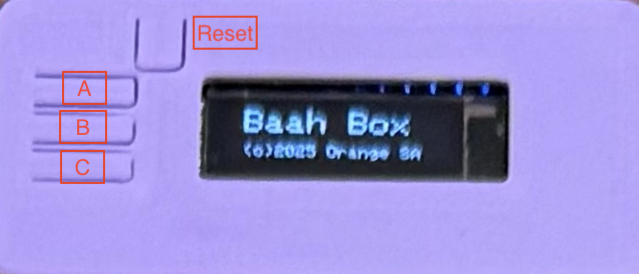
docs/assets/images/doc/BaahStick/manual/JoyCache.png
