Orange-OpenSource/BaahBox-Arduino/docs/assets/images/doc/BaahStick/manual/JoyCache.webp

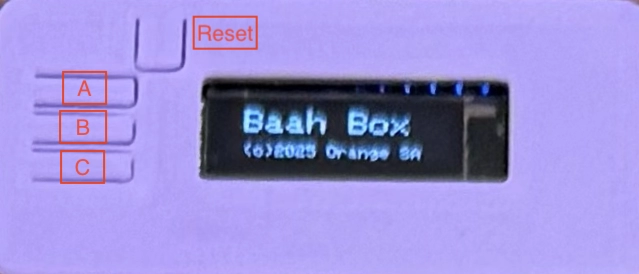
docs/assets/images/doc/BaahStick/manual/JoyCache.webp
