Orange-OpenSource/BaahBox-Arduino/documentation/fr/DB9_soldered_postionned-1.jpeg

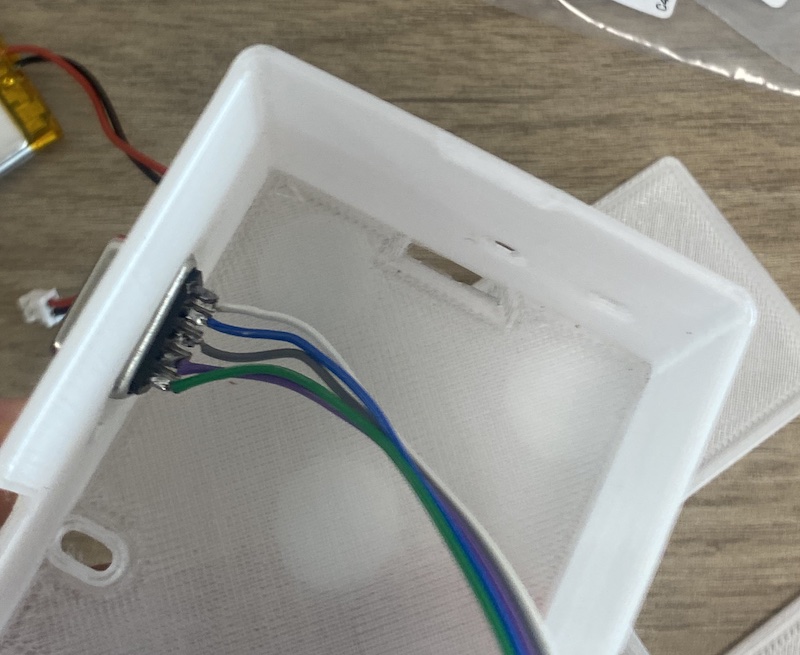
documentation/fr/DB9_soldered_postionned-1.jpeg
