Orange-OpenSource/BaahBox-Arduino/documentation/img/BaahBoxManual/inter.jpg

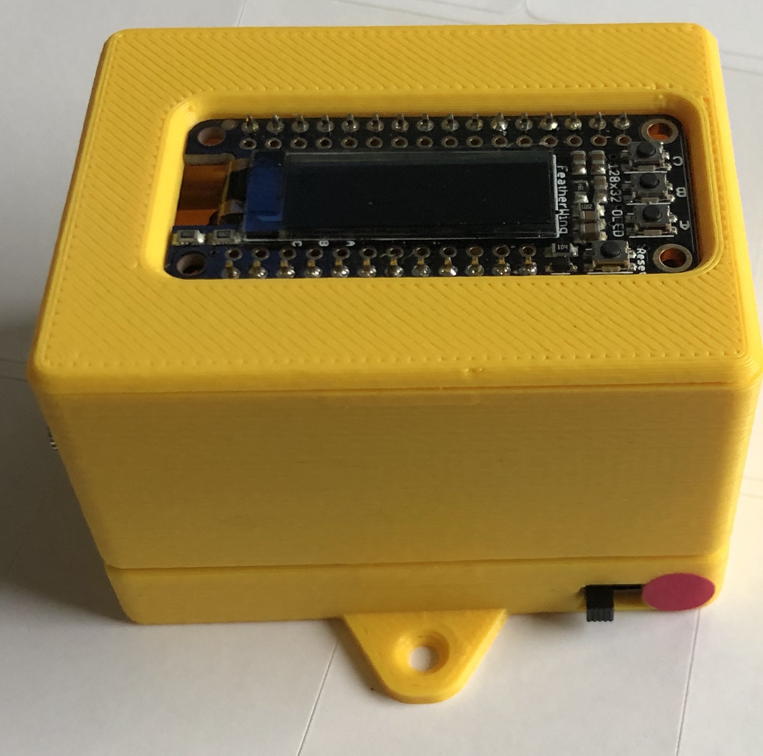
documentation/img/BaahBoxManual/inter.jpg
