Orange-OpenSource/BaahBox-Arduino/documentation/img/BaahBoxManual/points.jpg

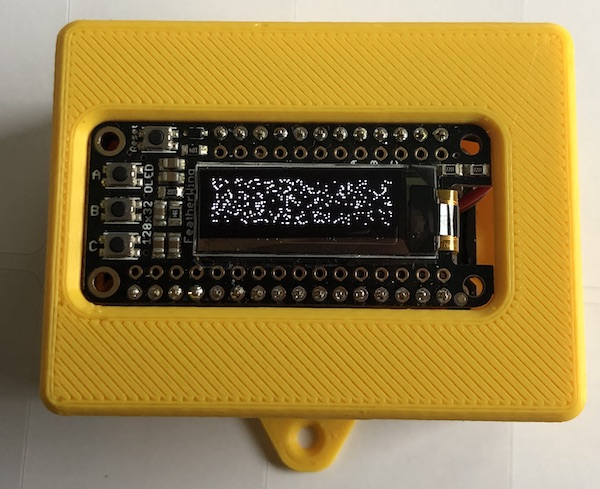
documentation/img/BaahBoxManual/points.jpg
