Orange-OpenSource/BaahBox-Arduino/documentation/img/BaahBoxManual/Screen Shot 2019-01-24 at 05.43.27.png

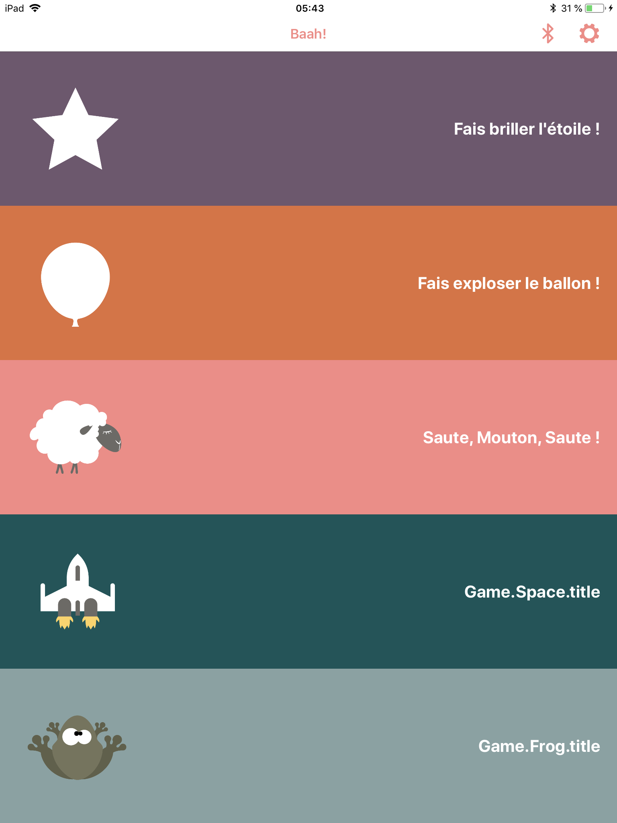
documentation/img/BaahBoxManual/Screen Shot 2019-01-24 at 05.43.27.png
