Orange-OpenSource/BaahBox-Arduino/documentation/img/BaahBoxManual/Screen Shot 2019-01-24 at 05.45.03.png

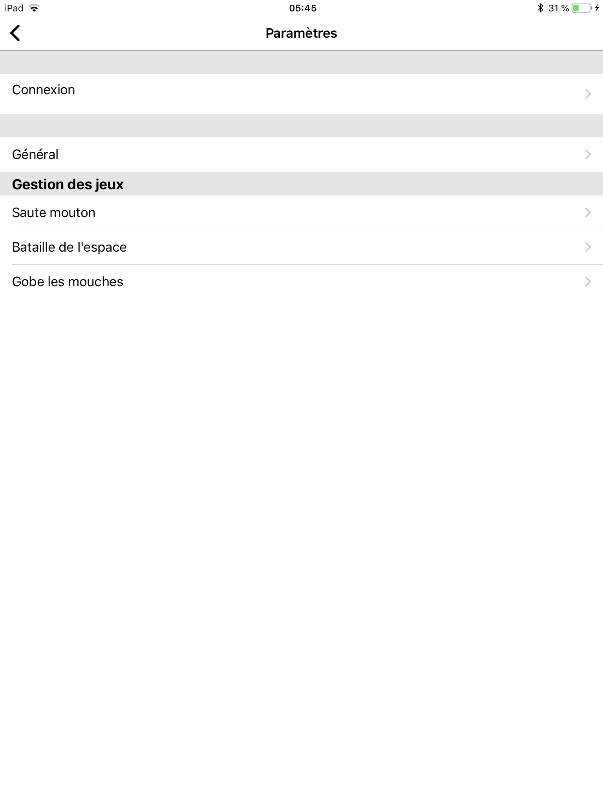
documentation/img/BaahBoxManual/Screen Shot 2019-01-24 at 05.45.03.png
