Orange-OpenSource/BaahBox-Arduino/CHANGELOG.md

# Changelog

## 2.0.0

* Compatible with iOS app version 1.0.0
* Compatible with Android app version 0.6.0
* Support muscles sensors
* Support joystick
