Orange-OpenSource/BaahBox-Arduino/(threads)

Thread 1 (2019-08-22):

Baah box sends frames with false inputs

pylapp, 2019-08-22:
It seems _Baah box_ broadcasts Bluetooth Low Energy frames with some noise.
Indeed while using a slider plugged to the box, with no actions made on this slider, the box sends frames with non-null sensor data.
These fake frames parasite the app which thus receives inputs made by... noone.

See below a sample of a BLE frame received by the app from the _Baah box_  where nothing has been done on the slider. In this case there are inputs on the two muscles channels.

```
BLE frame: C1 | a1 | C2 | a2 | JBin | 90
BLE frame: 28 | 0 | 90 | 0 | 1 | 90
```

pylapp, 2019-08-29:
Here another sample of received BLE frames with a slider in lowest position

```
BLE characteristic for sensor - <9 | 0 | 90 | 0 | 1 | 8>, giving muscle 1 = 288, muscle 2 = 2880
BLE characteristic for sensor - <1 | 10 | 9 | 0 | 90 | 12>, giving muscle 1 = 42, muscle 2 = 288
BLE characteristic for sensor - <1 | 12 | 21 | 0 | 90 | 8>, giving muscle 1 = 44, muscle 2 = 672
BLE characteristic for sensor - <1 | 12 | 4 | 0 | 90 | 12>, giving muscle 1 = 44, muscle 2 = 128
BLE characteristic for sensor - <23 | 0 | 90 | 0 | 1 | 10>, giving muscle 1 = 736, muscle 2 = 2880
BLE characteristic for sensor - <1 | 11 | 9 | 0 | 90 | 8>, giving muscle 1 = 43, muscle 2 = 288
BLE characteristic for sensor - <3 | 0 | 90 | 0 | 2 | 7>, giving muscle 1 = 96, muscle 2 = 2880
BLE characteristic for sensor - <1 | 10 | 30 | 0 | 90 | 6>, giving muscle 1 = 42, muscle 2 = 960
BLE characteristic for sensor - <1 | 10 | 1 | 0 | 90 | 7>, giving muscle 1 = 42, muscle 2 = 32
```

frederiquepinson, 2024-06-20:
bad parsing of inputs

Closed 2024-06-20.

Thread 2 (2019-08-29):

Baah box sends frames with parasite value (too low or to high)

pylapp, 2019-08-29:
Sometimes some BLE frames have been received with parasite value.

For example, when computing muscles values form sensor inputs, some "pic" values are received like 90 (when a slider in high position) or 2088 (even if values should be in [0 ; 1024]

frederiquepinson, 2024-06-20:
bug fixed

Closed 2024-06-20.
