Orange-OpenSource/BaahBox-Arduino/(commit log)

2019-07-25 chore: project - 🎉 first init after gotten corporate GO
    [SYSTEM.CFG, USER.CFG]
2019-07-25 doc: project - 📝 add CHANGELOG
2019-07-25 doc: project - 📝 add README
2020-02-04 enhancing the documentation
    [USER.CFG]
2020-02-07 Transtale doc j luc (#5)
    * test update
    testing signed commit to init documentation
    * cleaning images
    * replacing temporary documentation
    * typo
    * fixed authors' list
    * readme update
    * update baahbox doc
    * added french doc
    * added english doc
    Signed-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
    [USER.CFG]
2020-02-09 rename img name (avoid upper case for prefix)
2020-02-10 putting BOM translations in 2 different files
2020-02-10 Bom (#13)
    * BOM fixing
    * BOM fixing
    * BOM fixing
    * BOM fixing
2020-02-13 added sensord building doc
2020-02-13 Sensors (#14)
    * added sensord building doc
    * added sensord building doc
2020-02-17 added sensors building doc
2020-02-17 fixed sensord building doc
2020-02-17 fixed sensors building doc (en)
2022-07-13 2022 fix (#15)
    * Project now compiles with latest arduino IDE (2.0.0-rc as well 1.8.9) with latest versions of librairies to include.
    * minor updates
    [SYSTEM.CFG, USER.CFG]
2023-04-03 added PlatformIO Set up, updated Arduino documentation and code accordingly
    [SYSTEM.CFG, USER.CFG]
2023-04-03 updated .gitignore for Arduino repo (PlatformIO) updated documentation to build sensors updated general documentation
2023-10-05 update BOM V2
2023-10-06 added STL for BaahBox v2, DXF files for the joystick documentation update
    [joystick-plate-mini.dxf, joystick-plate.dxf]
2023-10-06 added corners stl for the joystick box
    [angle.stl]
2023-10-06 fixed BOM image
2023-10-06 update stl link for BaahBox v2
2023-10-06 fix include refs of Arduino for PiO
    [baah-box.ino, display.cpp, muscleSensor.cpp, scheduler.cpp, tools.cpp]
2023-10-30 Joystick v2 dxf files update
    [joystick-plate-mini.dxf, joystick-plate.dxf]
2023-11-29 update BOM files
2023-11-29 update english BOM
2023-11-29 update link to stl files
2024-02-22 added v2024 (baahbox 3D print)
    [BaahBox_v2_2024.stl]
2025-09-05 added first static page version
    [BaahBox_v2_2024.stl]
2025-10-23 M0 Bluefruit OK and running NRF52 to be completed ESP32S3 on going
2025-10-24 first steps for ESP32S3 Reverse TFT need to adapt plotting to the screen
    [baah-box.ino, btle.cpp, btle.hpp, btleNrf51.cpp, btleNrf51.hpp, configSD.cpp]
2026-04-13 update wheel chair presention page
2026-04-13 commit de tout depuis le 5janv
2026-08-26 added BOM for BaahBox V2
2026-08-26 update bom location
2026-09-02 hardware models for the WCjoystick
    [BaahBox_JoystickFR.3mf, BaahBox_joystickWC_Bottom.dxf, BaahBox_joystickWC_Top.dxf, BaahBox_joystickWC_support.dxf]
2026-09-02 added BOM for WC Joystick
2026-09-03 BOM finalized
2026-09-07 updated joystick assembly
2026-09-14 update links and code fix
    [BaahBox_JoystickFR.3mf, BaahBox_joystickWC_Bottom.dxf, BaahBox_joystickWC_Top.dxf, BaahBox_joystickWC_support.dxf, BaahBox_v2_2024.stl]
